Aldarme/PROJECT_CHAMP/Gantt/calendrier_Previsionnel_portrait.pdf

Projet_CHAMP | 1 juil. 2018
Laboratoire de Physique nucléaire et des Hautes Energies | http://

Chef de projet
Dates du projet | 5 févr. 2018 - 14 juil. 2018
Avancée | 0%
Tâches | 39
Ressources | 0

Nom | Date de début | Date de fin
Arrivé & prise de contact | 05/02/2018 | 09/02/2018
Prise en main du projet | 12/02/2018 | 16/02/2018
Découverte & apprentissage du VHDL | 19/02/2018 | 20/02/2018
mise en pratique VHDL | 22/02/2018 | 28/02/2018
Prototype maquette piano à une touche | 01/03/2018 | 18/05/2018
Module accéléromètre | 01/03/2018 | 23/03/2018
étude comparative I2C vs SPI | 01/03/2018 | 02/03/2018
étude des registres de contrôle à paramétrer | 05/03/2018 | 06/03/2018
Hack du controle SPI accéléromètre | 07/03/2018 | 09/03/2018
Dev. code VHDL communication accéléromètre | 12/03/2018 | 23/03/2018
Module FIltre | 26/03/2018 | 20/04/2018
Acquisition des données | 26/03/2018 | 27/03/2018
caractérisation des données et interprétation | 28/03/2018 | 30/03/2018
Asservissement numérique | 03/04/2018 | 20/04/2018
expérence en labo pour production des données | 03/04/2018 | 06/04/2018
étude de graph-établir fonction de transfère | 09/04/2018 | 13/04/2018
calcule de la fonction de transfère | 16/04/2018 | 18/04/2018
intégration fonction transfère au module vhdl | 19/04/2018 | 20/04/2018
Module DAC | 23/04/2018 | 18/05/2018
reception des données | 23/04/2018 | 24/04/2018
transmision sous module SPI | 25/04/2018 | 26/04/2018
Adaptation module spi existant | 27/04/2018 | 02/05/2018
configuration des registre de contrôle du DAC | 03/05/2018 | 04/05/2018
mesure physique en sortie de DAC et débugage | 07/05/2018 | 18/05/2018
Conception carte électronique | 23/05/2018 | 21/06/2018
formation au plassement routage sous KICAD | 23/05/2018 | 24/05/2018
PCB miniaturisation accéléromètre | 25/05/2018 | 01/06/2018
PCB amplificateur de signaux | 04/06/2018 | 08/06/2018
PCB mezzanine - carte à connecteurs | 11/06/2018 | 15/06/2018
formation production & assemblage des cartes | 18/06/2018 | 21/06/2018
mesure et caractérisation de la chaine de contrôle | 22/06/2018 | 06/07/2018
caractérisation de l'accélération fournie par l'accélérpmètre | 22/06/2018 | 25/06/2018
expérimentation des diffénrents mode de contrôle fournie par le contrôleur moteur | 26/06/2018 | 28/06/2018
conception d'une maquette pour caractériser le contrôle "TORQUE" du contôleur | 29/06/2018 | 04/07/2018
exploitation des données | 05/07/2018 | 06/07/2018
prototype maquette piano à 12 touches | 09/07/2018 | 13/07/2018
déploiement de generate pour dupliquer les module accéléromètre et filtre | 09/07/2018 | 10/07/2018
adaptation du vhdl pour intégration module DAC à la réception des modules dupliqués | 11/07/2018 | 12/07/2018
Projet_CHAMP | 1 juil. 2018
Tâches | 2

Nom | Date de début | Date de fin
test | 13/07/2018 | 13/07/2018

## Tâches

## Diagramme de Gantt

Nom | Date de... | Date de fin
Arrivé & prise de contact | 05/02/2... 09/02/2018
Prise en main du projet | 12/02/2... 16/02/2018

Découverte & apprentissage ...19/02/2... 20/02/2018

mise en pratique VHDL | 22/02/2... 28/02/2018

Prototype maquette piano à ... 01/03/2... 18/05/2018

Module accéléromètre | 01/03/2... 23/03/2018

étude comparative I2... 01/03/2... 02/03/2018

étude des registres de...05/03/2... 06/03/2018

Hack du controle SPI ... 07/03/2... 09/03/2018

Dev. code VHDL com... 12/03/2... 23/03/2018

Module FIltre | 26/03/2... 20/04/2018

Acquisition des données26/03/2... 27/03/2018

caractérisation des do... 28/03/2... 30/03/2018

Asservissement numé... 03/04/2... 20/04/2018

expérence en labo ...03/04/2... 06/04/2018

étude de graph-ét... 09/04/2... 13/04/2018

calcule de la foncti... 16/04/2... 18/04/2018

intégration fonctio... 19/04/2... 20/04/2018

Module DAC | 23/04/2... 18/05/2018

reception des données 23/04/2... 24/04/2018

transmision sous mod... 25/04/2... 26/04/2018

Adaptation module sp... 27/04/2... 02/05/2018

configuration des regi... 03/05/2... 04/05/2018

mesure physique en s... 07/05/2... 18/05/2018

Conception carte électronique 23/05/2... 21/06/2018

formation au plassement ...23/05/2... 24/05/2018

PCB miniaturisation accél... 25/05/2... 01/06/2018

PCB amplificateur de sign...04/06/2... 08/06/2018

PCB mezzanine - carte à ... 11/06/2... 15/06/2018

formation production & a... 18/06/2... 21/06/2018

mesure et caractérisation de... 22/06/2... 06/07/2018

caractérisation de l'accél... 22/06/2... 25/06/2018

expérimentation des diffé...26/06/2... 28/06/2018

conception d'une maque... 29/06/2... 04/07/2018

exploitation des données 05/07/2... 06/07/2018

prototype maquette piano à ... 09/07/2... 13/07/2018

déploiement de generate... 09/07/2... 10/07/2018

adaptation du vhdl pour i... 11/07/2... 12/07/2018

test | 13/07/2... 13/07/2018

2018

Semaine 8 | Semaine 9 | Semaine 10 | Semaine 11 | Semaine 12 | Semaine 13 | Semaine 14 | Semaine 15 | Semaine 16 | Semaine 17 | Semaine 18 | Semaine 19 | Semaine 20 | Semaine 21 | Semaine 22 | Semaine 23 | Semaine 24
18/02/2018 | 25/02/2018 | 04/03/2018 | 11/03/2018 | 18/03/2018 | 25/03/2018 | 01/04/2018 | 08/04/2018 | 15/04/2018 | 22/04/2018 | 29/04/2018 | 06/05/2018 | 13/05/2018 | 20/05/2018 | 27/05/2018 | 03/06/2018 | 10/06/2018

## Diagramme des Ressources

Nom | Rôle par déf...

2018

Semaine 8 | Semaine 9 | Semaine 10 | Semaine 11 | Semaine 12 | Semaine 13 | Semaine 14 | Semaine 15 | Semaine 16 | Semaine 17 | Semaine 18 | Semaine 19 | Semaine 20 | Semaine 21 | Semaine 22 | Semaine 23 | Semaine 24
18/02/2018 | 25/02/2018 | 04/03/2018 | 11/03/2018 | 18/03/2018 | 25/03/2018 | 01/04/2018 | 08/04/2018 | 15/04/2018 | 22/04/2018 | 29/04/2018 | 06/05/2018 | 13/05/2018 | 20/05/2018 | 27/05/2018 | 03/06/2018 | 10/06/2018
