Aldarme/PROJECT_CHAMP/Gantt/calendrier_reel_portrait.pdf

Projet_CHAMP | 1 juil. 2018
Laboratoire de Physique nucléaire et des Hautes Energies | http://

Chef de projet
Dates du projet | 5 févr. 2018 - 14 juil. 2018
Avancée | 0%
Tâches | 44
Ressources | 0

Nom | Date de début | Date de fin
Arrivé & prise de contact | 05/02/2018 | 09/02/2018
Prise en main du projet | 12/02/2018 | 16/02/2018
Découverte & apprentissage du VHDL | 19/02/2018 | 20/02/2018
mise en pratique VHDL | 22/02/2018 | 28/02/2018
Prototype maquette piano à une touche | 01/03/2018 | 10/07/2018
Module accéléromètre | 01/03/2018 | 23/03/2018
étude comparative I2C vs SPI | 01/03/2018 | 02/03/2018
étude des registres de contrôle à paramétrer | 05/03/2018 | 06/03/2018
Hack du controle SPI accéléromètre | 07/03/2018 | 09/03/2018
Dev. code VHDL communication accéléromètre | 12/03/2018 | 23/03/2018
Module FIltre | 26/03/2018 | 20/04/2018
Acquisition des données | 26/03/2018 | 27/03/2018
caractérisation des données et interprétation | 28/03/2018 | 30/03/2018
Asservissement numérique | 03/04/2018 | 20/04/2018
expérence en labo pour production des données | 03/04/2018 | 06/04/2018
étude de graph-établir fonction de transfère | 09/04/2018 | 13/04/2018
calcule de la fonction de transfère | 16/04/2018 | 18/04/2018
intégration fonction transfère au module vhdl | 19/04/2018 | 20/04/2018
Module DAC | 23/04/2018 | 18/05/2018
reception des données | 23/04/2018 | 24/04/2018
transmision sous module SPI | 25/04/2018 | 26/04/2018
Adaptation module spi existant | 27/04/2018 | 02/05/2018
configuration des registre de contrôle du DAC | 03/05/2018 | 04/05/2018
mesure physique en sortie de DAC | 07/05/2018 | 18/05/2018
debuggage chaine de meusure | 18/05/2018 | 10/07/2018
caractérisatoin problèmes de métastabilité | 22/05/2018 | 24/05/2018
intégration de librairie Altera | 25/05/2018 | 28/05/2018
mise à jours des modules défectueux | 18/05/2018 | 29/05/2018
test de contrôle & validation | 29/05/2018 | 10/07/2018
formation au plassement routage sous KICAD | 23/05/2018 | 21/06/2018
formation au plassement routage sous KICAD | 23/05/2018 | 24/05/2018
PCB miniaturisation accéléromètre | 25/05/2018 | 01/06/2018
PCB amplificateur de signaux | 04/06/2018 | 08/06/2018
PCB mezzanine - carte à connecteurs | 11/06/2018 | 15/06/2018
formation production & assemblage des cartes | 18/06/2018 | 21/06/2018
prototype maquette piano à 12 touches | 09/07/2018 | 13/07/2018
déploiement de generate pour dupliquer les module accéléromètre et filtre | 09/07/2018 | 10/07/2018
adaptation du vhdl pour intégration module DAC à la réception des modules dupliqués | 11/07/2018 | 12/07/2018
test | 13/07/2018 | 13/07/2018
Projet_CHAMP | 1 juil. 2018
Tâches | 2

Nom | Date de début | Date de fin
mesure et caractérisation de la chaine de contrôle | 22/06/2018 | 06/07/2018
caractérisation de l'accélération fournie par l'accélérpmètre | 22/06/2018 | 25/06/2018
expérimentation des diffénrents mode de contrôle fournie par le contrôleur moteur | 26/06/2018 | 28/06/2018
conception d'une maquette pour caractériser le contrôle "TORQUE" du contôleur | 29/06/2018 | 04/07/2018
exploitation des données | 05/07/2018 | 06/07/2018
Tâches | 3

## Diagramme de Gantt

4

Nom | Date d... | Date de fin
Arrivé & prise de contact | 05/02/... 09/02/2018
Prise en main du projet | 12/02/... 16/02/2018

Découverte & apprentissag... 19/02/... 20/02/2018

mise en pratique VHDL | 22/02/... 28/02/2018

Prototype maquette piano ... 01/03/... 10/07/2018

Module accéléromètre 01/03/... 23/03/2018

étude comparative I... 01/03/... 02/03/2018

étude des registres ... 05/03/... 06/03/2018

Hack du controle SPI... 07/03/... 09/03/2018

Dev. code VHDL co... 12/03/... 23/03/2018

Module FIltre | 26/03/... 20/04/2018

Acquisition des donn... 26/03/... 27/03/2018

caractérisation des d...28/03/... 30/03/2018

Asservissement num...03/04/... 20/04/2018

expérence en lab... 03/04/... 06/04/2018

étude de graph-é... 09/04/... 13/04/2018

calcule de la fonc...16/04/... 18/04/2018

intégration foncti... 19/04/... 20/04/2018

Module DAC | 23/04/... 18/05/2018

reception des données23/04/... 24/04/2018

transmision sous mo... 25/04/... 26/04/2018

Adaptation module s... 27/04/... 02/05/2018

configuration des re... 03/05/... 04/05/2018

mesure physique en... 07/05/... 18/05/2018

debuggage chaine de ... 18/05/... 10/07/2018

caractérisatoin probl... 22/05/... 24/05/2018

intégration de librairi...25/05/... 28/05/2018

mise à jours des mo... 18/05/... 29/05/2018

test de contrôle & va...29/05/... 10/07/2018

formation au plassement ro...23/05/... 21/06/2018

formation au plassemen...23/05/... 24/05/2018

PCB miniaturisation acc... 25/05/... 01/06/2018

PCB amplificateur de sig...04/06/... 08/06/2018

PCB mezzanine - carte à...11/06/... 15/06/2018

formation production & ... 18/06/... 21/06/2018

prototype maquette piano ... 09/07/... 13/07/2018

déploiement de generat... 09/07/... 10/07/2018

adaptation du vhdl pou... 11/07/... 12/07/2018

test | 13/07/... 13/07/2018

mesure et caractérisation d...22/06/... 06/07/2018

caractérisation de l'accé...22/06/... 25/06/2018

expérimentation des dif... 26/06/... 28/06/2018

conception d'une maqu... 29/06/... 04/07/2018

exploitation des données 05/07/... 06/07/2018

janvier 2018 | février 2018 | mars 2018
29 | 30 | 31

1

2

5

6

7

8

9 | 12 | 13 | 14 | 15 | 16 | 19 | 20 | 21 | 22 | 23 | 26 | 27 | 28

1

2

5

6

7

8

9 | 12 | 13 | 14 | 15 | 16 | 19 | 20 | 21 | 22 | 23 | 26 | 27 | 28 | 29

Arrivé & prise de contact

## Diagramme des Ressources

5

Nom | Rôle par déf...
janvier 2018 | février 2018 | mars 2018
29 | 30 | 31

1

2

5

6

7

8

9 | 12 | 13 | 14 | 15 | 16 | 19 | 20 | 21 | 22 | 23 | 26 | 27 | 28

1

2

5

6

7

8

9 | 12 | 13 | 14 | 15 | 16 | 19 | 20 | 21 | 22 | 23 | 26 | 27 | 28 | 29
