Aldarme/PROJECT_CHAMP/PCB/KIONIX-KX224/Liste_composants_KX224.pdf

Nom de la carte | Eval_board KX224
Expérience | CHAMP
Date | 12/11/2018
Version | 2
Auteur | Pierre ROMET
Type | Référence | Quantitée | Description
Accéléromètre | Kx1 | 1 | KX224
Connecteur | J1 | 1 | Pitch 2,54
Condensateur | C1 | 1 | CMS_0805 100nF
| C2 | 1 | CMS_0603 100nF
Total: | 4
