Aldarme/PROJECT_CHAMP/PCB/ST-AIS3624/liste_composants_AIS3624.pdf

Nom de la carte | Eval_board AIS36924DQ
Expérience | CHAMP
Date | 12/11/2018
Version | 2
Auteur | Pierre ROMET
Type | Référence | Quantitée | Description
Accéléromètre | ACC1 | 1 | ADXL355
Connecteur | J1 | 1 | Pitch 2,54
Jumper | JP2 | 1 | CMS_0805
Condensateur | C1 | 1 | CMS_0603 100nF
| C2 | 1 | CMS_0603 10uF
Total: | 5
