Aldarme/PROJECT_CHAMP/ST50_Docs/Presentation/Soutenance_P18_INFO_ST50_ROMETPierre.odp

## ST50 : Stage longue durée - Cycle ingénieur

Contrôle haptique et asservissement de la mécanique des pianos à queue de concert.

Professeur suiveur : GECHTER Franck

Tuteur de stage : LEBBOLO Hervé

Elève : ROMET Pierre - Département Informatique

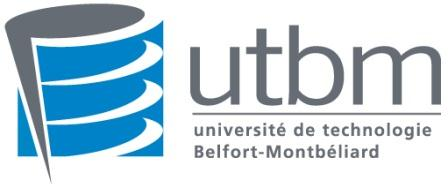
[picture p63: figure]

## Sommaire

- Présentation du laboratoire
- Mon projet : « Contrôle haptique et asservissement de la mécanique des pianos à queue de concert »
- Retour sur le stage

## Présentation du laboratoire

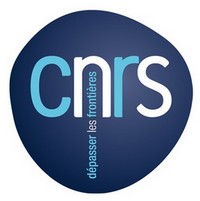
[picture p64: figure]

## Présentation du laboratoire

- Masses et intéractions Fondamentales
  ATLAS - CALICE
- Asymétrie matière/antimatière
  LHCB - T2K
- Rayonnement cosmique et matière noire
  DAMIC - HESS
- Cosmologie et énergie noire
  LSST - SSIP

## Le projet « CHAMP »

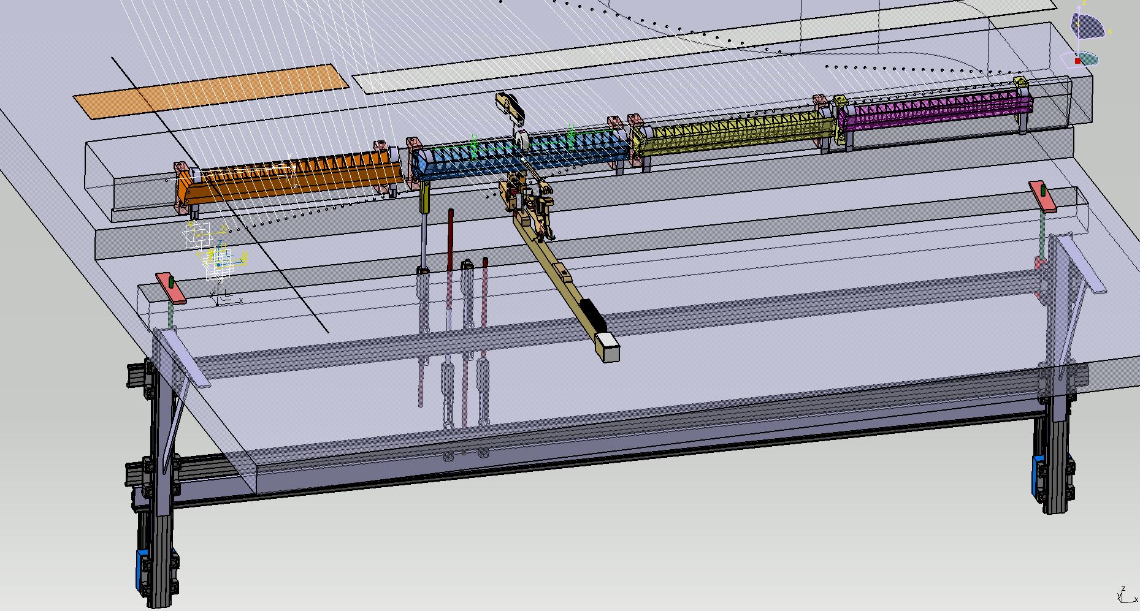
[picture p65: figure]
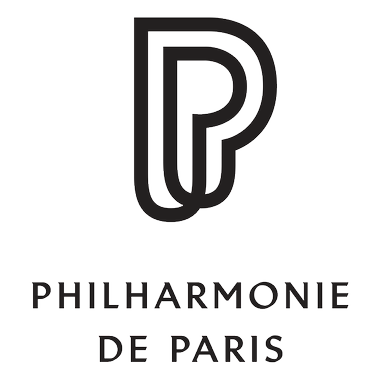
[picture p66: figure]

## Le projet « CHAMP » - Introduction

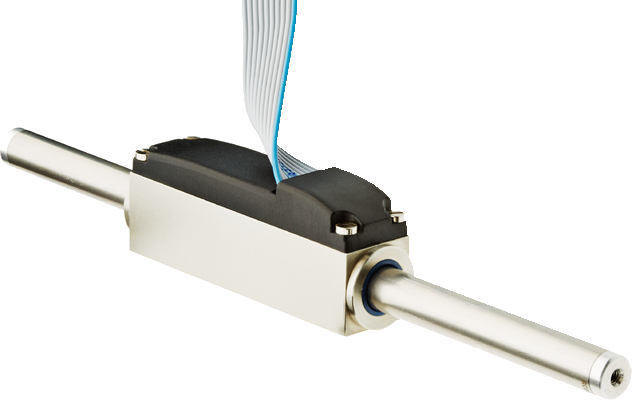
[picture p67: figure]
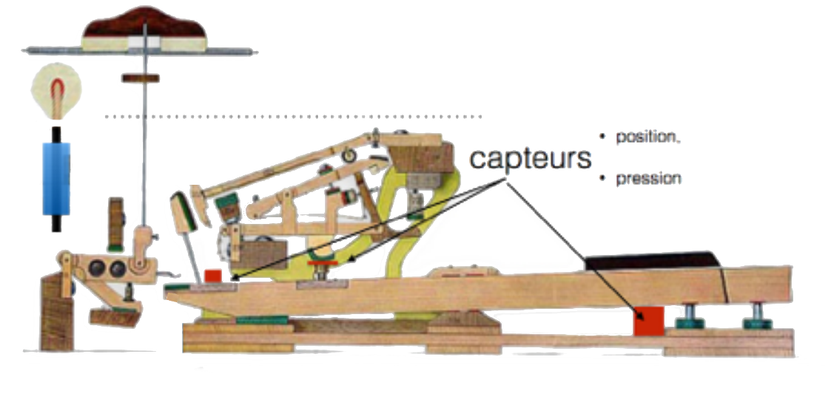
[picture p68: figure]
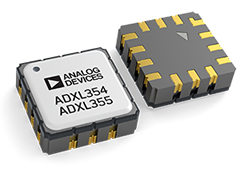
[picture p69: figure]

## Le projet « CHAMP » - Introduction

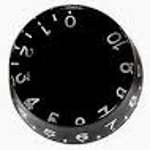
[picture p70: figure]

Accélération

Marteau retenu

→ Corde étouffée

Accélération

Marteau libre

→ Corde libre

Accélération

Marteau freiné

→ Corde libre

Harmoniques variables

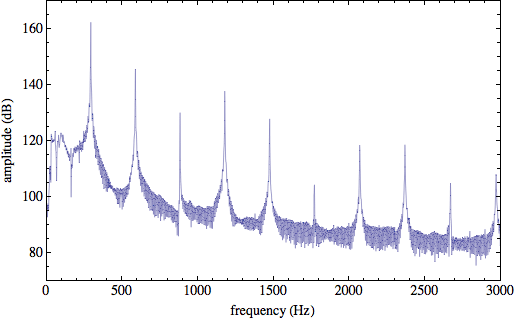
[picture p71: figure]

Harmonique constante

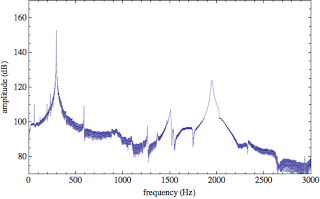
[picture p72: figure]

## Le projet « CHAMP » - Introduction

Asservissement

&

caractérisation


Chaîne de contrôle


## Le projet « CHAMP » - Introduction

Asservissement

&

caractérisation

Chaîne de contrôle

## Le projet « CHAMP » - Asservissement


## Le projet « CHAMP » - Asservissement


## Le projet « CHAMP » - Asservissement


## Le projet « CHAMP » - Asservissement


## Conclusion

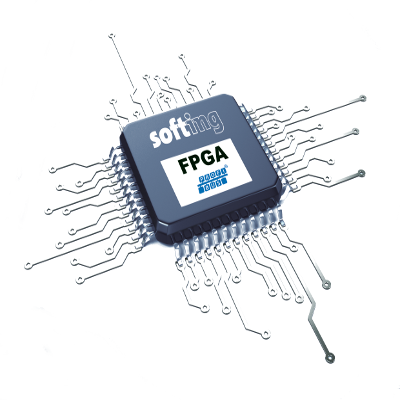
[picture p73: figure]
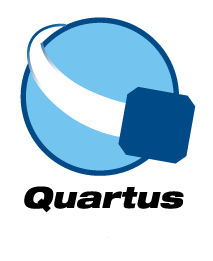
[picture p74: figure]
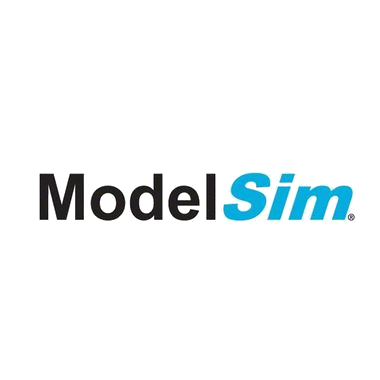
[picture p75: figure]

VHDL


## Merci de votre attention

ST50 : Stage longue durée - Cycle ingénieur

Contrôle haptique et asservissement de la mécanique des pianos à queue de concert.

Professeur suiveur : GECHTER Franck

Tuteur de stage : LEBBOLO Hervé

Elève : ROMET Pierre - Département Informatique
