Aldarme/PROJECT_CHAMP/ST50_Docs/Presentation/TX52_ROMETPierre.odp

## TX52 : Projet de recherche

Développement d’un banc de test intelligent connecté

Professeur encadrant : Franck GECHTER

Elève : Pierre ROMET

Département Informatique


## Sommaire

- Descriptif & Existant
- Partie Hardware
- Partie Software
- Conclusion

## Descriptif Du Projet

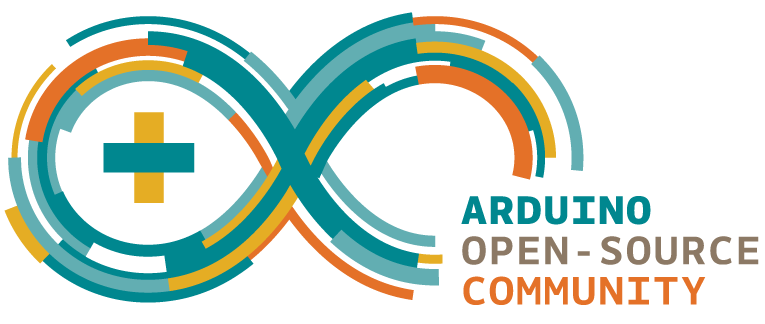
[picture p76: figure]
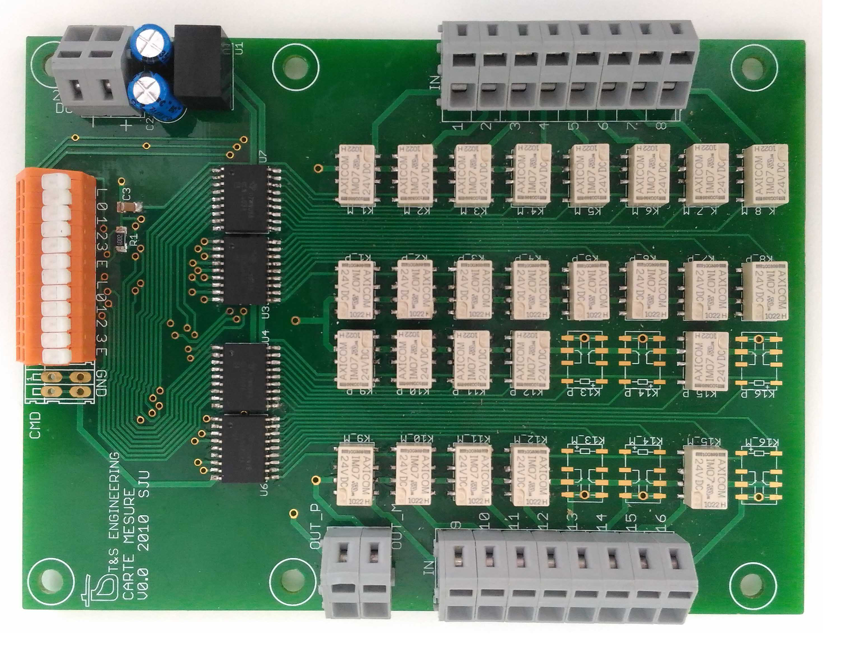
[picture p77: figure]
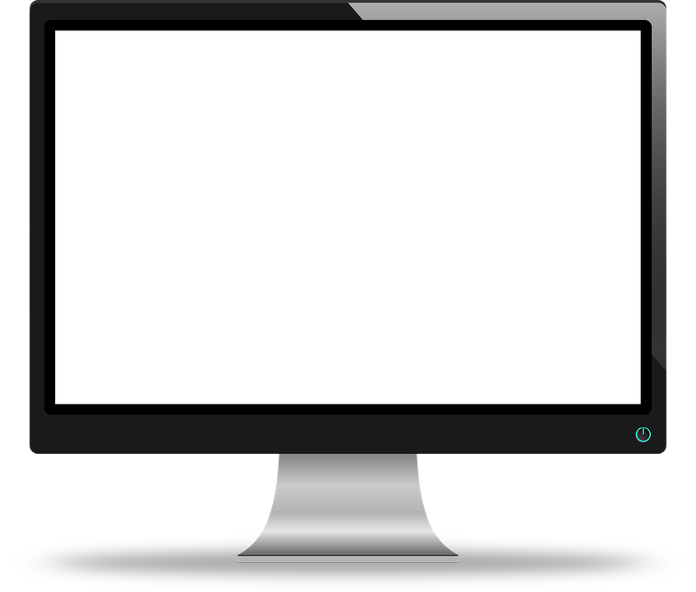
[picture p78: figure]
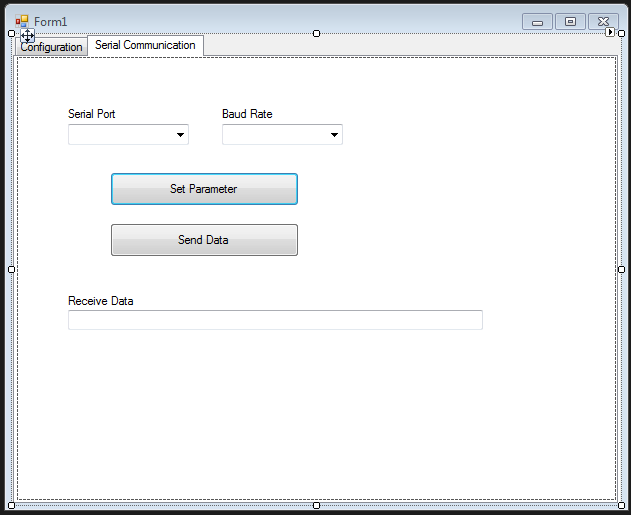
[picture p79: figure]

  Banc de test

Liaison

Série

## Existant

Ernie Ball / Music man – GAME CHANGER

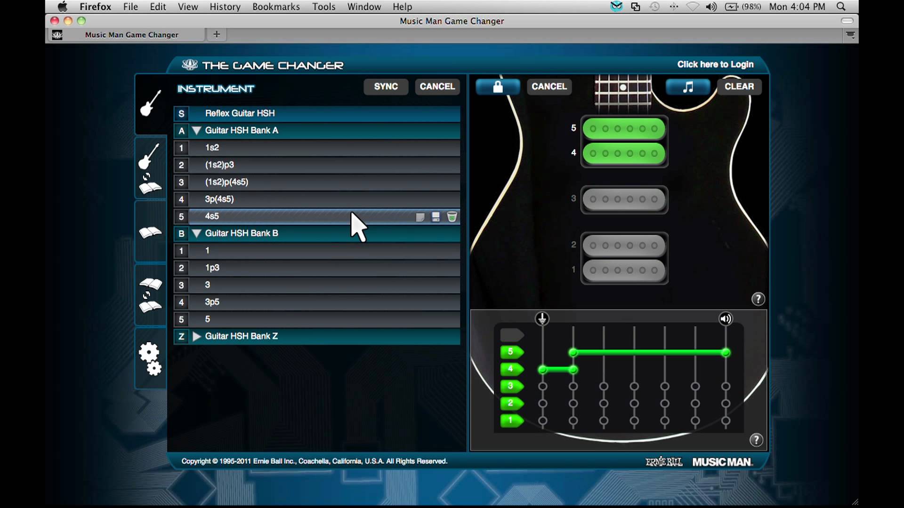
[picture p80: figure]

## Partie Hardware

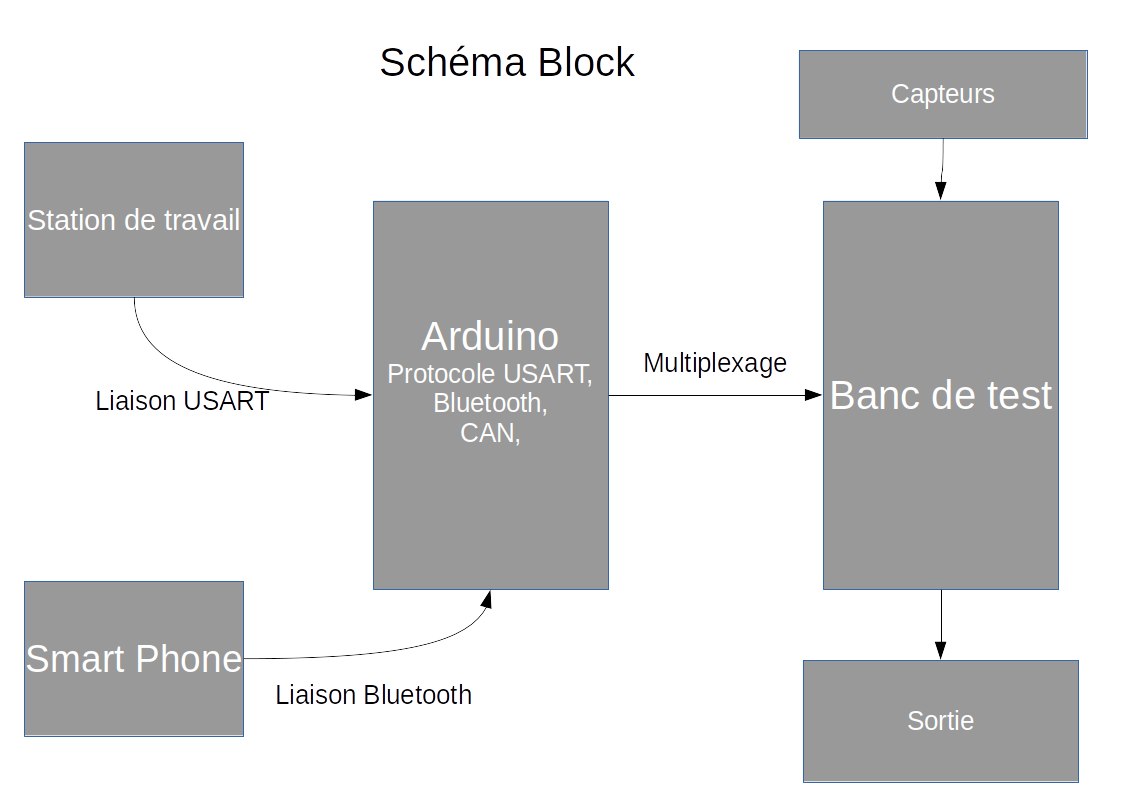
[picture p81: figure]

## Partie Hardware

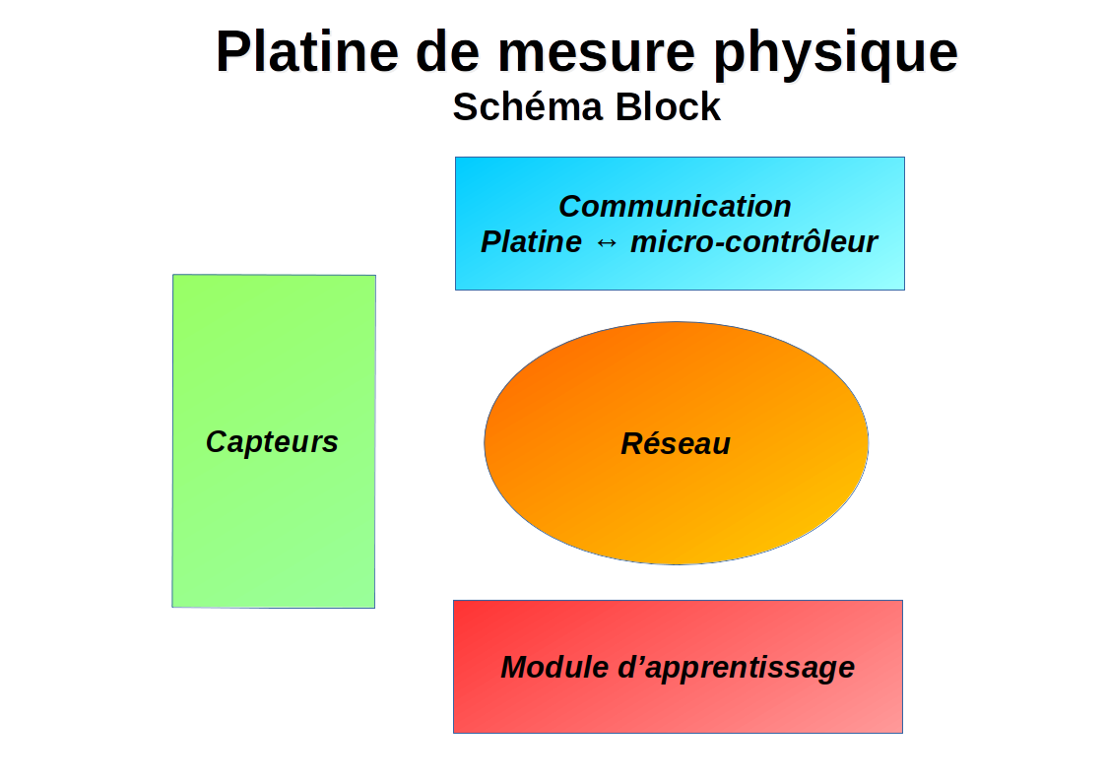
[picture p82: figure]

## Partie Hardware

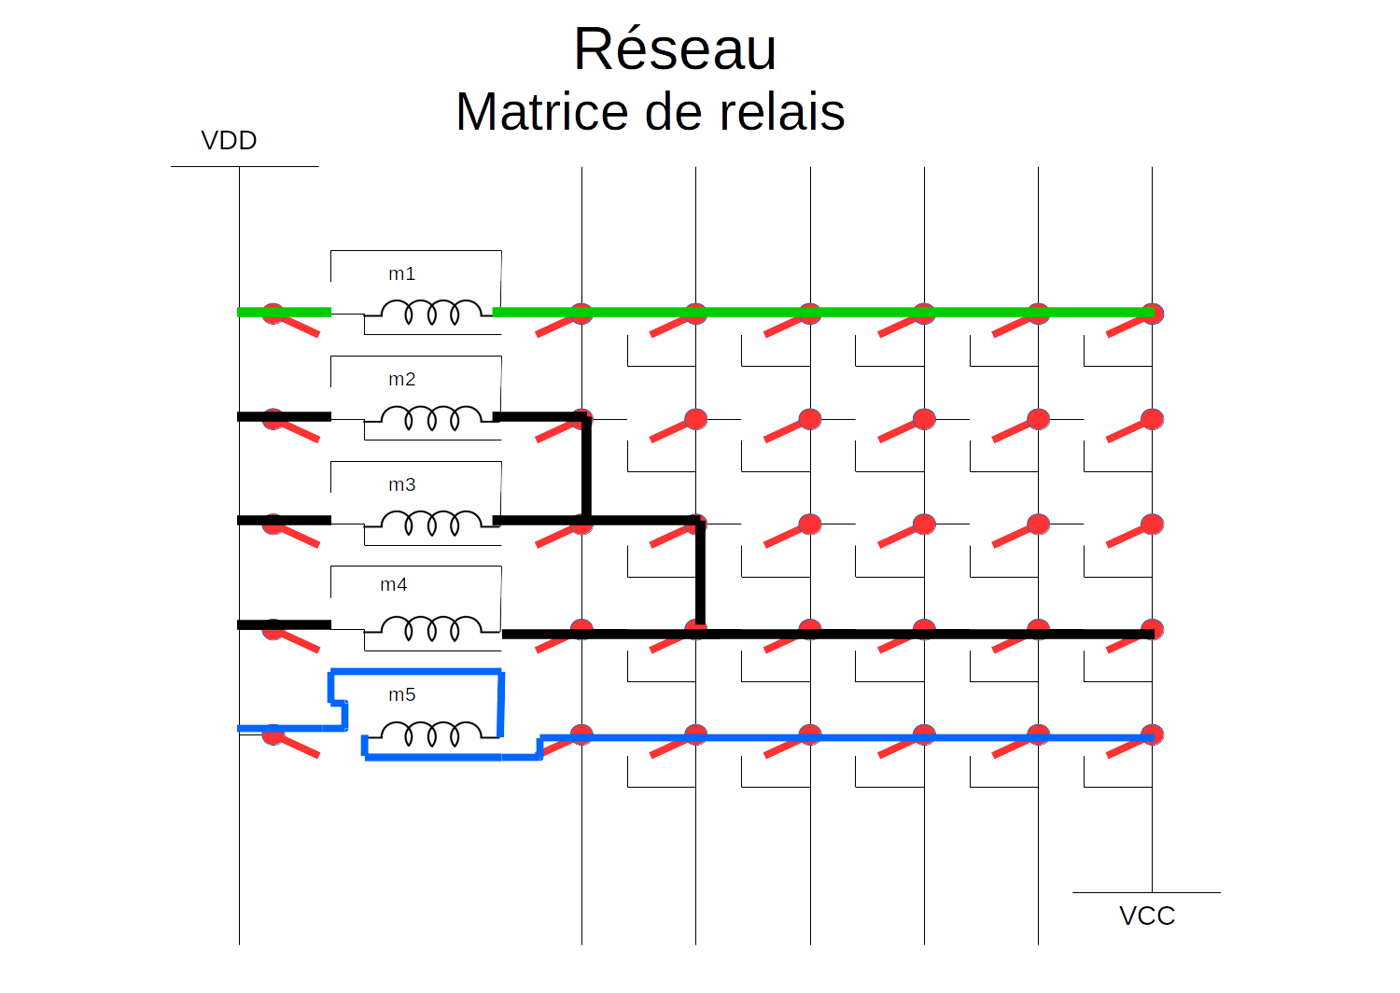
[picture p83: figure]

Multiplexeur

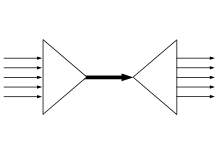
[picture p84: figure]

## Partie Hardware

Multiplexeur

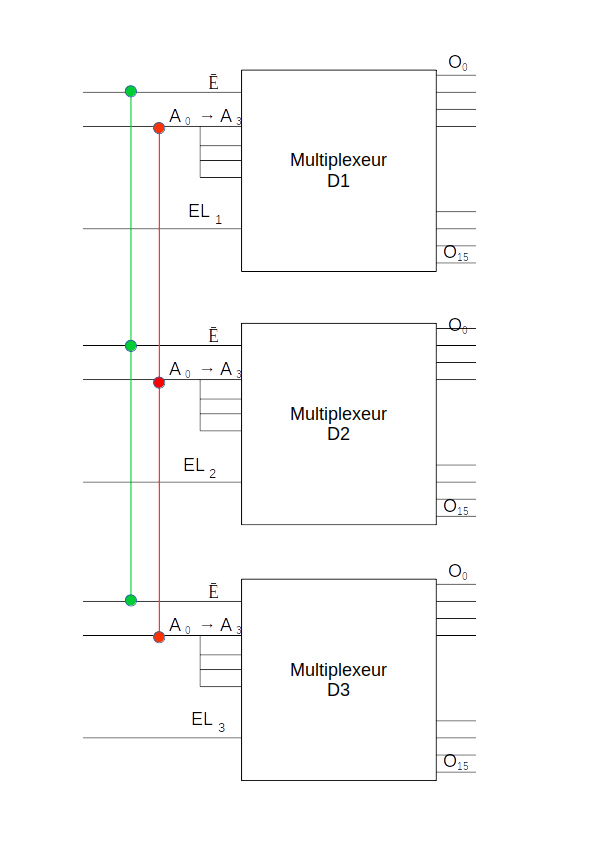
[picture p85: figure]
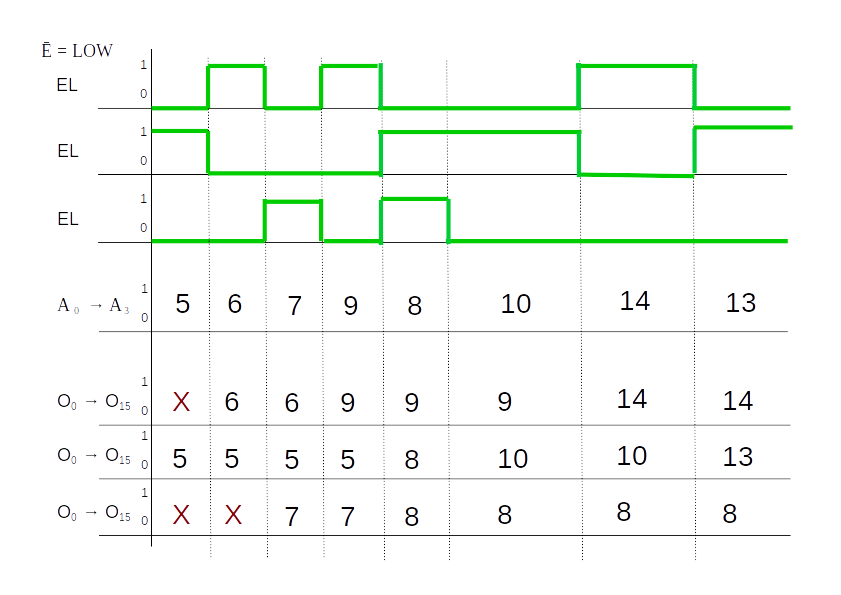
[picture p86: figure]

## Partie Hardware

Mode d’apprentissage

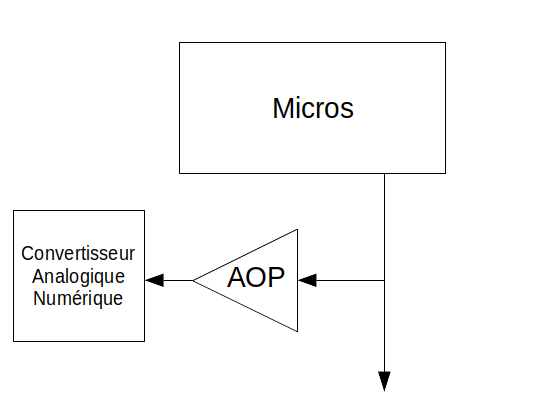
[picture p87: figure]
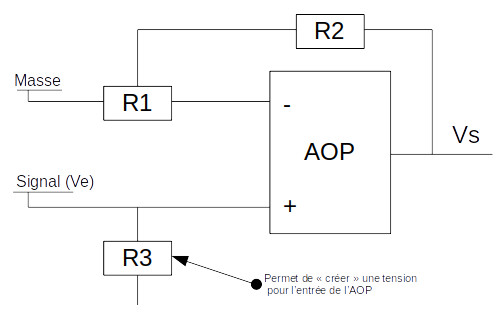
[picture p88: figure]
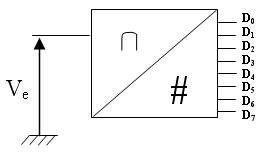
[picture p89: figure]

## Partie Hardware

Mode d’apprentissage

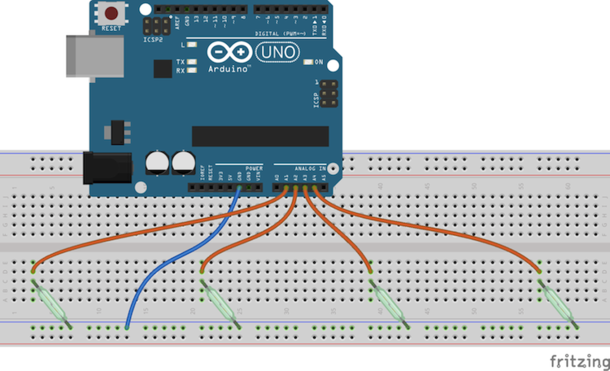
[picture p90: figure]
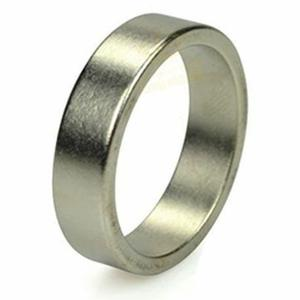
[picture p91: figure]

## Partie Software

## Partie Software

  Communication Série - ComUart

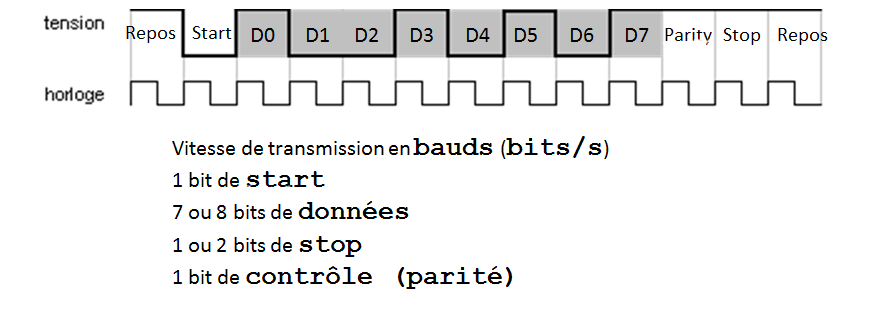
[picture p92: figure]

## Partie Software

Interface C# - Configuration & Réglage

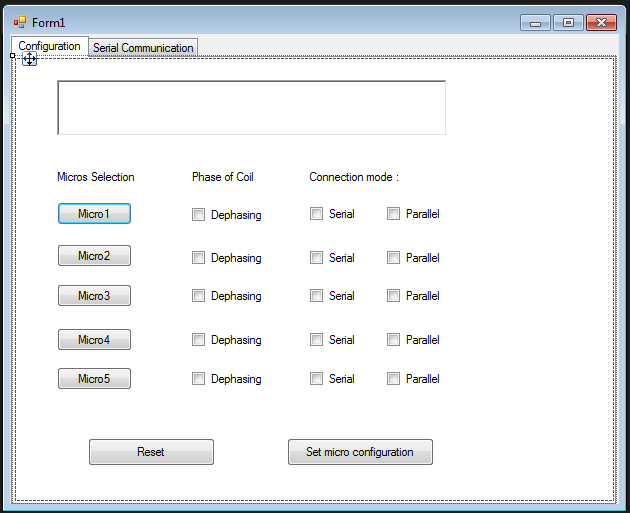
[picture p93: figure]

## Partie Software

Interface C# - Configuration & Réglage

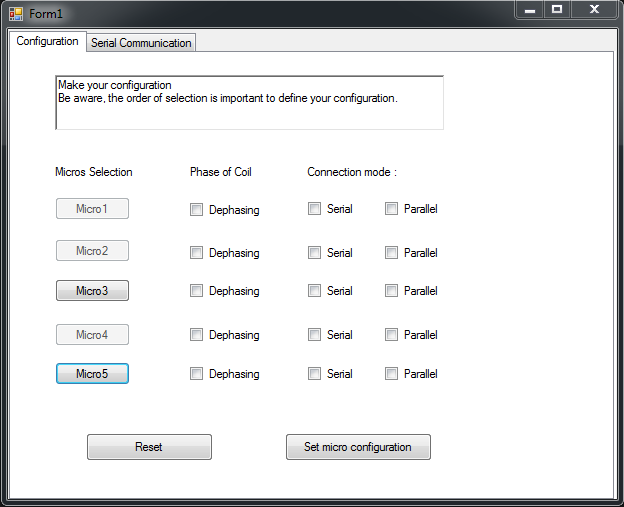
[picture p94: figure]

## Partie Software

Interface C# - Configuration & Réglage

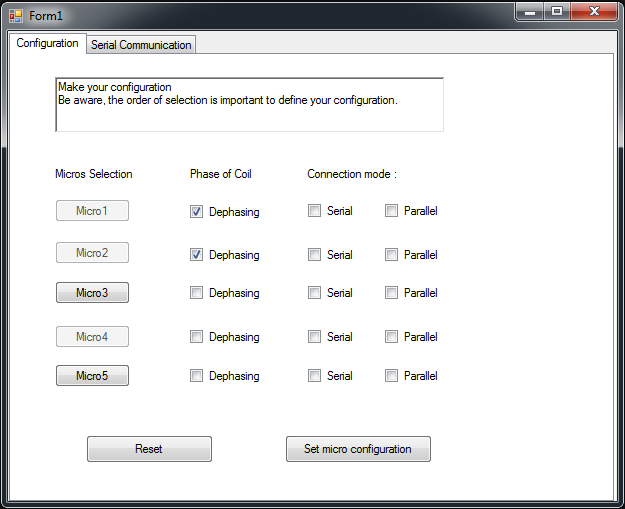
[picture p95: figure]

## Partie Software

Interface C# - Configuration & Réglage

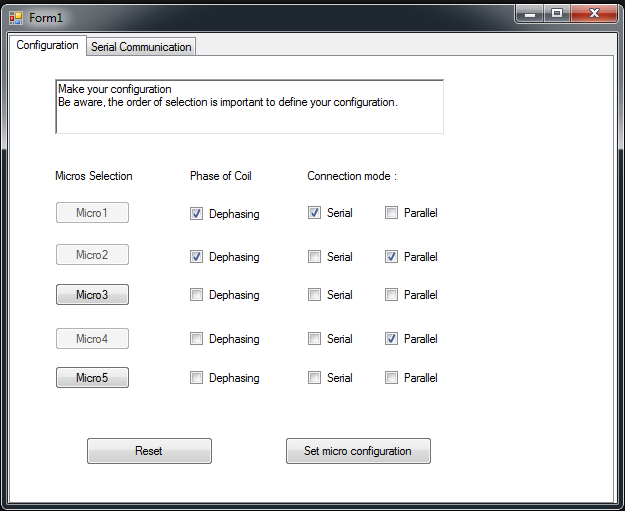
[picture p96: figure]

## Partie Software

Interface C# - Liaison Série

## Conclusion

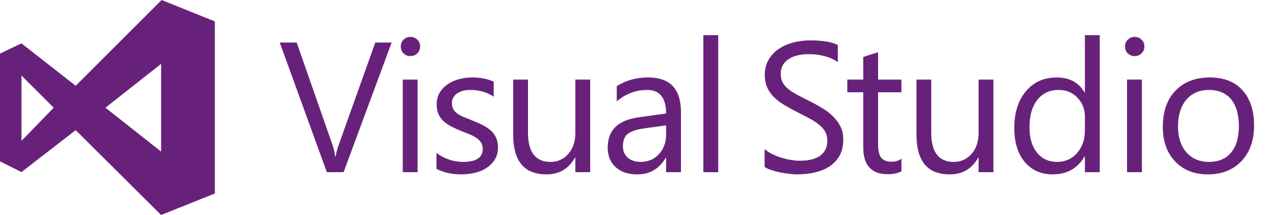
[picture p97: figure]
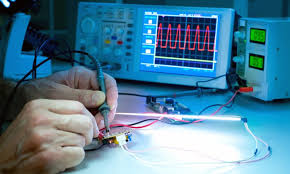
[picture p98: figure]
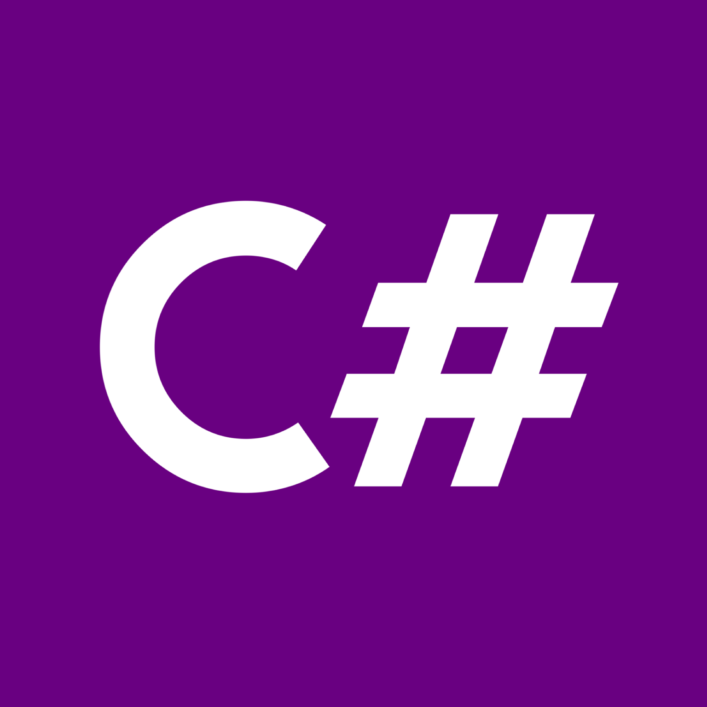
[picture p99: figure]

## Merci de votre attention

TX52 : Projet de Recherche

Développement d’un banc de test intelligent connecté

Professeur encadrant : Franck GECHTER

Elève : Pierre ROMET

Département Informatique
