Aldarme/PROJECT_CHAMP/ST50_Docs/rapport/calendrier_Previsionnel_defB.pdf

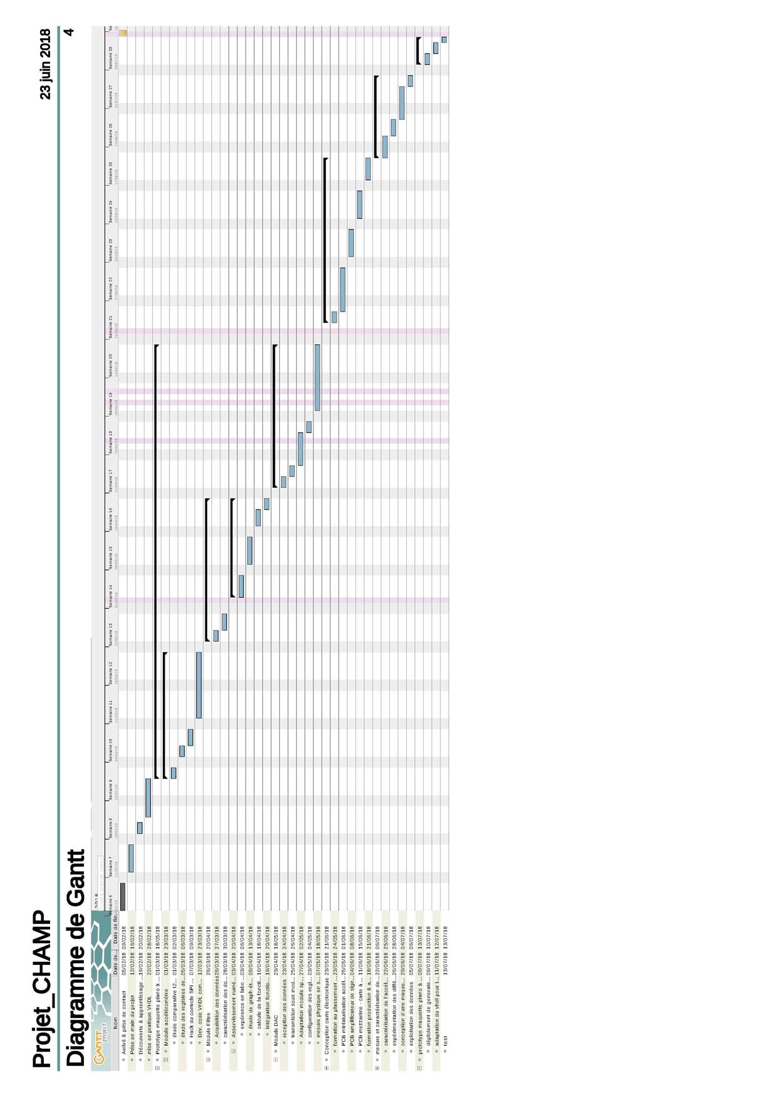
[picture p128: page 1]
