Aldarme/PROJECT_CHAMP/ST50_Docs/rapport/calendrier_reel_defB.pdf

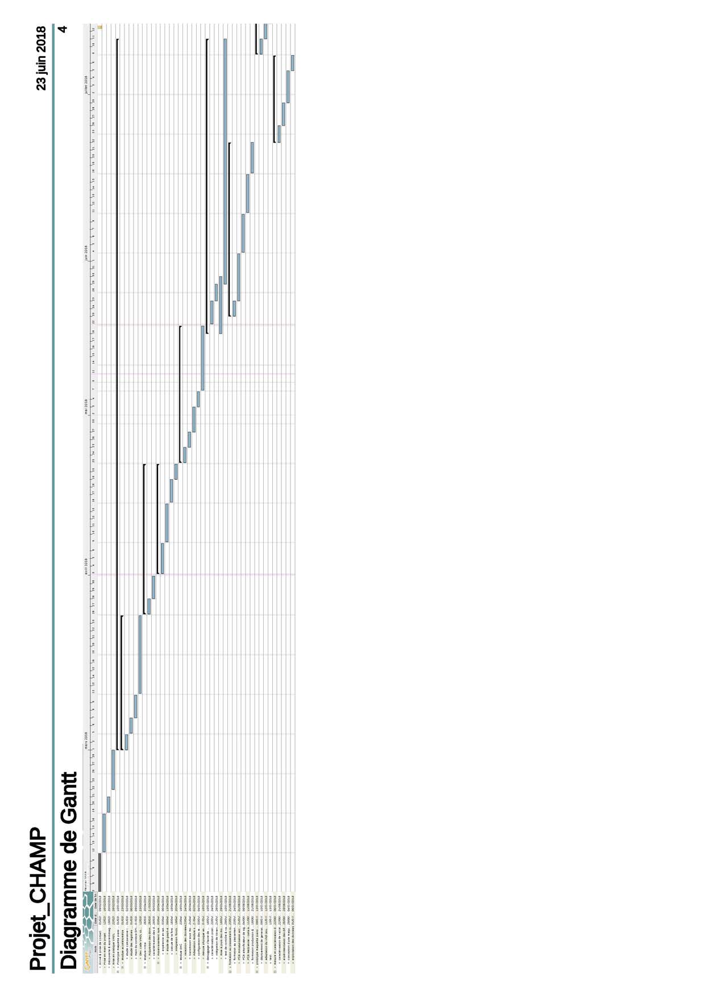
[picture p129: page 1]
