Aldarme/PROJECT_CHAMP/ST50_Docs/rapport/M_FICHE_LIAISON_MEZZA.pdf

INFORMATIONS GÉNÉRALES
Pierre ROMET | Nom de la carte : | Mezzanine_monoAcc | Version KICAD | 4.0.7
Date : | 24/05/18 | FICHE DE LIAISON SCHEMA-PCB
Quantité ? | 1 | Expérience : | CHAMP | Délais en jours : | jours | Placeur routeur : | Pierre ROMET

Concepteur :

Répertoire de la carte :
Le schéma a t il été packagé ? | Oui | ☒ | Non | ☐
Quel est le rôle de la carte? | Carte de connexion au FPGA pour accéléromètres et DAC
Un placement routage doit il être récupéré ? | Oui | ☐ | Non | ☒ | Précision :
DIMENSIONS
Quelles sont les dimensions de la carte ? | Standard : | ☒ | Précision (VME, PXI) :
Imposées : | ☐ | Précision (en mm) :
Libres : | Oui | ☐ | Non | ☐

Précision :

Y a t il une épaisseur maximum ? | Oui | ☐ | Non | ☒
| | ☒ | Non | ☐ | Précision :

MÉCANIQUE
Y a t il des trous de fixations ? | Oui | ☒ | Non | ☐
Y a t il une face avant ? | Oui | ☐ | Non | ☒ | Précision :
Y a t il des connecteurs de liaisons ? | Oui
Si oui, avez vous un plan coté ? | Oui | ☐ | Non | ☒ | Dimensions
☐ | 10 | ☐

EMPILEMENT
Quelles sont les différentes alimentations?
Combien y a t il de couche ? | 2
☐ | 14 | ☐ | + de 14
☒ | 4 | ☐ | 6 | ☐ | 8
| | | | ☐
Fabrication de la carte en interne ? | Oui | ☒ | Non | ☐

12

Définition de l'empilement ? | TOP | IN1 | IN2
IN3 | IN4 | IN5 | IN6

BOTTOM

IN7 | IN8 | IN9

☒

IN10
IN11 | IN12
| | ☐ | Non | ☒ | Sur quelles couches ?

TECHNOLOGIE
Utilisation de la technologie Pad on Hole ou Via in Pad | Oui | ☐ | Non
Y a t il des impédances contrôlées entre des plans ? | Oui | ☐ | Non | ☒ | Entre quelles couches?
Y a t il des impédance contrôlées sur un plan ? | Oui

Si oui quels sont les signaux concernés ?
Avez vous calculé la taille du fil ? | Oui | ☐ | Non | ☒ | Quelle taille en mm ?
Quel est l'épaisseur du diélectrique ? | Quelle est la valeur du diélectrique ?
SIGNAUX SENSIBLES
Y a t il des paires différentielles ? | Oui | ☐ | Non | ☒
Si oui quels sont leurs noms ?
Y a t il une ou des couches dédiées? | Oui | ☐ | Non | ☒ | Lesquelles ?
| | | | | Lesquelles ?
Y a t il des bus ? | Oui | ☒ | Non | ☐ | Lesquels ?
| | ☒ | Non | ☐ | Lesquels ? | SPI
Y a t il une ou des couches dédiées? | Oui | ☐ | Non | ☒
| | | | | | SPI
Y a t il une ou des couches dédiées? | Oui | ☐ | Non | ☒ | Lesquelles ?
Y a t il d'autres signaux sensibles ? | Oui

COMPOSANTS SENSIBLES
Y a t il des composants sensibles ? | Oui | ☒ | Non | ☐ | Lesquels ? | ADXL355
Y a t il des composants avec Pad Thermique ? | Oui | ☐ | Non | ☒ | Lesquels ?
Y a t il des BGAs ? | Oui | ☐ | Non | ☒ | Lesquels ?
| Oui | ☐ | Non | ☒ | Lesquels ?
| | | CÂBLAGE
Câblage de la carte en interne ? | Oui | ☒ | Non | ☐ | Par quelle société ?

Y a t il des nouveaux composants?

DEVIS
Wurth Elektronik | Oui | ☐ | Non | ☒ | CIRE SPCI | Oui | ☐ | Non | ☒ | CSI | Oui | ☐ | Non | ☒
CIRLY | Oui | ☐ | Non | ☒ | TECH-CI | Oui | ☐ | Non | ☒ | Cirex | Oui | ☐ | Non | ☒
PCB Electronic | Oui | ☐ | Non | ☒ | CIBEL | Oui
| | | | | | Oui | ☐
| | | | | | | ☐ | Non | ☒ | CIBEL
INTERNE | Oui | ☒ | Non | ☐ | Non | ☐ | 24/05/18
| | | | | | | | | | | Oui | ☐ | Non | ☒
