Aldarme/PROJECT_CHAMP/ST50_Docs/rapport/PLAN_PERCAGE_MEZZA.pdf

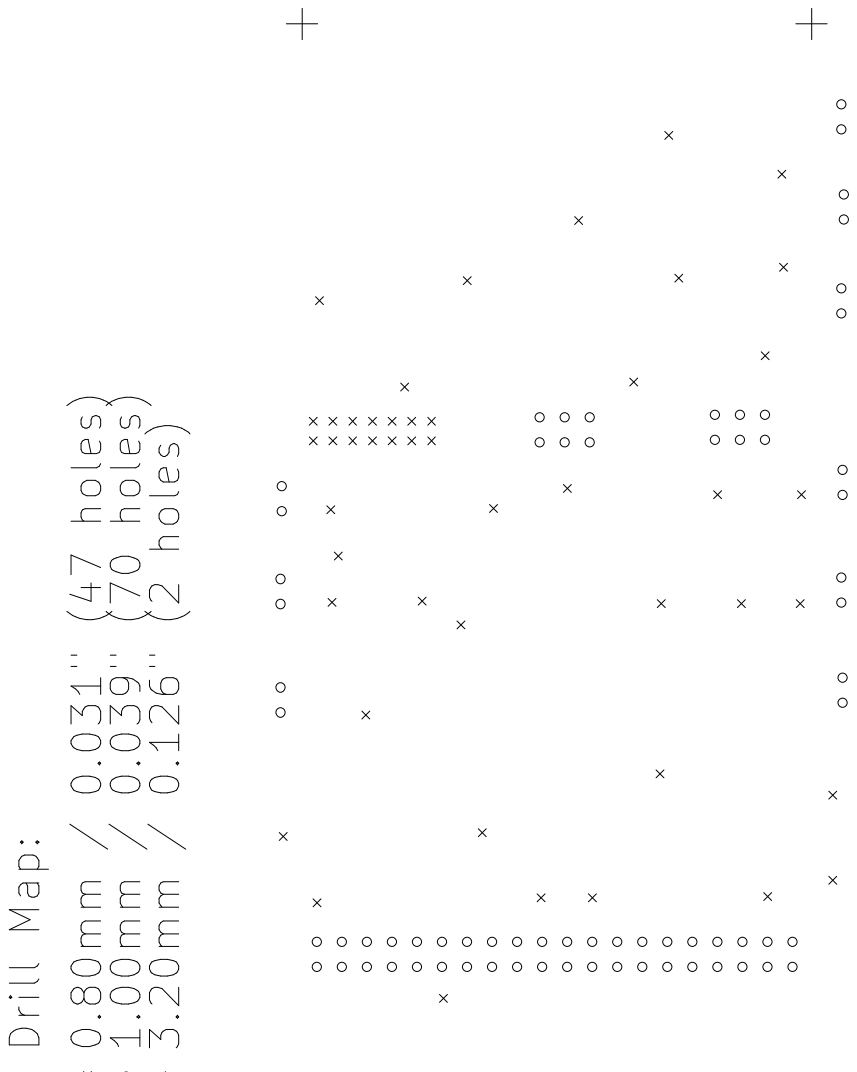
[picture p130: page 1]
