Aldarme/PROJECT_CHAMP/ST50_Docs/rapport/AOP_PLAN_PERCAGE_OPBANDAOP.pdf

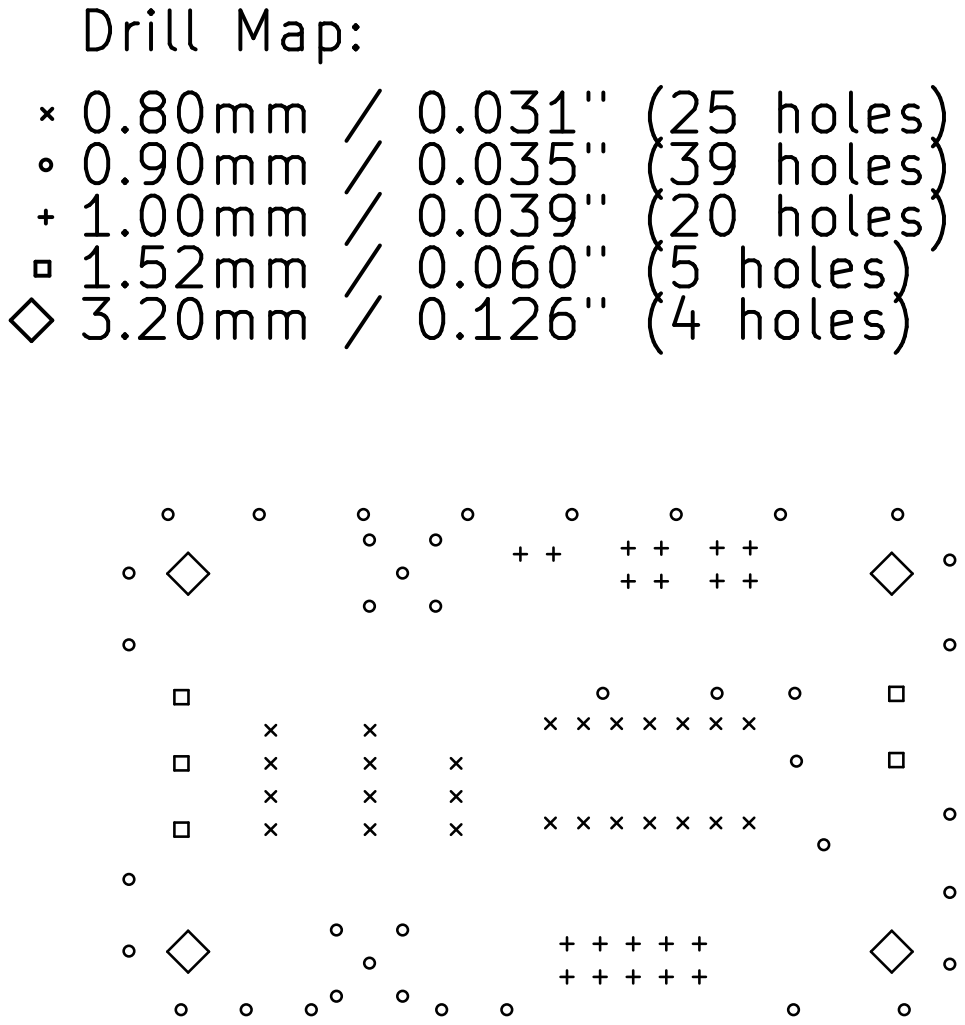
[picture p141: page 1]
