Aldarme/PROJECT_CHAMP/ST50_Docs/rapport/FICHIER_DIMENSION_EVALBOARD.pdf

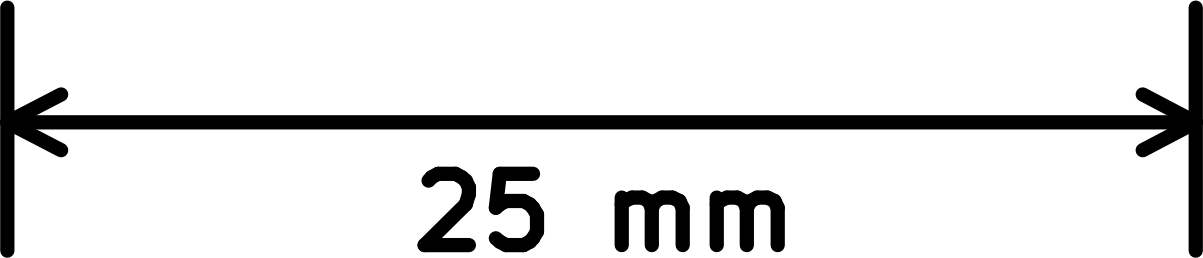
[picture p142: figure]
