Aldarme/PROJECT_CHAMP/ST50_Docs/rapport/AOP_FICHE_LIAISON_OPBANDAOP.pdf

29/03/18 | FICHE DE LIAISON SCHEMA-PCB
| INFORMATIONS GÉNÉRALES
Concepteur : | H.Lebbolo | Nom de la carte : | OPBANDAOP | Version Kicad | 4,1
| 1 | | CHAMP | | jours

Répertoire de la carte :

Le schéma a t il été packagé ? | Oui | x | Non | ☐
Quel est le rôle de la carte? | Permettre la connexion de plusieurs capteurs optiques et d'un contacteur mécanique.
Oui | ☐ | Non | x
DIMENSIONS
Quelles sont les dimensions de la carte ? | Standard : | x | Précision (VME, PXI) :
| Imposées : | ☐ | Précision (en mm) :
Libres : | Oui | ☐ | Non | ☐
Y a t il une épaisseur maximum ? | Oui | ☐ | Non | x
MÉCANIQUE
Y a t il des trous de fixations ? | Oui | x | Non | ☐ | Précision :
Y a t il des connecteurs de liaisons ? | Oui | x | Non | ☐ | Précision :
Y a t il une face avant ? | Oui | ☐ | Non | x | Précision :
Si oui, avez vous un plan coté ? | Oui | ☐ | Non | x | Dimensions
EMPILEMENT
Quelles sont les différentes alimentations?
Combien y a t il de couche ? | 2 | x | 4 | ☐ | 6 | ☐ | 8 | ☐ | 10 | ☐
| 12 | ☐ | 14 | ☐ | + de 14 | ☐ | Si Possible
Fabrication de la carte en interne ? | Oui | x | Non | ☐
Définition de l'empilement ? | TOP | | | | IN1 | | | | IN2
| IN3 | | IN4 | | IN5 | | IN6
| IN7 | | IN8 | | IN9 | | IN10
IN11 | | IN12 | | BOTTOM
TECHNOLOGIE
Utilisation de la technologie Pad on Hole ou Via in Pad | Oui | ☐ | Non | x
Y a t il des impédance contrôlées sur un plan ? | Oui | ☐ | Non | x | Sur quelles couches ?
Y a t il des impédances contrôlées entre des plans ? | Oui | ☐ | Non | x | Entre quelles couches?

Si oui quels sont les signaux concernés ?
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
