Aldarme/PROJECT_CHAMP/ST50_Docs/BHLS-CNRS-UPMC-LPNHE-IRCAM.pdf

## Paris, janvier 2016

# Projet interdisciplinaire musique/acoustique/physique

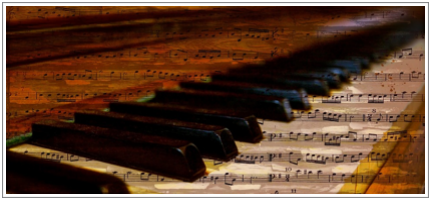
[picture p143: figure]

# Asservissement de la mécanique des pianos de concert

Laurent Bessières , Thomas Hélie , Hervé Lebbolo , Antoine Letessier Selvon ¹ | 2 | 3 | 3
MÉCANIQUE BLS | 1

Technicien piano à la Philharmonie de Paris, Mairie de Paris, Ministère de la culture ¹
2 Institut de Recherche et Coordination Acoustique/Musique IRCAM, CNRS-UPMC
3 Laboratoire du Physique Nucléaire et des Hautes Énergies LPNHE, CNRS-IN2P3, UPMC
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
