Aldarme/PROJECT_CHAMP/Asservissement/courbe/largeurImp&AnIn/image_graph/AnIn-Torque_1v.png

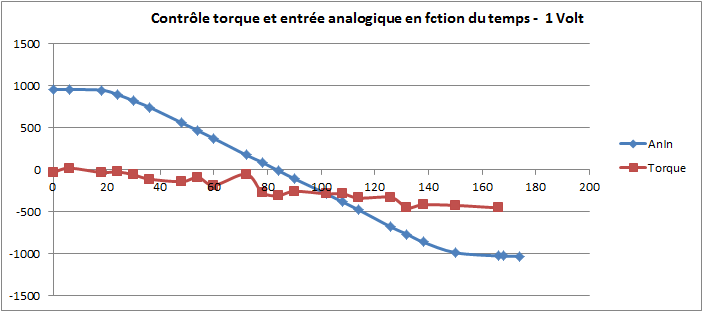
Asservissement/courbe/largeurImp&AnIn/image_graph/AnIn-Torque_1v.png
