Aldarme/PROJECT_CHAMP/PCB/accel_evalBoard/Docs/1.0/accel_evalBoard1_3D.png

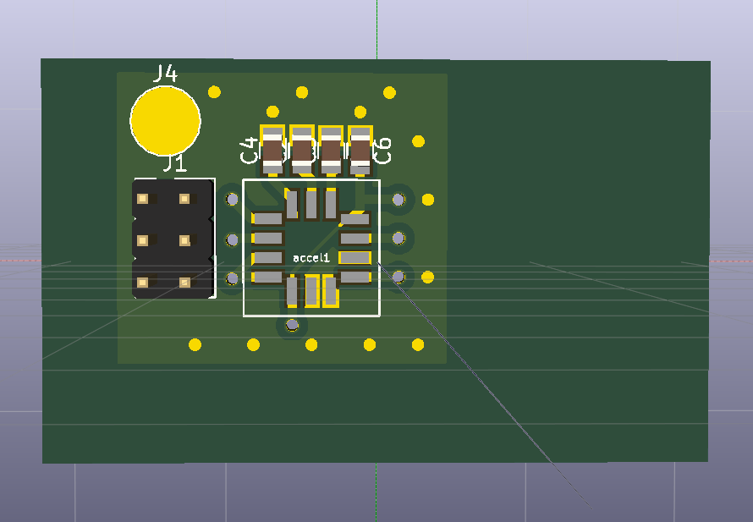
PCB/accel_evalBoard/Docs/1.0/accel_evalBoard1_3D.png
