Aldarme/PROJECT_CHAMP/PCB/accel_evalBoard/Docs/1.0/ADXL355_footprint.PNG

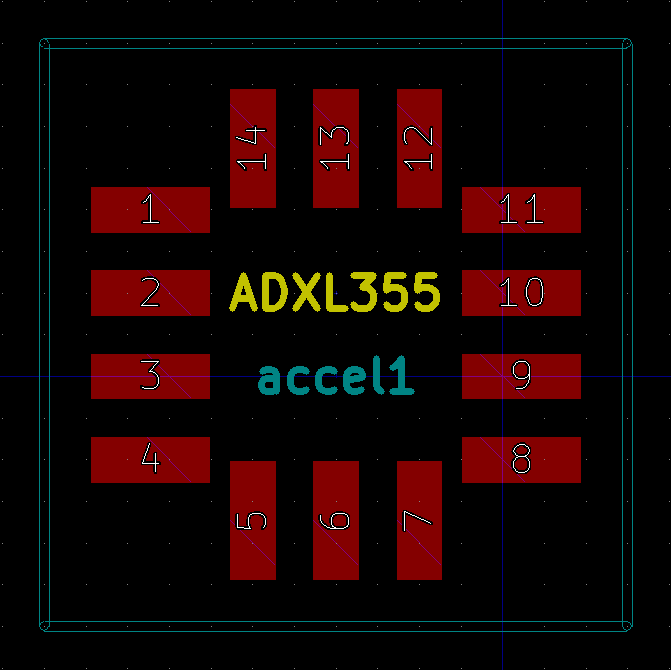
PCB/accel_evalBoard/Docs/1.0/ADXL355_footprint.PNG
