Aldarme/PROJECT_CHAMP/PCB/accel_evalBoard/Docs/1.0/PCB.PNG

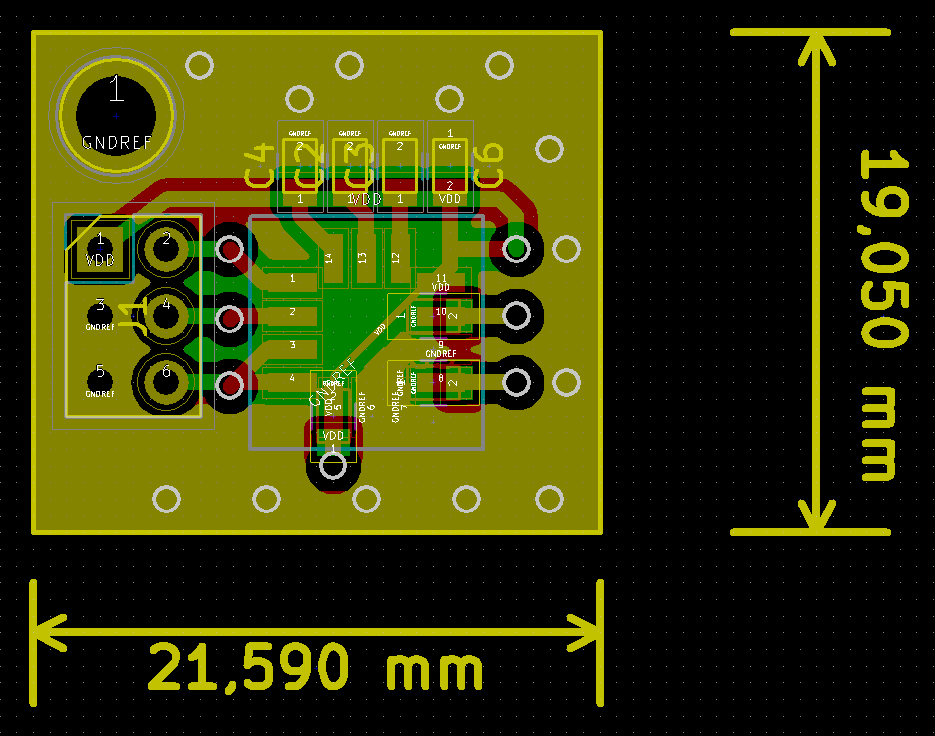
PCB/accel_evalBoard/Docs/1.0/PCB.PNG
