Aldarme/PROJECT_CHAMP/PCB/accel_evalBoard/Docs/1.0/PCB_BUTTOM.PNG

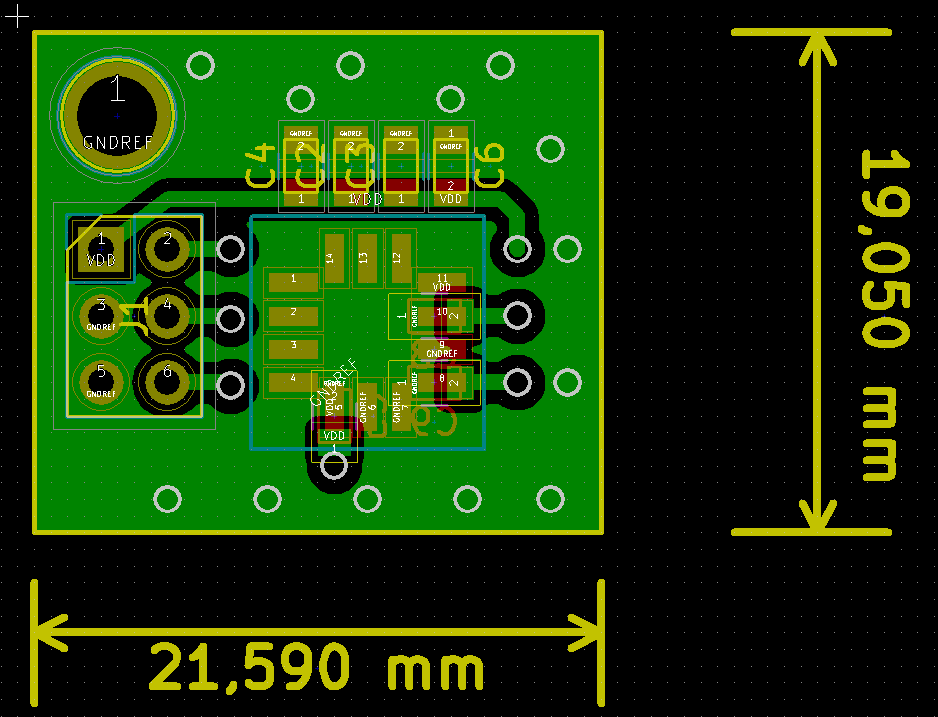
PCB/accel_evalBoard/Docs/1.0/PCB_BUTTOM.PNG
