Aldarme/PROJECT_CHAMP/PCB/accel_evalBoard/Docs/2.3/PCB_TOP.PNG

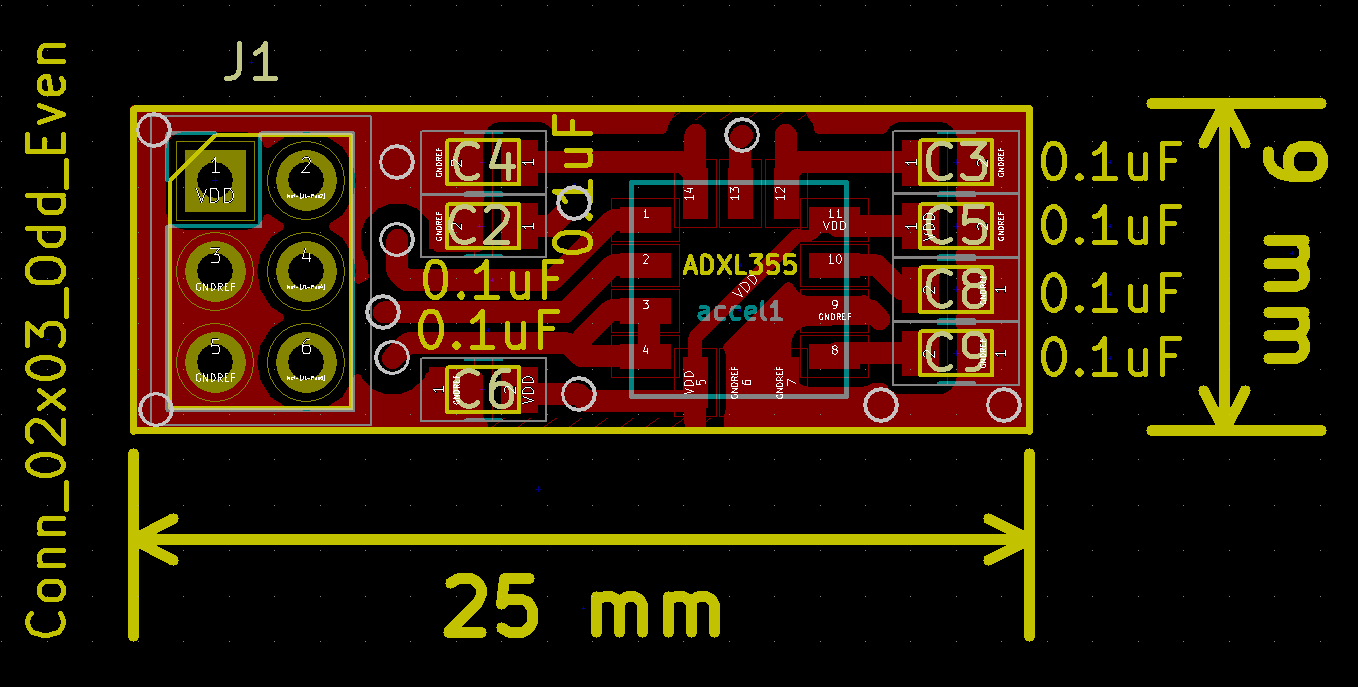
PCB/accel_evalBoard/Docs/2.3/PCB_TOP.PNG
