Aldarme/PROJECT_CHAMP/PCB/OPB821S/Docs/OPB&AOP_2.PNG

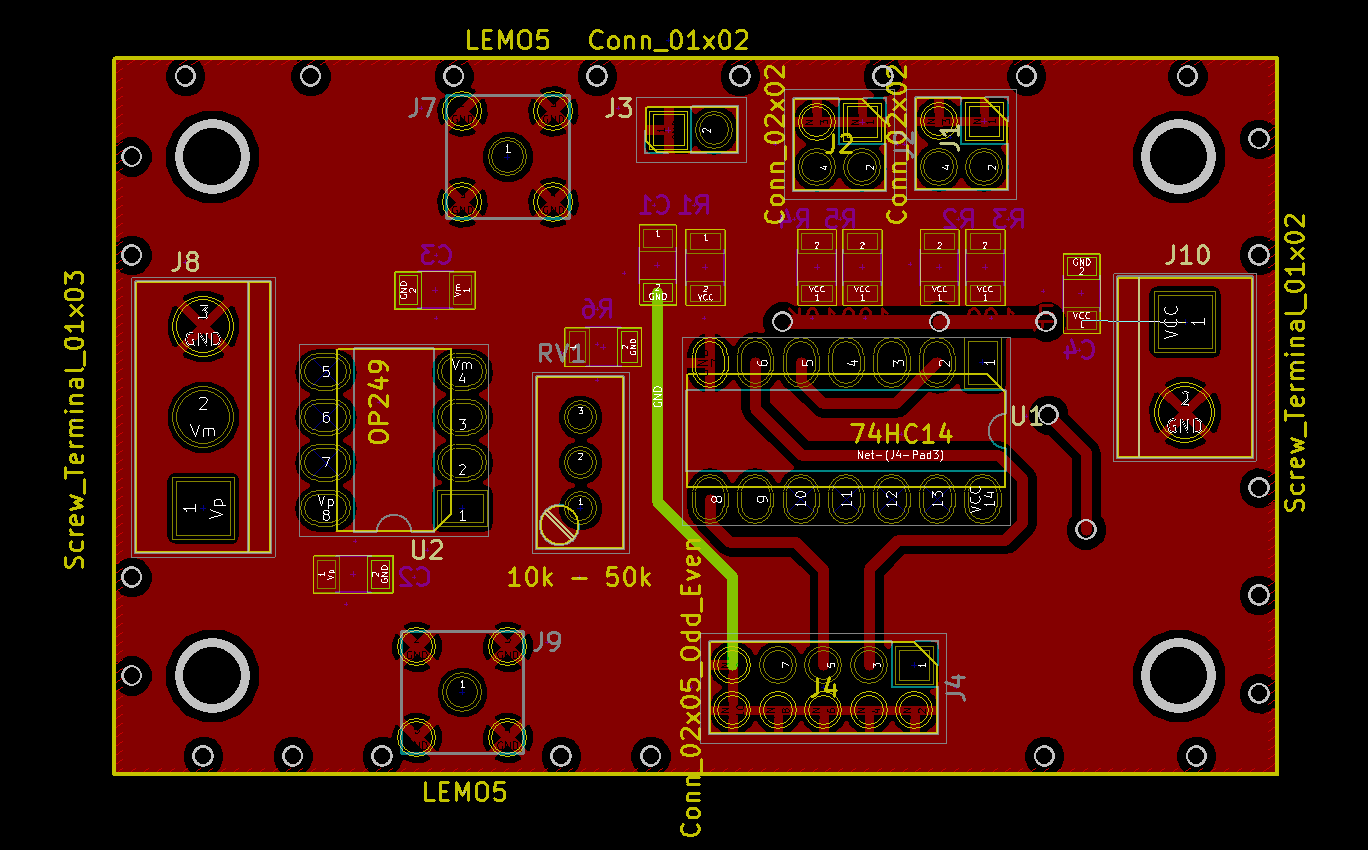
PCB/OPB821S/Docs/OPB&AOP_2.PNG
