Aldarme/PROJECT_CHAMP/PCB/OPB821S/Docs/OPB&AOP_3.PNG

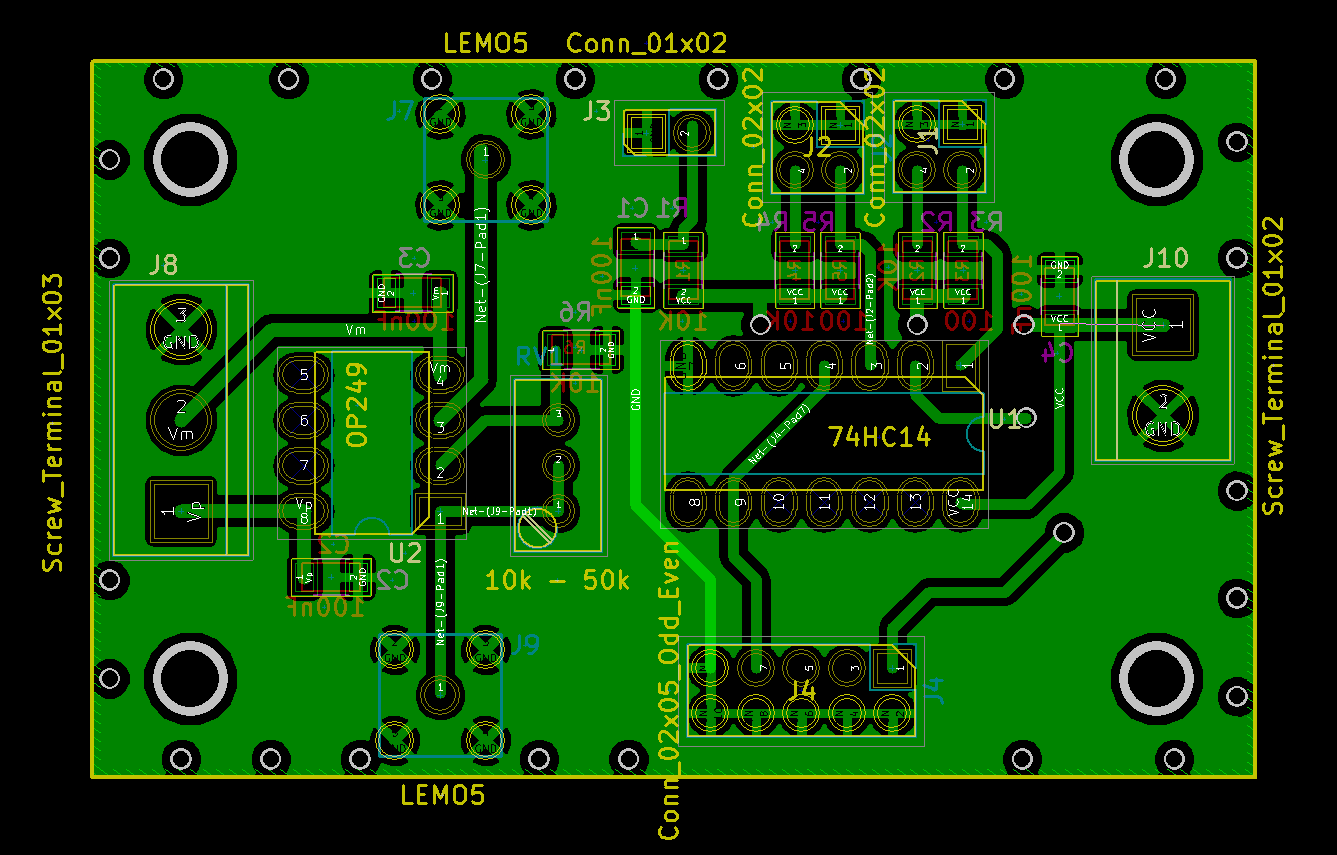
PCB/OPB821S/Docs/OPB&AOP_3.PNG
