Aldarme/PROJECT_CHAMP/PCB/OPB821S/Docs/OPB&AOP_5.PNG

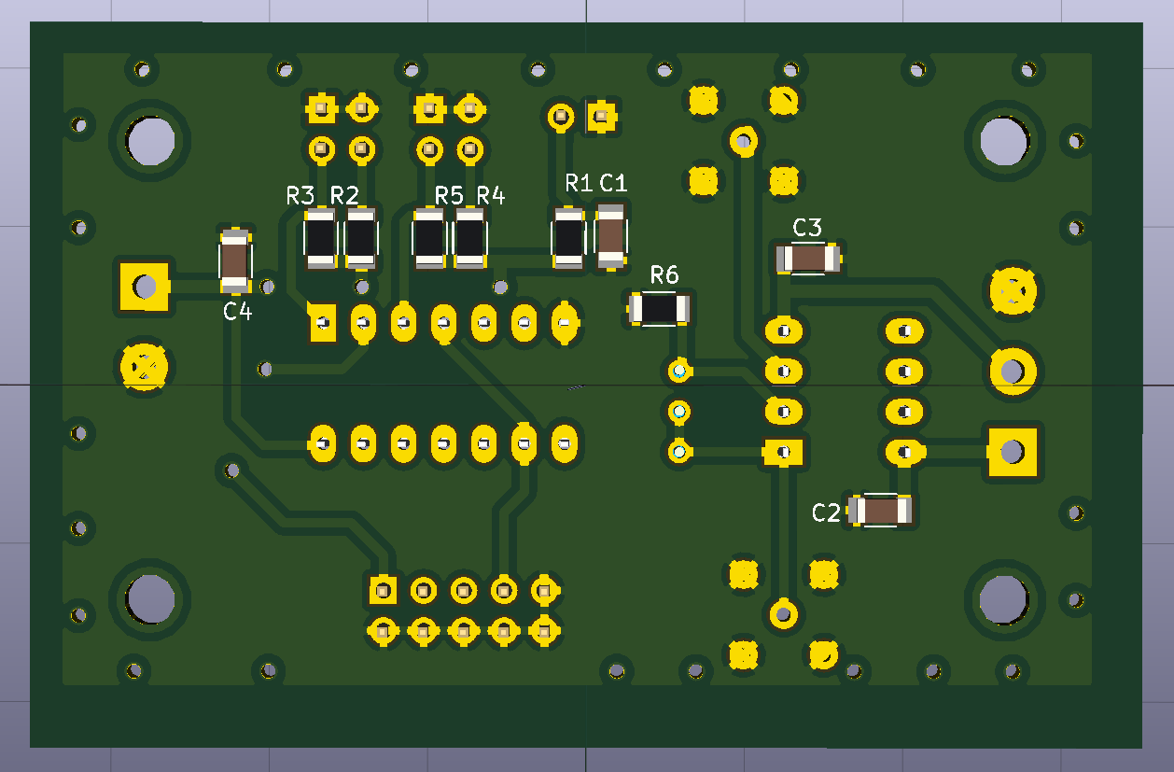
PCB/OPB821S/Docs/OPB&AOP_5.PNG
