Aldarme/PROJECT_CHAMP/ST50_Docs/Doc_Faulhaber/Motion de FAULHABER_1.jpg

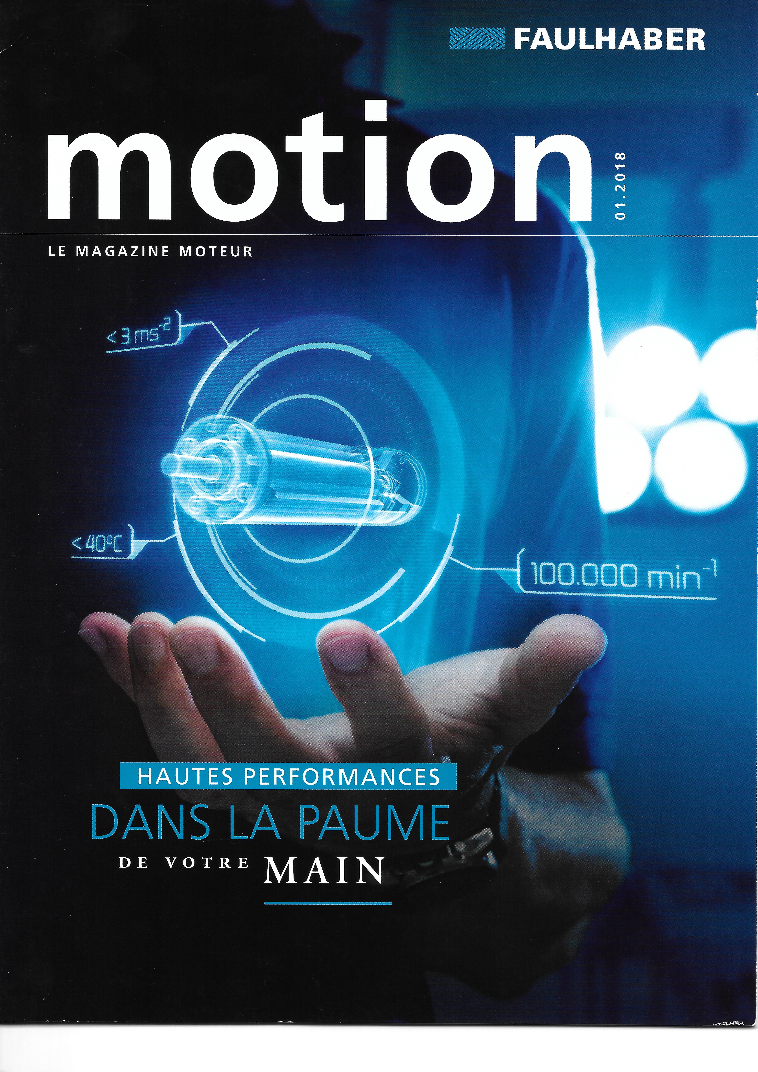
ST50_Docs/Doc_Faulhaber/Motion de FAULHABER_1.jpg
