Aldarme/PROJECT_CHAMP/ST50_Docs/Doc_Faulhaber/Motion de FAULHABER_6.jpg

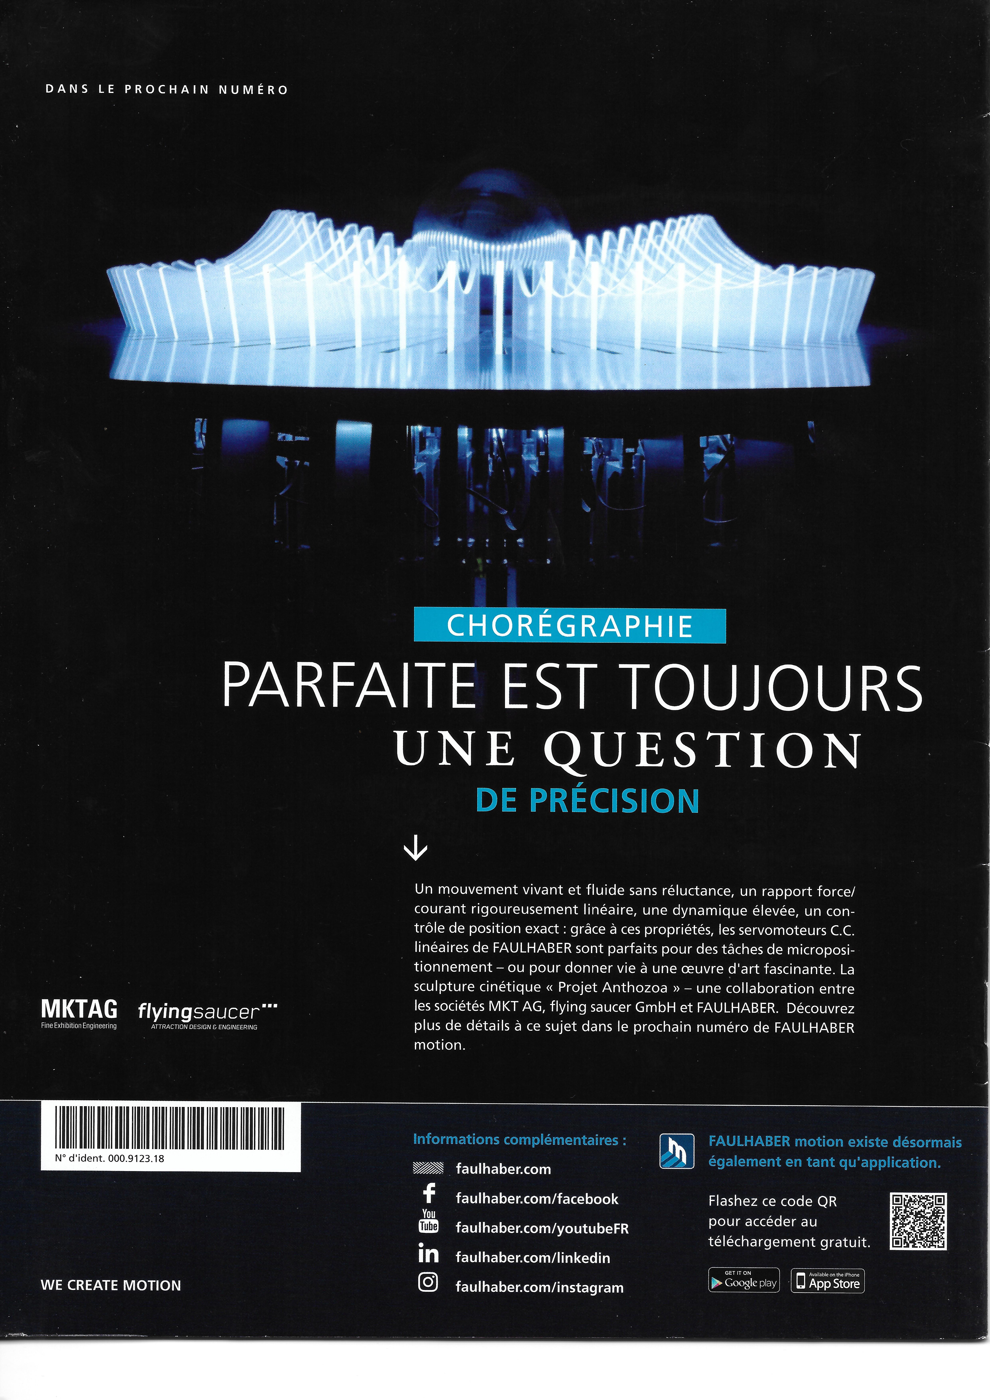
ST50_Docs/Doc_Faulhaber/Motion de FAULHABER_6.jpg
