Aldarme/PROJECT_CHAMP/ST50_Docs/Gimp_Pict/acc.png

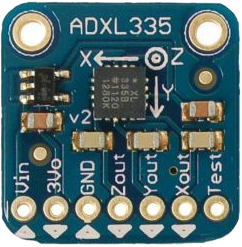
ST50_Docs/Gimp_Pict/acc.png
