Aldarme/PROJECT_CHAMP/ST50_Docs/Gimp_Pict/ecranPc.png

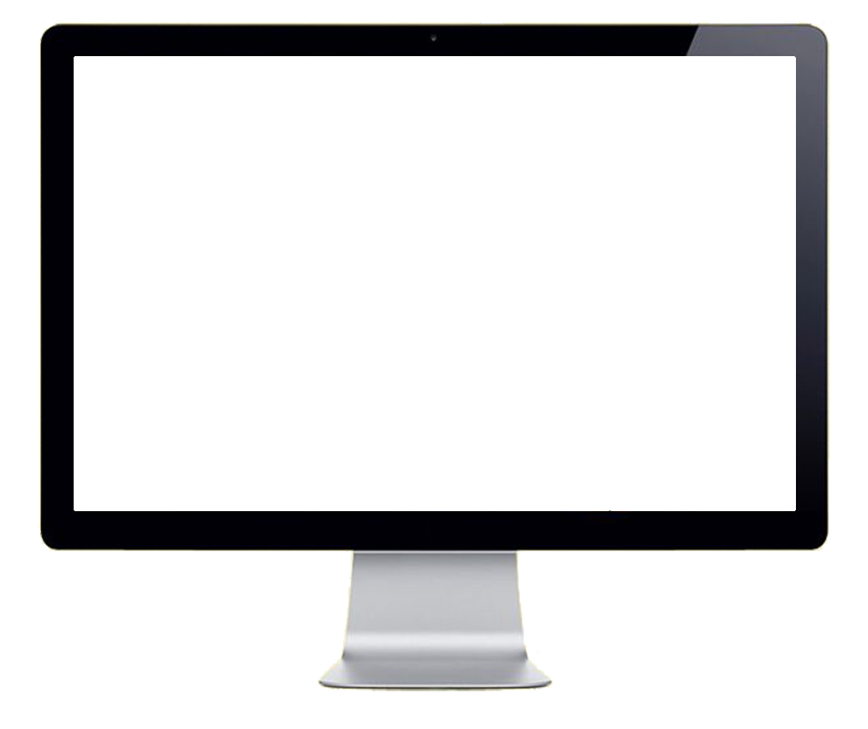
ST50_Docs/Gimp_Pict/ecranPc.png
