Aldarme/PROJECT_CHAMP/ST50_Docs/Gimp_Pict/FPGA.png

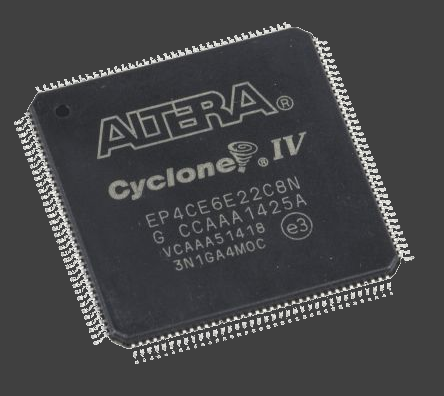
ST50_Docs/Gimp_Pict/FPGA.png
