Aldarme/PROJECT_CHAMP/ST50_Docs/Gimp_Pict/graph1.png

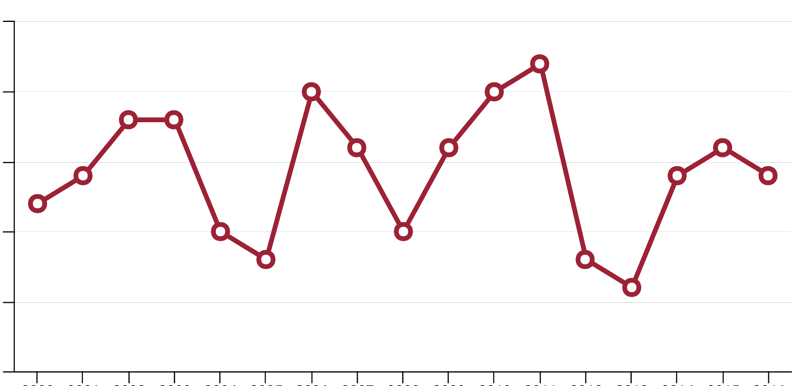
ST50_Docs/Gimp_Pict/graph1.png
