Aldarme/PROJECT_CHAMP/ST50_Docs/Gimp_Pict/graph2.png

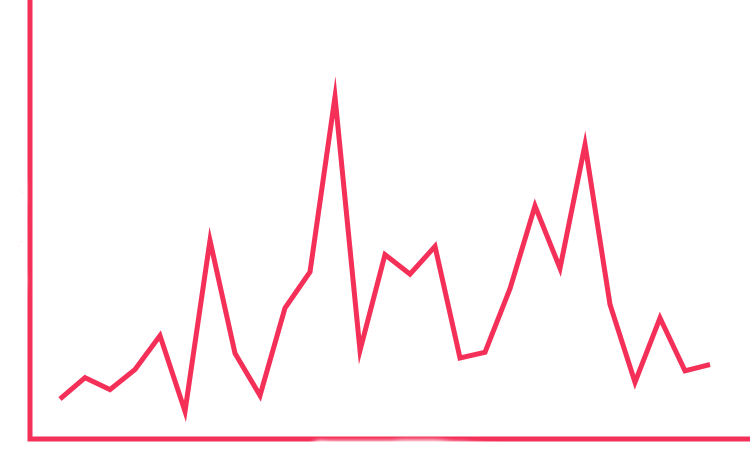
ST50_Docs/Gimp_Pict/graph2.png
