Aldarme/PROJECT_CHAMP/ST50_Docs/Gimp_Pict/MoteurControl.png

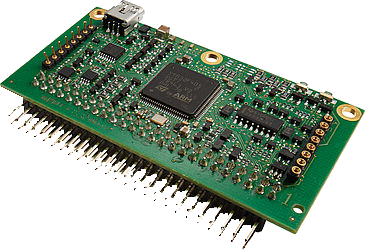
ST50_Docs/Gimp_Pict/MoteurControl.png
