Aldarme/PROJECT_CHAMP/ST50_Docs/Presentation/img/bp2.png

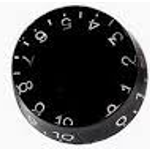
ST50_Docs/Presentation/img/bp2.png
