Aldarme/PROJECT_CHAMP/ST50_Docs/Presentation/img/bp3.png

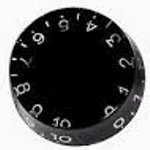
ST50_Docs/Presentation/img/bp3.png
