Aldarme/PROJECT_CHAMP/ST50_Docs/Presentation/img/bpNum.jpeg

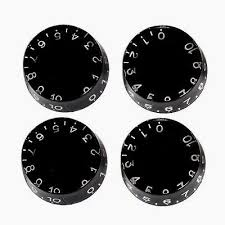
ST50_Docs/Presentation/img/bpNum.jpeg
