Aldarme/PROJECT_CHAMP/ST50_Docs/Presentation/img/CALICE-ILD.png

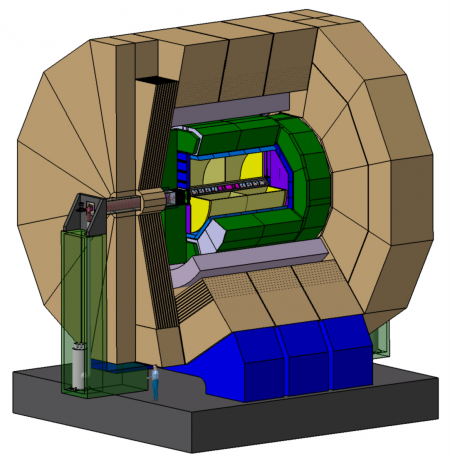
ST50_Docs/Presentation/img/CALICE-ILD.png
