Aldarme/PROJECT_CHAMP/ST50_Docs/Presentation/img/damic.png

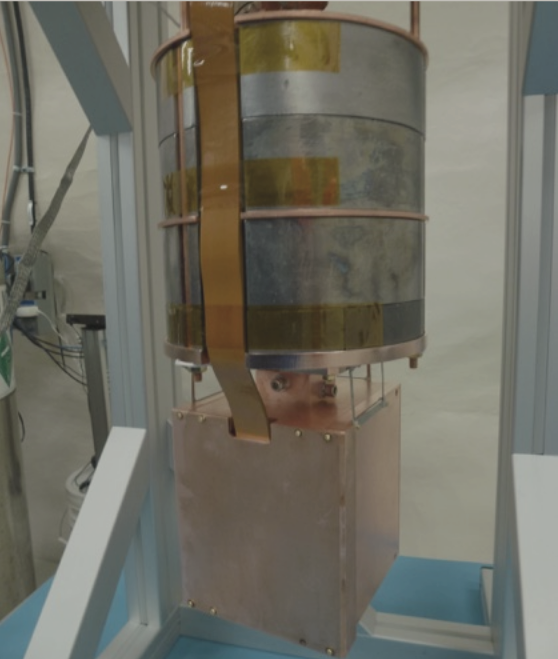
ST50_Docs/Presentation/img/damic.png
