Aldarme/PROJECT_CHAMP/ST50_Docs/Presentation/img/hammer2.png

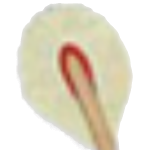
ST50_Docs/Presentation/img/hammer2.png
