Aldarme/PROJECT_CHAMP/ST50_Docs/Presentation/img/hammer.png

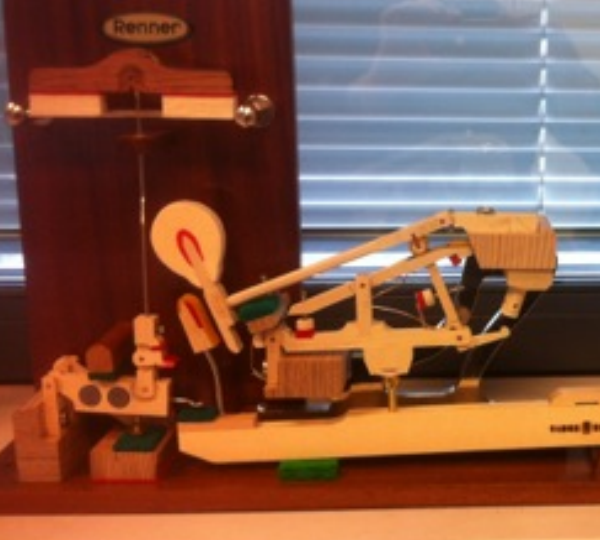
ST50_Docs/Presentation/img/hammer.png
