Aldarme/PROJECT_CHAMP/ST50_Docs/Presentation/img/vhdl.jpg

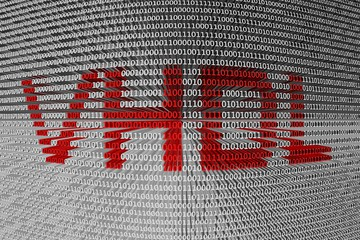
ST50_Docs/Presentation/img/vhdl.jpg
