Aldarme/PROJECT_CHAMP/ST50_Docs/rapport/adxl355_sch.png

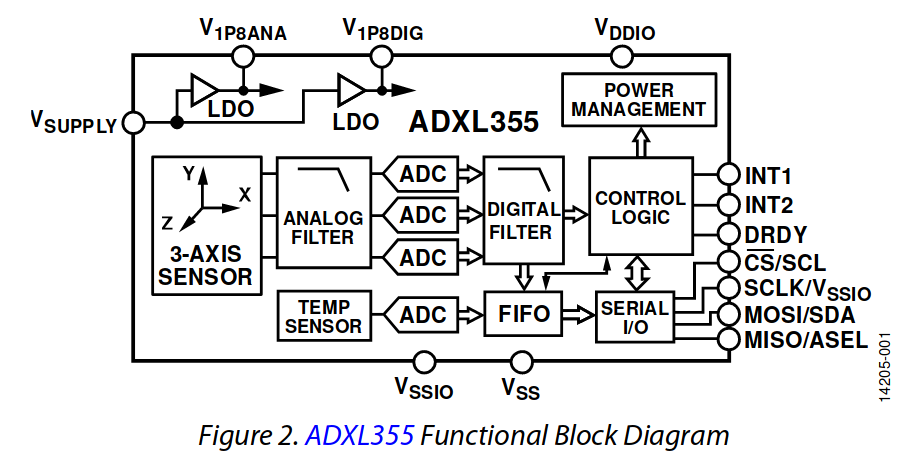
ST50_Docs/rapport/adxl355_sch.png
