Aldarme/PROJECT_CHAMP/ST50_Docs/rapport/Assert_1.png

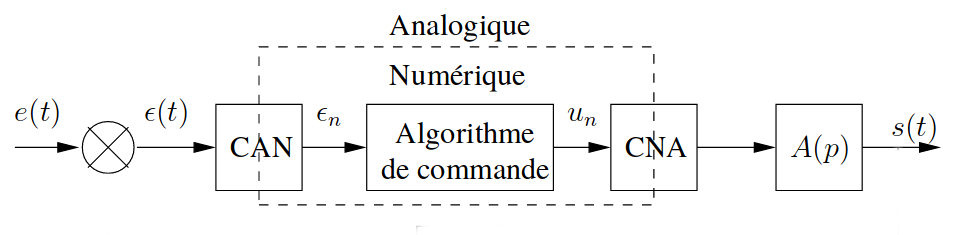
ST50_Docs/rapport/Assert_1.png
