Aldarme/PROJECT_CHAMP/ST50_Docs/rapport/auger.jpg

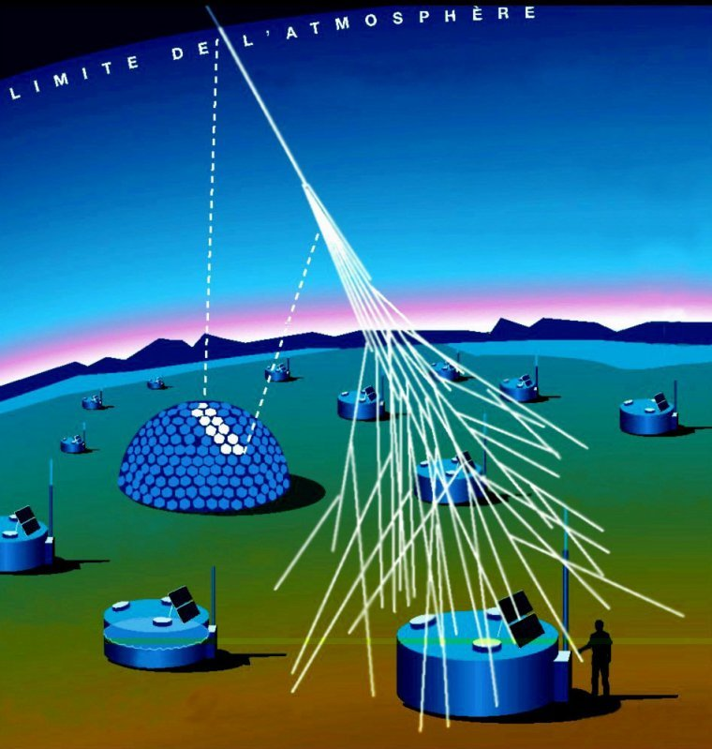
ST50_Docs/rapport/auger.jpg
