Aldarme/PROJECT_CHAMP/ST50_Docs/rapport/DAC.png

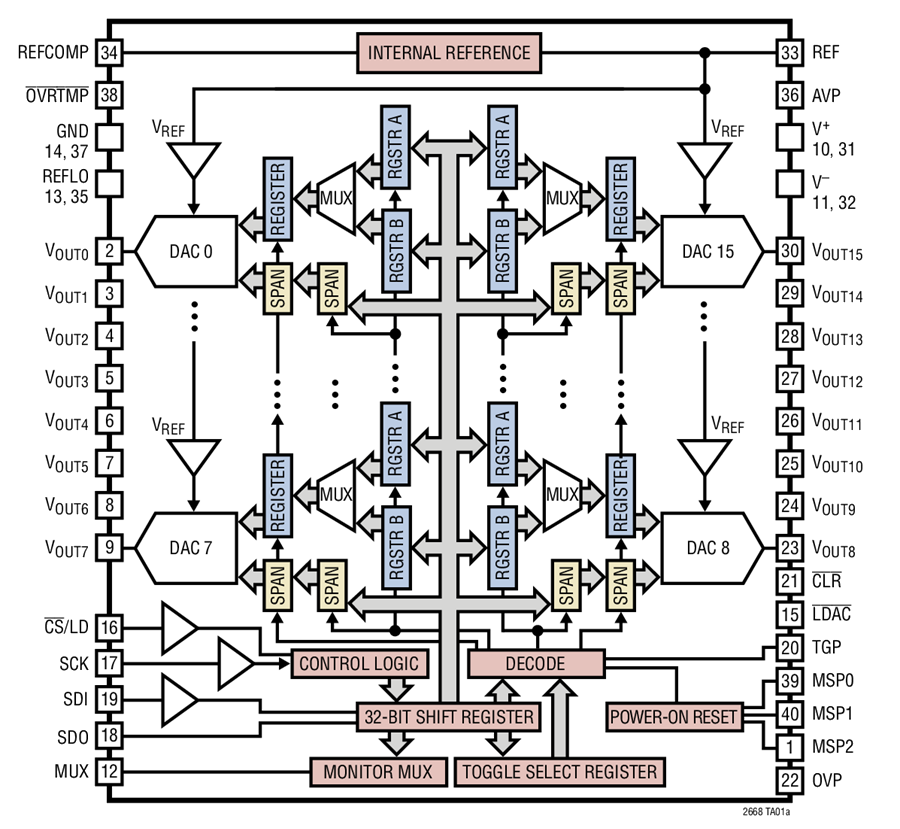
ST50_Docs/rapport/DAC.png
