Aldarme/PROJECT_CHAMP/ST50_Docs/rapport/DE2115.png

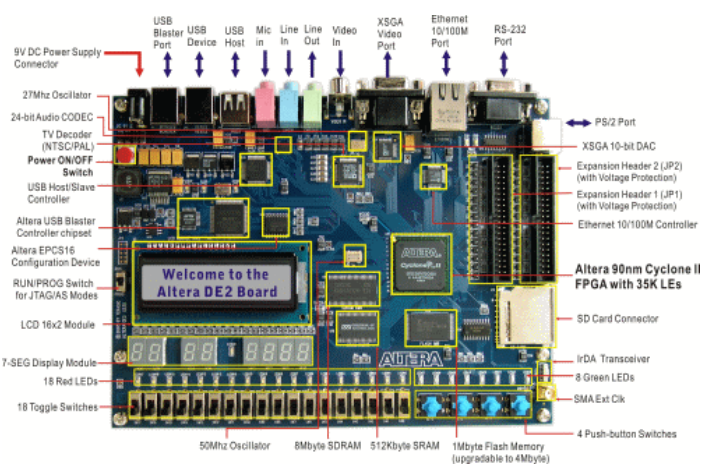
ST50_Docs/rapport/DE2115.png
