Aldarme/PROJECT_CHAMP/ST50_Docs/rapport/hesscta.jpg

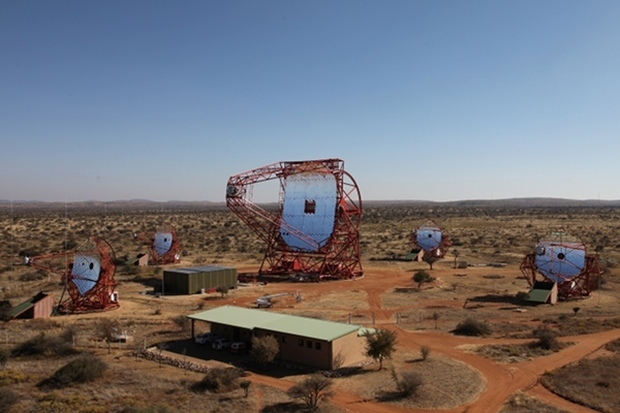
ST50_Docs/rapport/hesscta.jpg
