Aldarme/PROJECT_CHAMP/ST50_Docs/rapport/Motion_FAULHABER_3.jpg

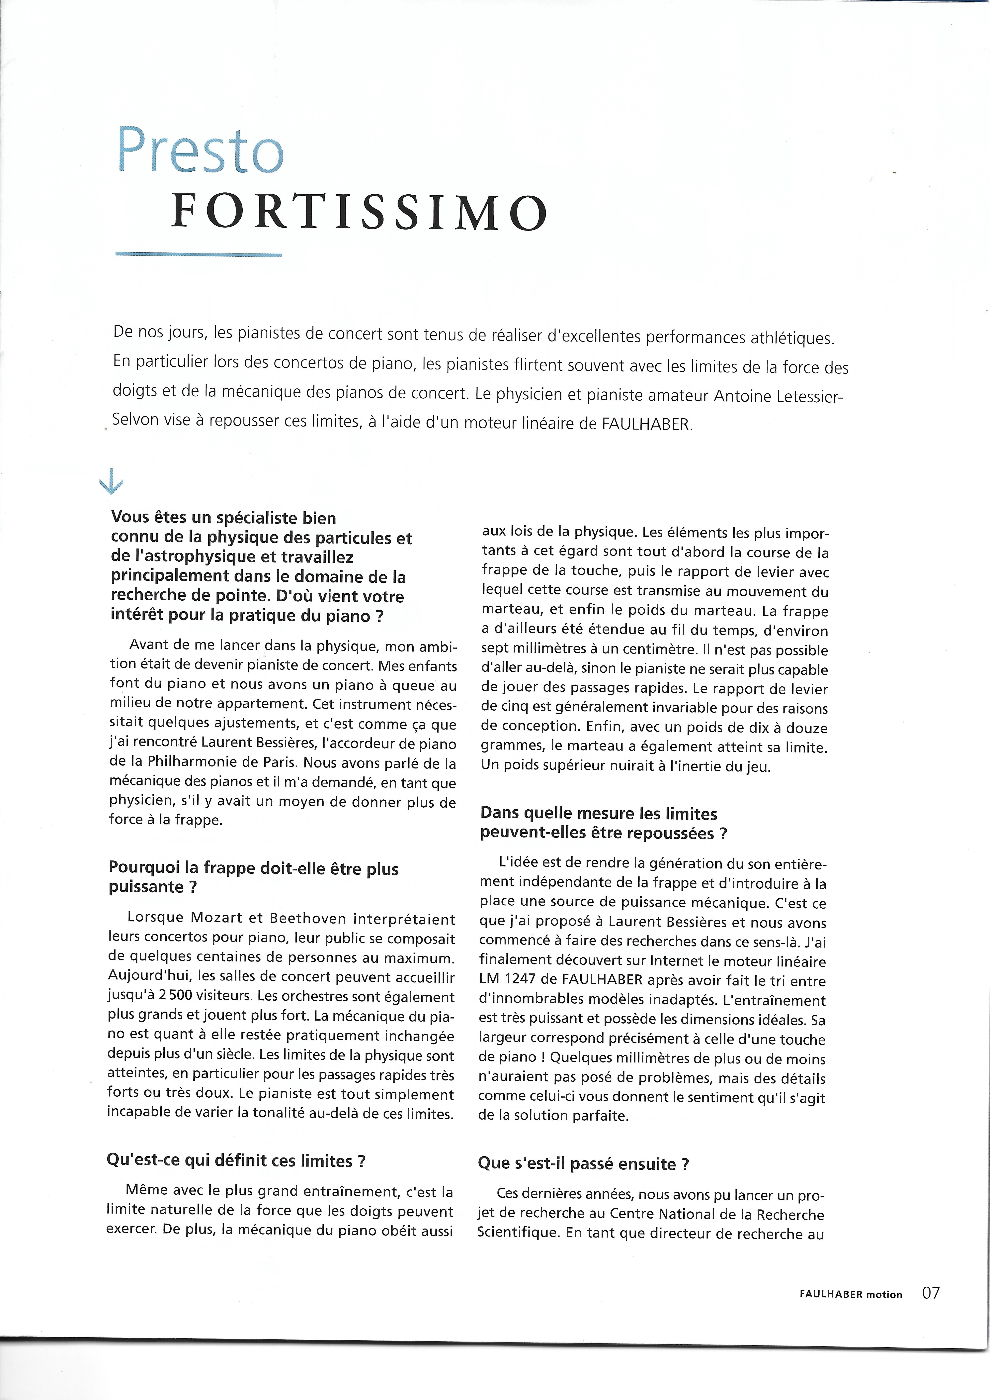
ST50_Docs/rapport/Motion_FAULHABER_3.jpg
