Aldarme/PROJECT_CHAMP/ST50_Docs/rapport/Motion_FAULHABER_4.jpg

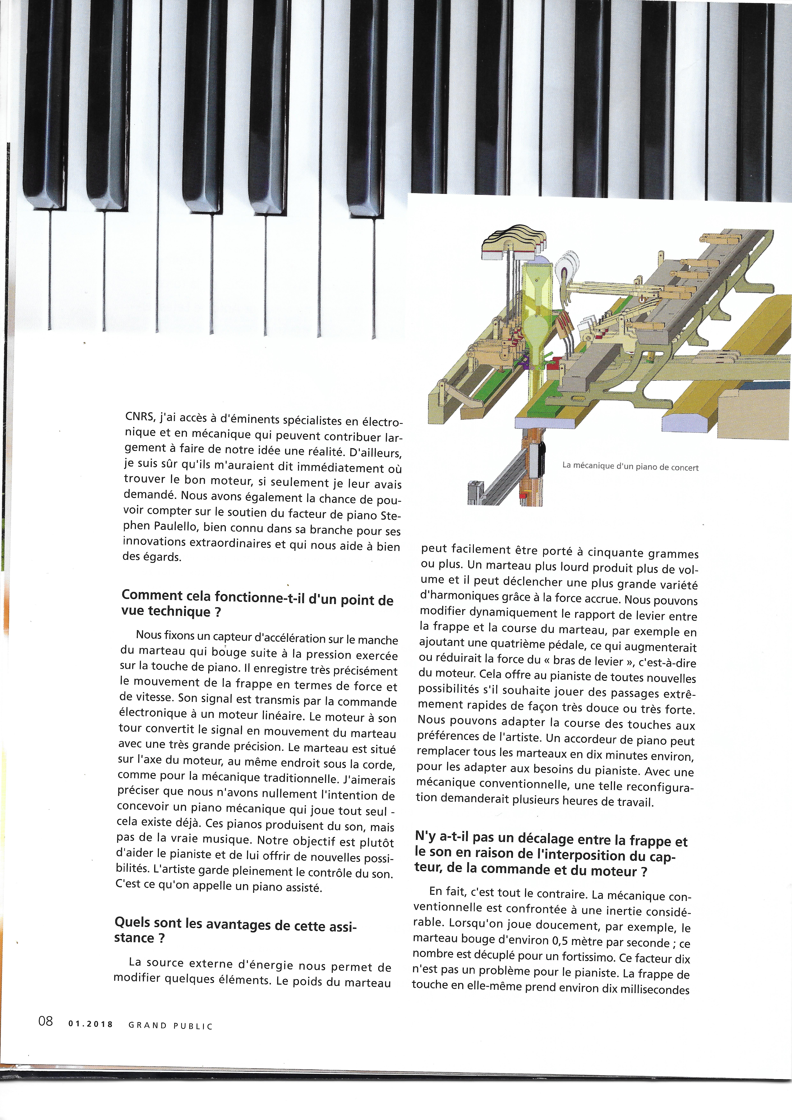
ST50_Docs/rapport/Motion_FAULHABER_4.jpg
