Aldarme/PROJECT_CHAMP/ST50_Docs/rapport/Motion_FAULHABER_5.jpg

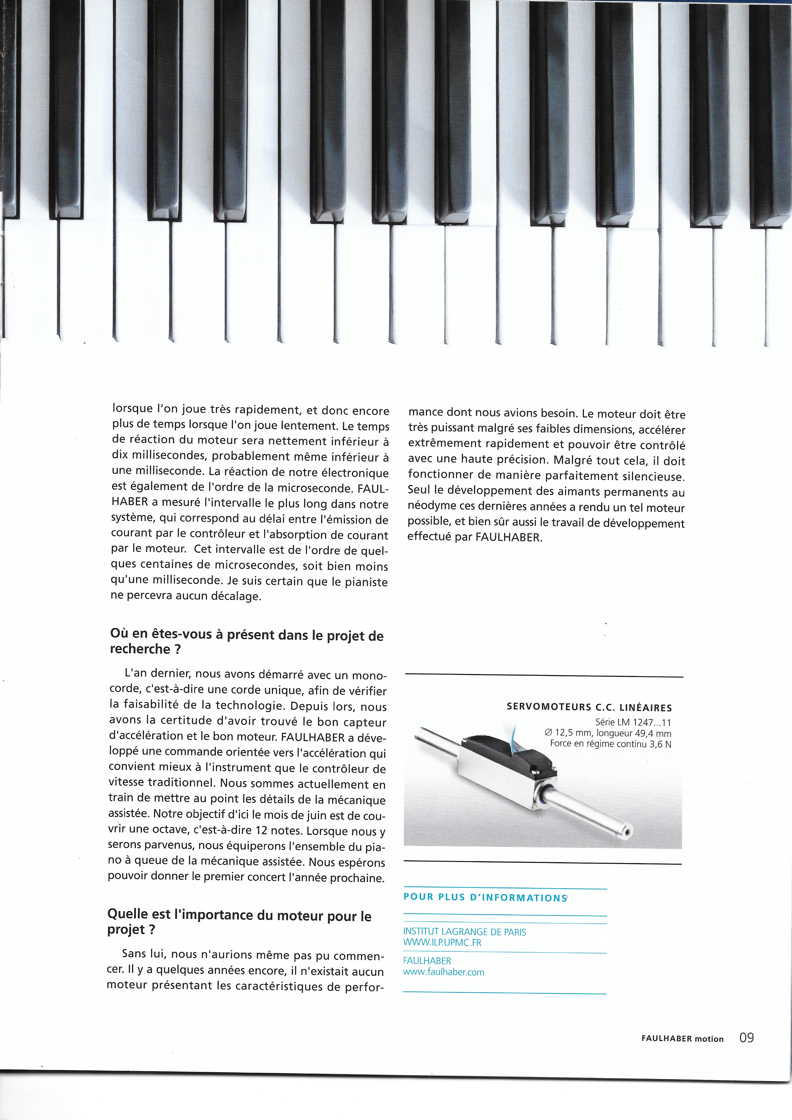
ST50_Docs/rapport/Motion_FAULHABER_5.jpg
