Aldarme/PROJECT_CHAMP/ST50_Docs/rapport/SLACBABAR.png

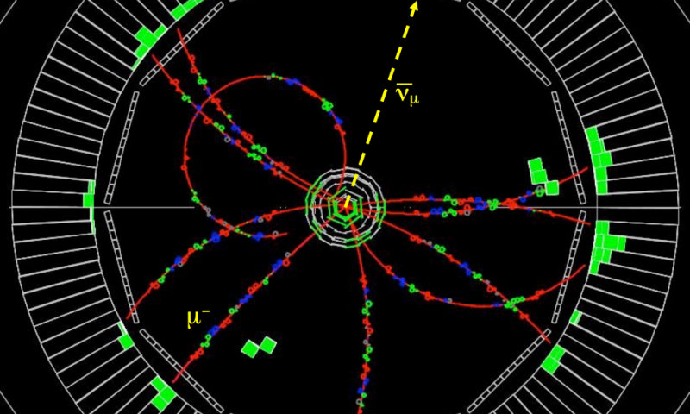
ST50_Docs/rapport/SLACBABAR.png
