Aldarme/PROJECT_CHAMP/ST50_Docs/rapport/SLHC.jpg

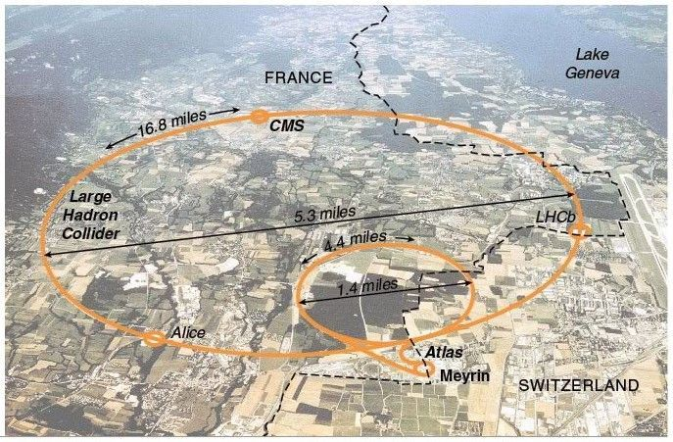
ST50_Docs/rapport/SLHC.jpg
