Aldarme/PROJECT_CHAMP/ST50_Docs/rapport/trplein.png

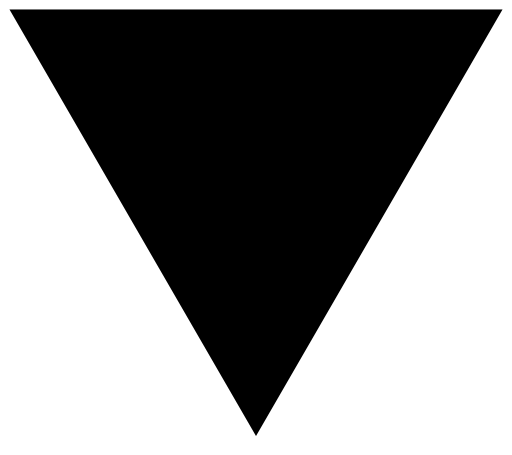
ST50_Docs/rapport/trplein.png
