Aldarme/PROJECT_CHAMP/ST50_Docs/Rapport_Img/355_SPI_CONF_WOUTSTUB.PNG

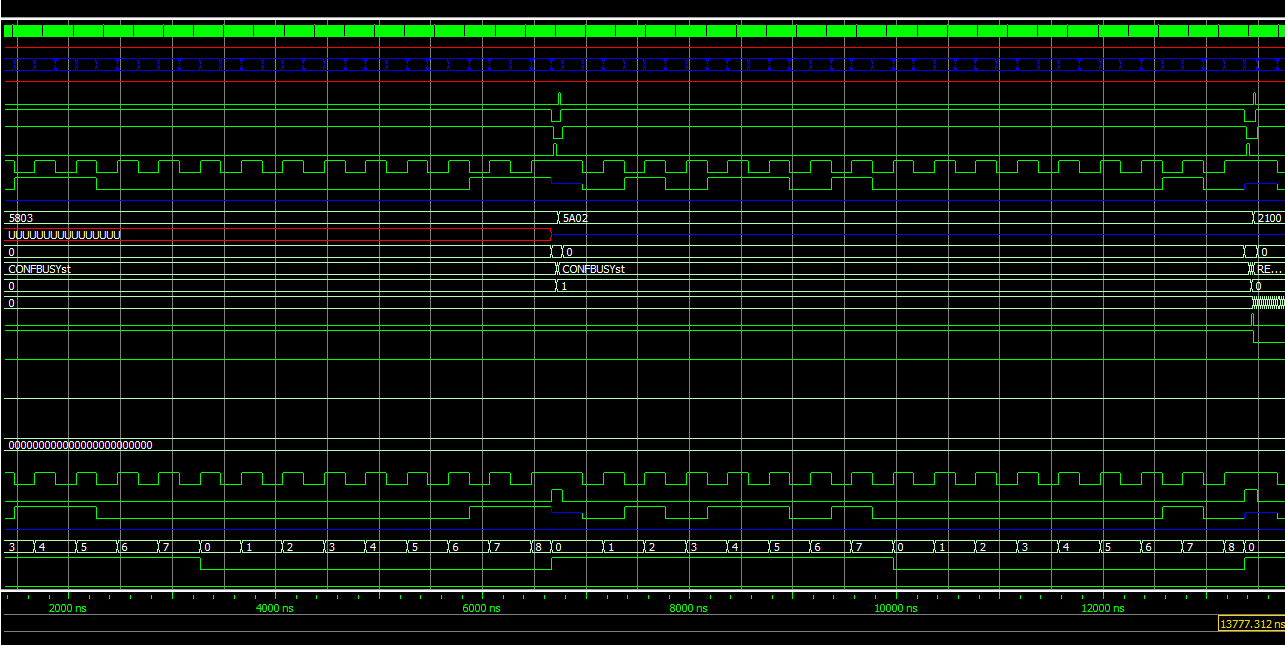
ST50_Docs/Rapport_Img/355_SPI_CONF_WOUTSTUB.PNG
