Aldarme/PROJECT_CHAMP/ST50_Docs/Rapport_Img/355_SPI_DATA_WSTUB.PNG

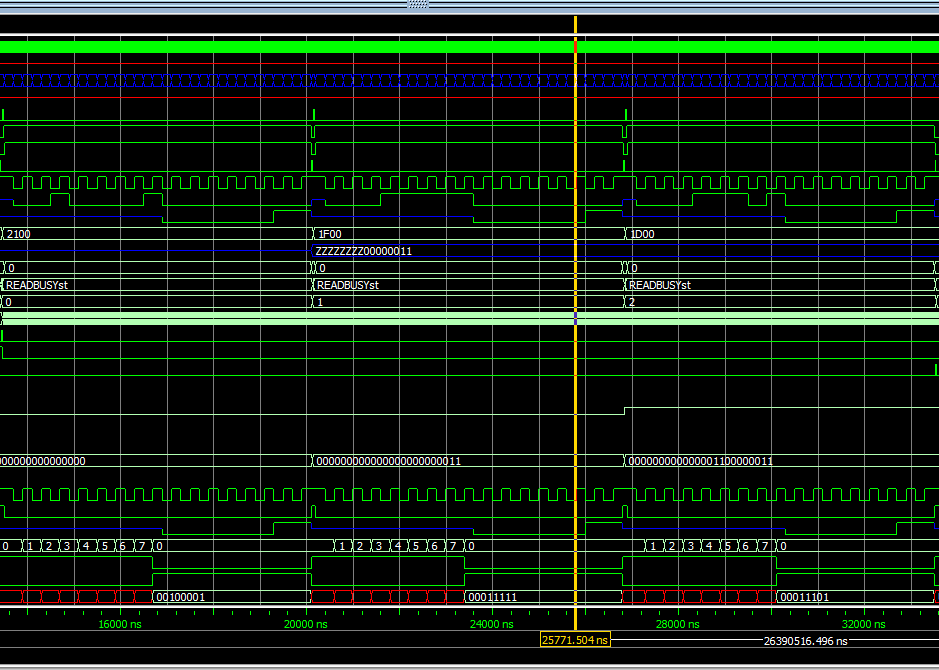
ST50_Docs/Rapport_Img/355_SPI_DATA_WSTUB.PNG
