Aldarme/PROJECT_CHAMP/ST50_Docs/Rapport_Img/Chrono_oscillo/SPI_ACCEL_CONF.bmp

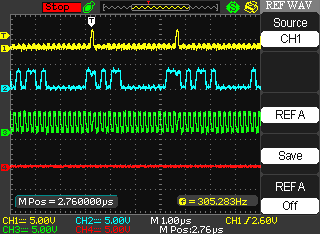
ST50_Docs/Rapport_Img/Chrono_oscillo/SPI_ACCEL_CONF.bmp
