Aldarme/PROJECT_CHAMP/ST50_Docs/Rapport_Img/Chrono_oscillo/SPI_ACCEL_DATA.BMP

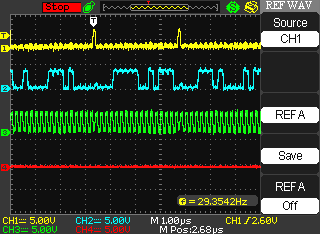
ST50_Docs/Rapport_Img/Chrono_oscillo/SPI_ACCEL_DATA.BMP
