Aldarme/PROJECT_CHAMP/ST50_Docs/Rapport_Img/FPGAtoDac&DAC/DS0001.PNG

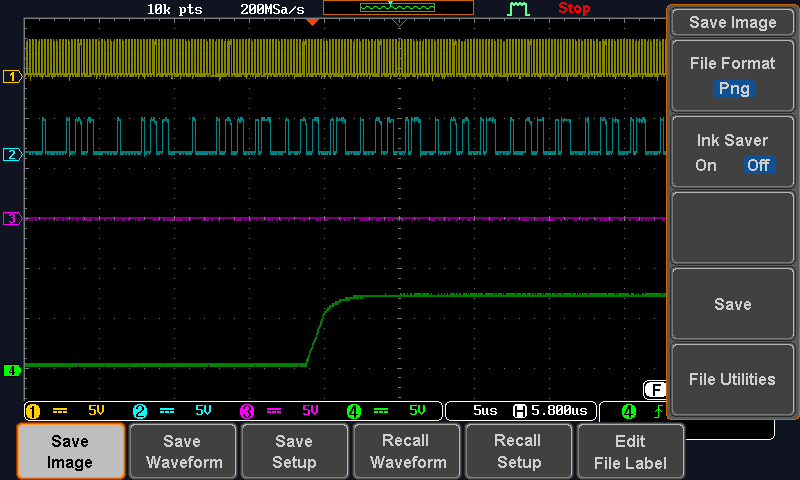
ST50_Docs/Rapport_Img/FPGAtoDac&DAC/DS0001.PNG
