Aldarme/PROJECT_CHAMP/ST50_Docs/Rapport_Img/FPGAtoDac&DAC/DS0003.PNG

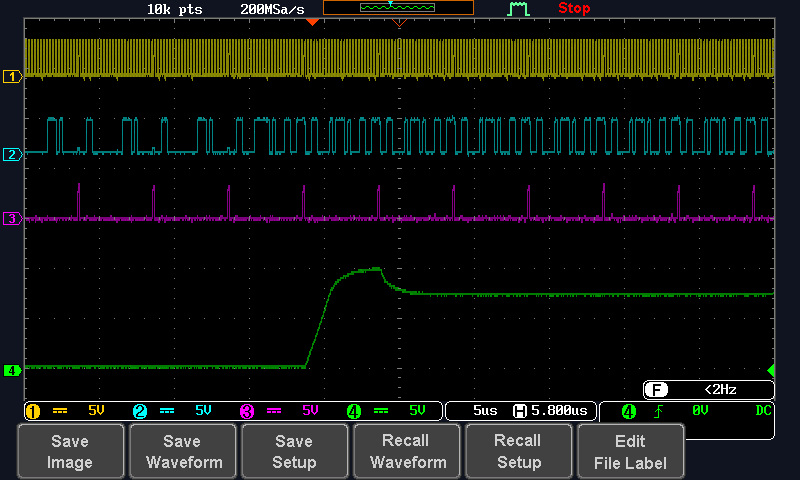
ST50_Docs/Rapport_Img/FPGAtoDac&DAC/DS0003.PNG
