Aldarme/PROJECT_CHAMP/ST50_Docs/Rapport_Img/FPGAtoDac&DAC/DS0004.PNG

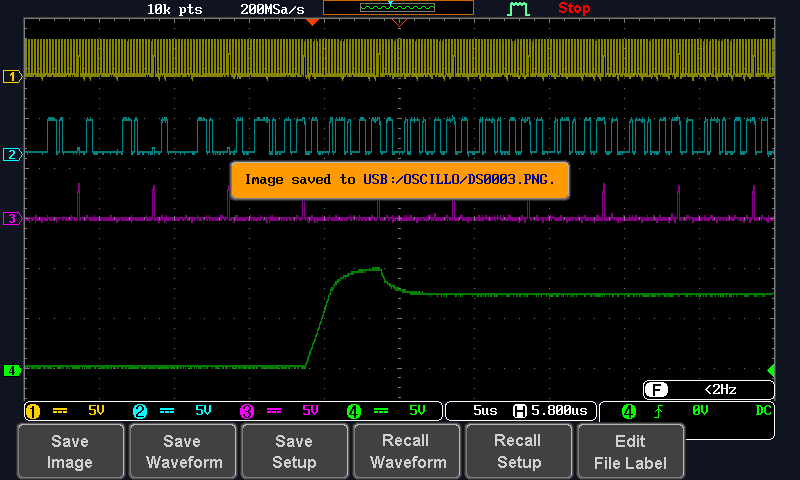
ST50_Docs/Rapport_Img/FPGAtoDac&DAC/DS0004.PNG
