Aldarme/PROJECT_CHAMP/ST50_Docs/Rapport_Img/MODULE_SPI_ACCEL_DATA.PNG

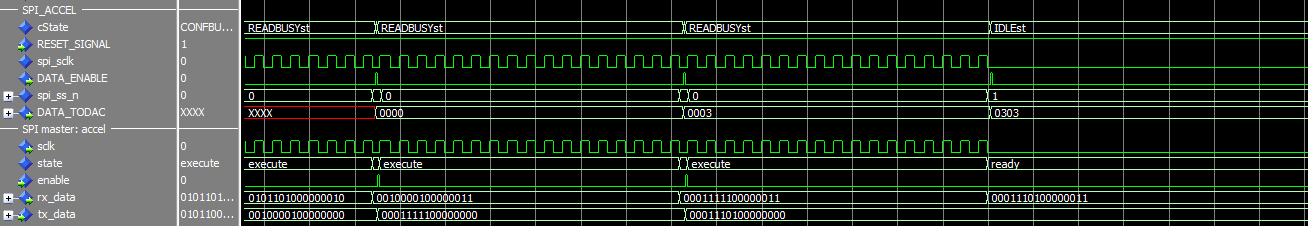
ST50_Docs/Rapport_Img/MODULE_SPI_ACCEL_DATA.PNG
