Aldarme/PROJECT_CHAMP/ST50_Docs/Rapport_Img/MODULE_SPI_DAC_CONFIG.PNG

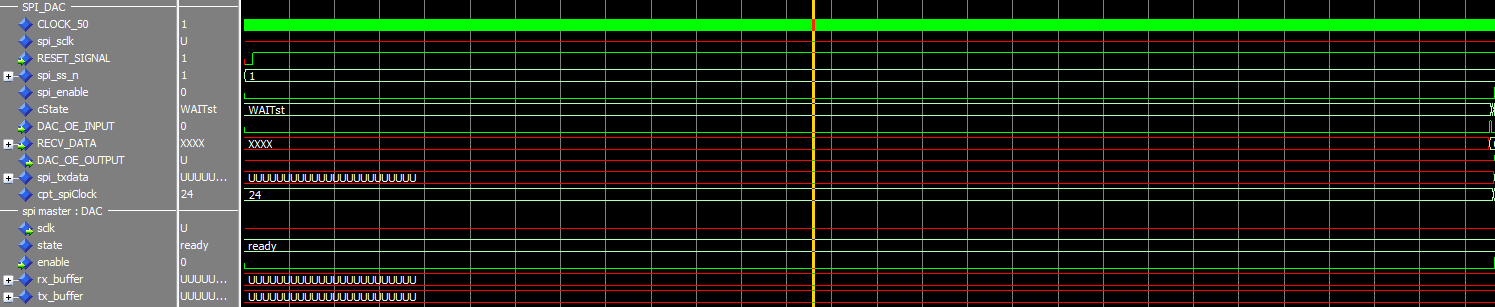
ST50_Docs/Rapport_Img/MODULE_SPI_DAC_CONFIG.PNG
