Aldarme/PROJECT_CHAMP/ST50_Docs/Rapport_Img/singal_Bruité/DS0002.PNG

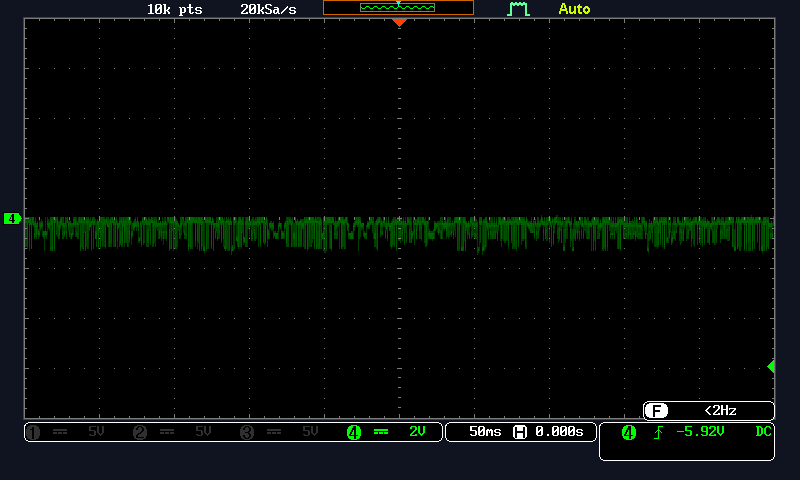
ST50_Docs/Rapport_Img/singal_Bruité/DS0002.PNG
