Aldarme/PROJECT_CHAMP/ST50_Docs/Rapport_Img/singal_Bruité/DS0003.PNG

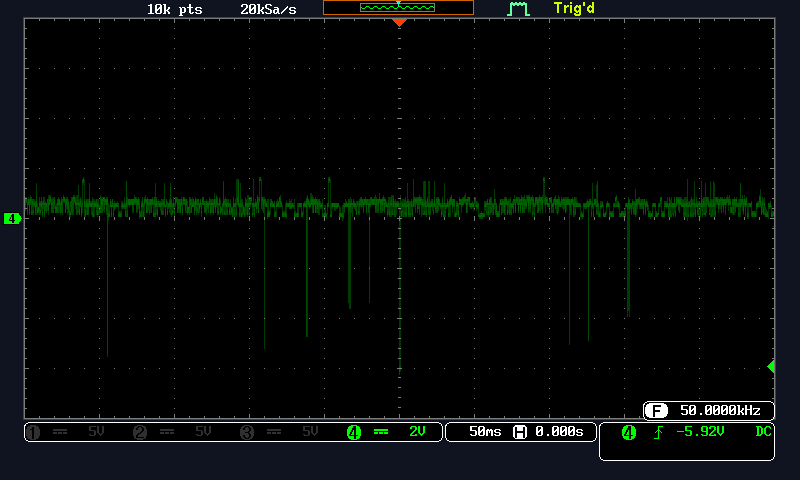
ST50_Docs/Rapport_Img/singal_Bruité/DS0003.PNG
