Aldarme/PROJECT_CHAMP/ST50_Docs/Rapport_Img/SPI_SIM_GLOB.png

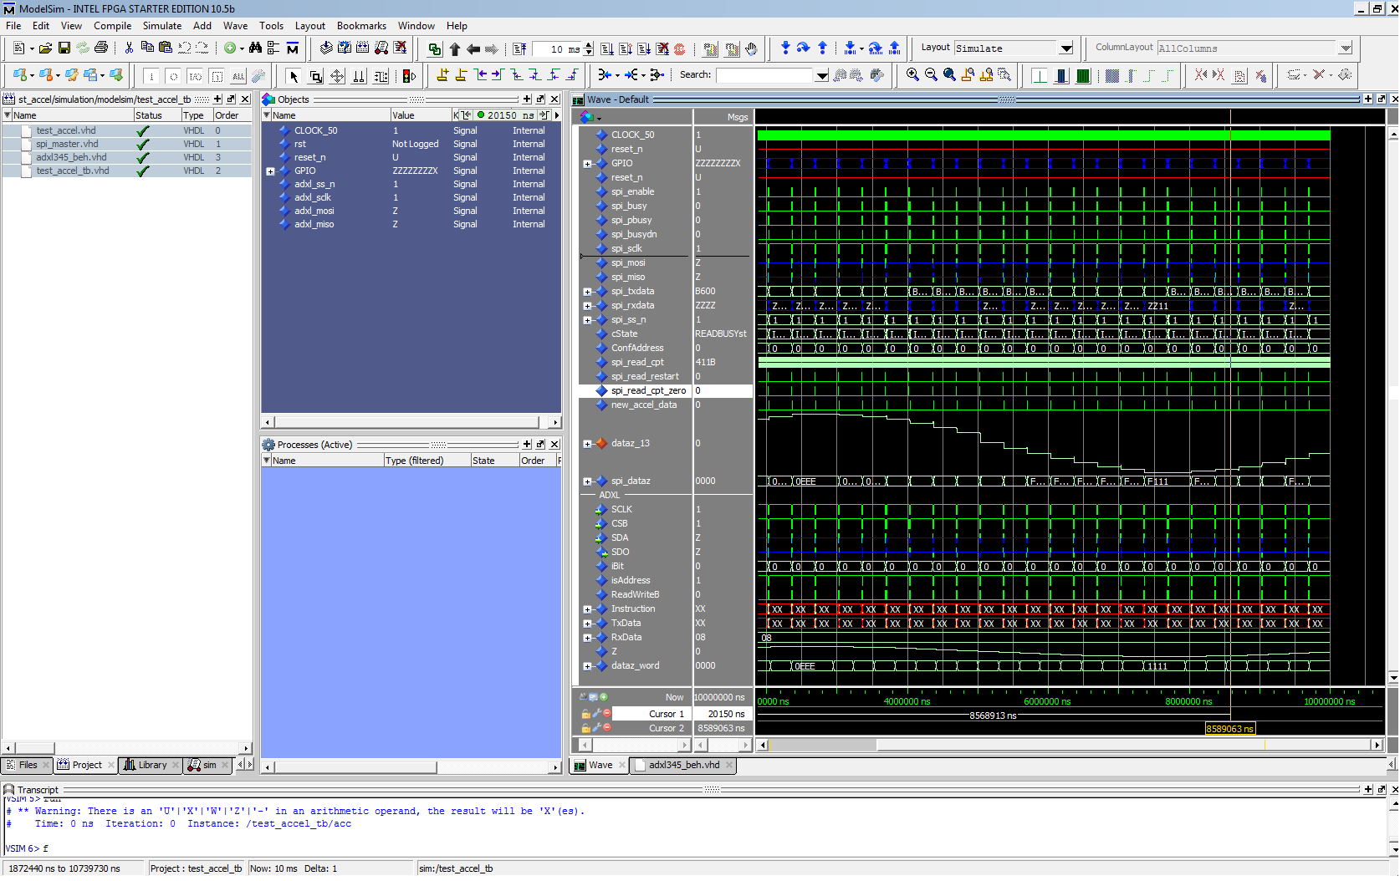
ST50_Docs/Rapport_Img/SPI_SIM_GLOB.png
