Aldarme/PROJECT_CHAMP/ST50_Docs/Rapport_Img/SPI_SIM_READ_SLAVE.PNG

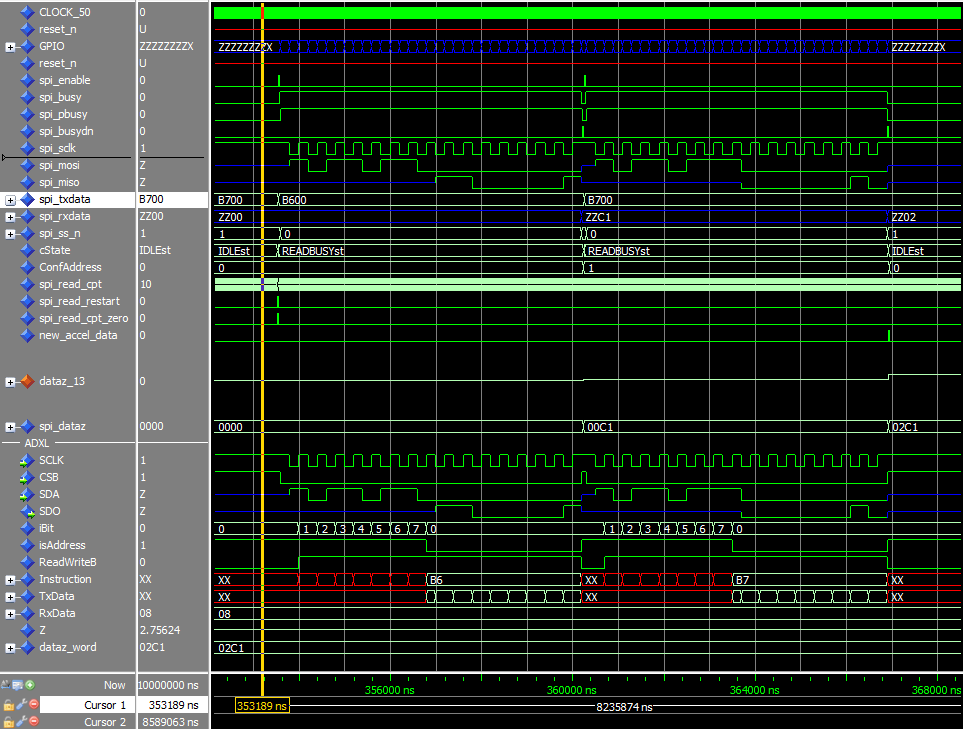
ST50_Docs/Rapport_Img/SPI_SIM_READ_SLAVE.PNG
