Aldarme/PROJECT_CHAMP/ST50_Docs/Rapport_Img/SPI_SIM_TRAME_GLOB.PNG

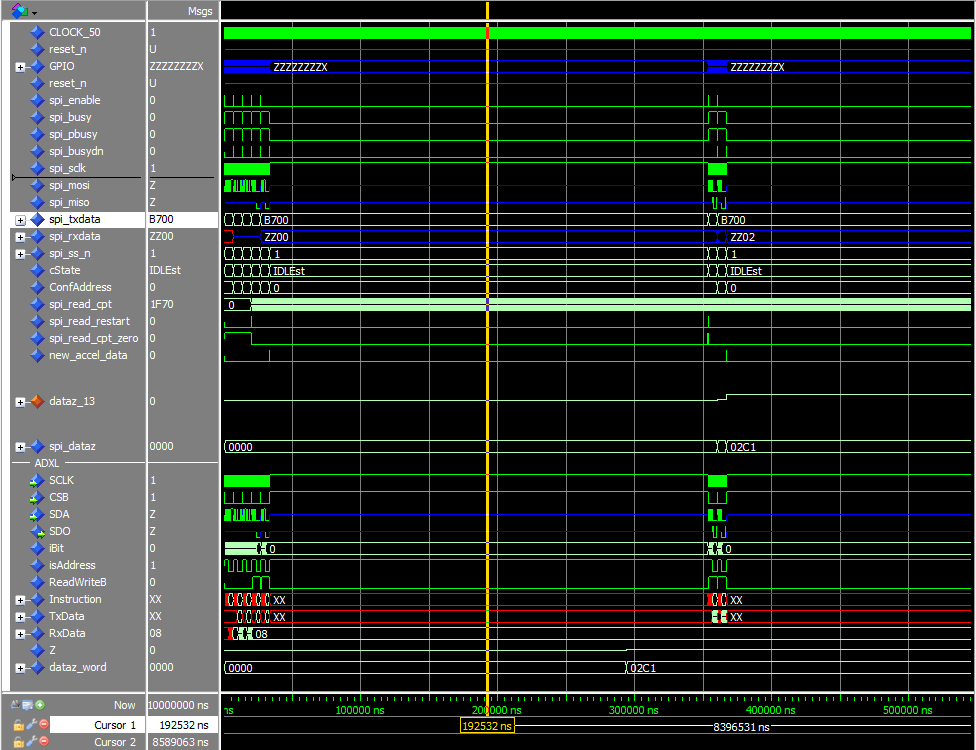
ST50_Docs/Rapport_Img/SPI_SIM_TRAME_GLOB.PNG
