Aldarme/PROJECT_CHAMP/ST50_Docs/Rapport_Img/Support_accelerometre/Accelerometre_v1.JPG

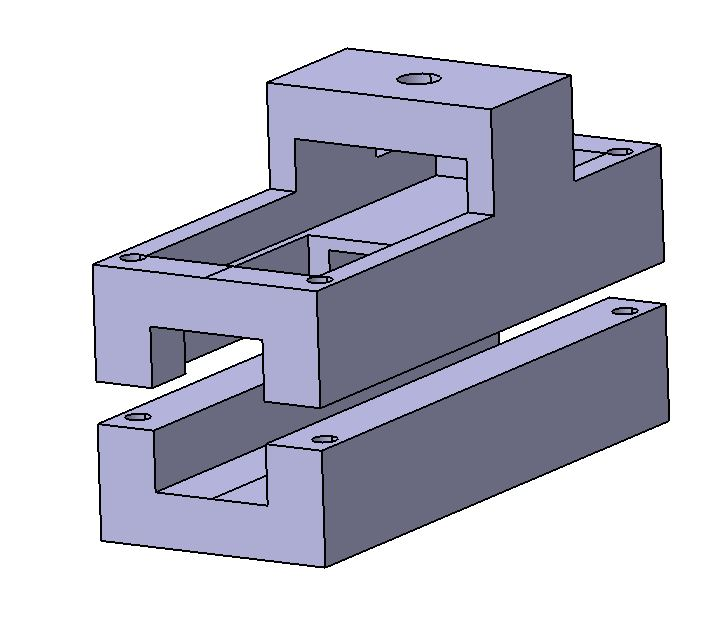
ST50_Docs/Rapport_Img/Support_accelerometre/Accelerometre_v1.JPG
