Aldarme/PROJECT_CHAMP/ST50_Docs/Rapport_Img/Support_accelerometre/Accelerometre_v2_champFrein.JPG

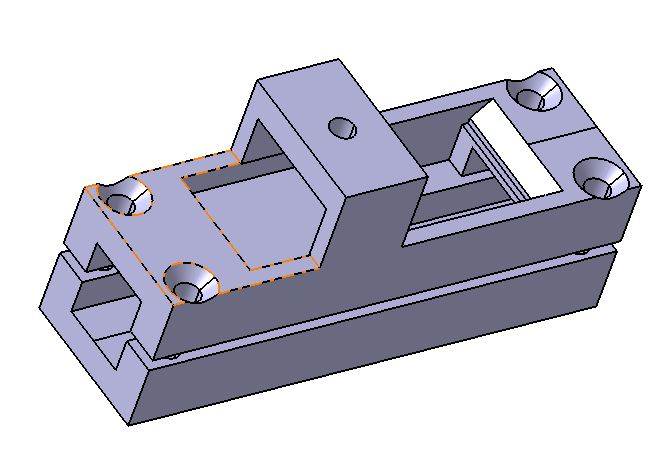
ST50_Docs/Rapport_Img/Support_accelerometre/Accelerometre_v2_champFrein.JPG
