Aldarme/PROJECT_CHAMP/PCB/DOC_LABO/COMMANDE__EVALBOARD&POCHOIR_ACC_KX224.xlsx

L.P.N.H.E. |  | Laboratoire de Physique Nucléaire et de Hautes Énergies
 |  | I.N2 P3 - CNRS UNIVERSITÉS PARIS VI ET VII
partie réservée à l’administration
Commande n° |  |  | Crédit |  |  |  |  |  | Observation
 | Date : |  | Entité dépensière |  |  |  |  |  |  |  |  | Matiere | Old Matiere
 | 2018-10-29 |  | (cocher la case concernée) |  |  |  |  |  |  |  |  | E6.12 | 5501 | Composants Electroniques
 | CHAMP |  | Code matière | o |  |  |  |  |  |  |  | A0.01 | 3301 | Materiel electrique, resistances, piles, accumulateurs, ...
 |  |  |  | o |  |  |  |  |  |  |  | E6.31 | 9206 | Fabrication Cartes, cablage, assemblage et test, ...
 |  |  |  | o |  |  |  |  |  |  |  | E6.02 | 5708 | Cartes acquisition specifiques, chassis specifiques
 | Nom du demandeur |  |  | o |  |  |  |  |  |  |  | E6.01 | 5622 | Generateurs, oscilloscopes, analyseurs, cartes VME, VXI,..., chassis, ...
 | ROMET PIERRE |  |  |  |  |  |  |  |  |  |  | E6.21 | 8125 | Maintenance des equipements de laboratoires
 |  |  |  |  |  |  |  |  |  |  |  | F0.07 | 95xx | Maintenance informatique
 |  |  |  |  |  |  |  |  |  |  |  | E6.11 |  | Materiel pour fab CI, fabrication CI multicouches, fer a souder, machines percage
Nom du fournisseur |  | PCB POOL |  |  |  |  |  |  |  |  |  | F0.01 |  | Composants, peripheriques et accessoires pour ordinateurs
Adresse |  | Beta LAYOUT GmbHIm Aartal 14 65326 Aarbergen Deutschland |  |  |  |  |  |  |  |  |  | F0.51 |  | Cartes reseaux, HUB, cordons, autres equipements reseau
 |  |  |  |  |  |  |  |  |  |  |  | E7.01 |  | Materiaux pour la recherche, epoxy, PTFE, ...
 |  |  |  |  |  |  |  |  |  |  |  | E5.12 |  | Maintenance, reparation des appareils d'optique
n° siret (obligatoire) |  |  |  |  |  | Tél. 00 353 (0)61 701170 |  |  | Fax 00 353 (0)61 701165 |  |  | F0.57 |  | Maintenance reseaux informatiques
Quantité | Désignation |  |  |  | Référence |  | Prix unitaire H.T. en € | Prix Total H.T. en € |  | Remise (taux ) | NACRES
2 | PCBs en 6 jours ouvrables |  |  |  |  |  | 29.17 € | 58.34 €
1 | Frais de port |  |  |  |  |  | 16.55 € | 16.55 €
TOTAL |  |  |  |  |  |  |  | 74.89 €
 |  |  |  |  |  |  |  |  |  |  |  |  |  | 3740647
 | Selon devis 251018RK04
 |  |  |  |  | Total H.T. |  | #VALUE!
visa Directeur ou Administrateur |  |  |  |  | visa du Responsable
