Aldarme/PROJECT_CHAMP/PCB/DOC_LABO/FICHE_LIAISON_SCHEMA_PCB_NEWS.xls

Date : |  | 2018-05-24 |  | FICHE DE LIAISON SCHEMA-PCB
INFORMATIONS GÉNÉRALES
Concepteur : |  | Pierre ROMET |  | Nom de la carte : |  | Mezzanine_monoAcc |  |  |  | Version KICAD |  |  | 4.0.7
Quantité ? |  | 1 |  | Expérience : |  | CHAMP |  | Délais en jours : |  | jours |  | Placeur routeur : |  | Pierre ROMET
Répertoire de la carte :
Le schéma a t il été packagé ? |  |  |  |  | Oui | x | Non
Quel est le rôle de la carte? |  |  |  |  | Carte de connexion au FPGA pour accéléromètres et DAC
Un placement routage doit il être récupéré ? |  |  |  |  | Oui |  | Non | x | Précision :
DIMENSIONS
Quelles sont les dimensions de la carte ? |  |  |  |  | Standard : |  | x | Précision (VME, PXI) :
 |  |  |  |  | Imposées : |  |  | Précision (en mm) :
 |  |  |  |  | Libres : |  | Oui |  | Non
Y a t il une épaisseur maximum ? |  |  |  |  | Oui |  | Non | x
MÉCANIQUE
Y a t il des trous de fixations ? |  |  |  |  | Oui | x | Non |  | Précision :
Y a t il des connecteurs de liaisons ? |  |  |  |  | Oui | x | Non |  | Précision :
Y a t il une face avant ? |  |  |  |  | Oui |  | Non | x | Précision :
Si oui, avez vous un plan coté ? |  |  |  |  | Oui |  | Non | x | Dimensions
EMPILEMENT
Quelles sont les différentes alimentations?
Combien y a t il de couche ? |  |  |  |  | 2 | x | 4 |  | 6 |  | 8 |  | 10
 |  |  |  |  | 12 |  | 14 |  | + de 14
Fabrication de la carte en interne ? |  |  |  |  | Oui | x | Non
Définition de l'empilement ? |  |  |  |  | TOP |  |  |  | IN1 |  |  |  | IN2
 | IN3 |  |  |  | IN4 |  |  |  | IN5 |  |  |  | IN6
 | IN7 |  |  |  | IN8 |  |  |  | IN9 |  |  |  | IN10
 | IN11 |  |  |  | IN12 |  |  |  | BOTTOM
TECHNOLOGIE
Utilisation de la technologie Pad on Hole ou Via in Pad |  |  |  |  |  | Oui |  | Non | x
Y a t il des impédance contrôlées sur un plan ? |  |  |  |  |  | Oui |  | Non | x | Sur quelles couches ?
Y a t il des impédances contrôlées entre des plans ? |  |  |  |  |  | Oui |  | Non | x | Entre quelles couches?
Si oui quels sont les signaux concernés ?
Avez vous calculé la taille du fil ? |  |  |  |  |  | Oui |  | Non | x | Quelle taille en mm ?
Quel est l'épaisseur du diélectrique ? |  |  |  |  |  |  | Quelle est la valeur du diélectrique ?
SIGNAUX SENSIBLES
Y a t il des paires différentielles ? |  |  |  |  |  | Oui |  | Non | x
Si oui quels sont leurs noms ?
Y a t il une ou des couches dédiées? |  |  |  |  |  | Oui |  | Non | x | Lesquelles ?
Y a t il des bus ? |  |  |  |  |  | Oui | x | Non |  | Lesquels ? |  | SPI
Y a t il une ou des couches dédiées? |  |  |  |  |  | Oui |  | Non | x | Lesquelles ?
Y a t il d'autres signaux sensibles ? |  |  |  |  |  | Oui | x | Non |  | Lesquels ? |  | SPI
Y a t il une ou des couches dédiées? |  |  |  |  |  | Oui |  | Non | x | Lesquelles ?
COMPOSANTS SENSIBLES
Y a t il des composants sensibles ? |  |  |  |  |  | Oui | x | Non |  | Lesquels ? |  | ADXL355
Y a t il des composants avec Pad Thermique ? |  |  |  |  |  | Oui |  | Non | x | Lesquels ?
Y a t il des BGAs ? |  |  |  |  |  | Oui |  | Non | x | Lesquels ?
Y a t il des nouveaux composants? |  |  |  |  |  | Oui |  | Non | x | Lesquels ?
CÂBLAGE
Câblage de la carte en interne ? |  |  |  |  |  | Oui | x | Non |  | Par quelle société ?
DEVIS
Wurth Elektronik |  | Oui |  | Non | x | CIRE SPCI |  | Oui |  | Non | x | CSI | Oui |  | Non | x
CIRLY |  | Oui |  | Non | x | TECH-CI |  | Oui |  | Non | x | Cirex | Oui |  | Non | x
PCB Electronic |  | Oui |  | Non | x | CIBEL |  | Oui |  | Non | x | CIBEL | Oui |  | Non | x
INTERNE |  | Oui | x | Non |  |  |  | Oui |  | Non |  |  |  |  | 2018-05-24
