Aldarme/PROJECT_CHAMP/ST50_Docs/rapport/M_FICHE_FABRICATION_MEZZA.pdf

Feuille1

tel : | Fax :
Email :
L.P.N.H.E | Laboratoire de Physique Nucléaire et de Hautes Energies
I.N.2.P.3 – CNRS – Université Paris VI et VII 4 place Jussieu 75005
Pierre Promet | 01 44 27 72 57 | 01 44 27 46 38
Pôle CAO-Câblage | romet@lpnhe.in2p3.fr
24/05/18 | 24/05/18
Nom de la carte : | Mezzanine_monoAcc
Expérience : | CHAMP
Dimensions : | 70 x 110 mm
Classe : | 4
Nombre de couche : | 2
Pad on Hole ( ou Via in Pad ) : | NON
Trous borgnes : | NON
COUCHE DE ROUTAGE | CI.FAB Fichiers .art | DÉSIGNATION
Couche 1 | TOP | Fils + Plan GND
Couche 2 | BOTTOM | Fils + Plan GND
| DRILL | Plan de Perçage
| DIM | Dimensions
FACE | CABLAGE Fichiers .pdf | DÉSIGNATION
TOP | PLAN_CABLAGE_TOP_EL EMENTS_MEZZA.pdf | Carte équipée avec Repères Topos et Valeurs Coté Éléments
BOTTOM | PLAN_CABLAGE_BOTTO M_ELEMENTS_MEZZA | Carte équipée avec Repères Topos et Valeurs Coté Éléments

LPNPAMELA

Fichiers Complémentaire

LPNHERMES
