Aldarme/PROJECT_CHAMP/ST50_Docs/rapport/AOP_FICHE_FABRICATION_OPBANDAOP.pdf

Feuille1

tel : | Fax :
Email :

LPNPAMELA

Fichiers Complémentaire

LPNHERMES

TOP | PLAN_CABLAGE_TOP_ELE MENTS_OPBANDAOP.pdf | Carte équipée avec Repères Topos et Valeurs Coté Éléments
BOTTOM | PLAN_CABLAGE_BOTTOM _ELEMENTS_OPBANDAOP. pdf | Carte équipée avec Repères Topos et Valeurs Coté Éléments
FACE | CABLAGE Fichiers .pdf | DÉSIGNATION
COUCHE DE ROUTAGE | CI.FAB Fichiers .art | DÉSIGNATION
Couche 1 | TOP | Fils + Plan GND
Couche 2 | BOTTOM | Fils + Plan GND
| DRILL | Plan de Perçage
| DIM | Dimensions
Pôle CAO-Câblage | promet@lpnhe.in2p3.fr
29/03/18 | 01/03/18
Nom de la carte : | OPBANDAOP
Expérience : | CHAMP
Dimensions : | 40 x 60 mm
Classe : | 4
Nombre de couche : | 2
Pad on Hole ( ou Via in Pad ) : | NON
Trous borgnes : | NON
L.P.N.H.E | Laboratoire de Physique Nucléaire et de Hautes Energies
I.N.2.P.3 – CNRS – Université Paris VI et VII 4 place Jussieu 75005
Pierre Promet | nc | nc
