Aldarme/PROJECT_CHAMP/PCB/accel_evalBoard/Docs/2.3/FootPrint.PNG

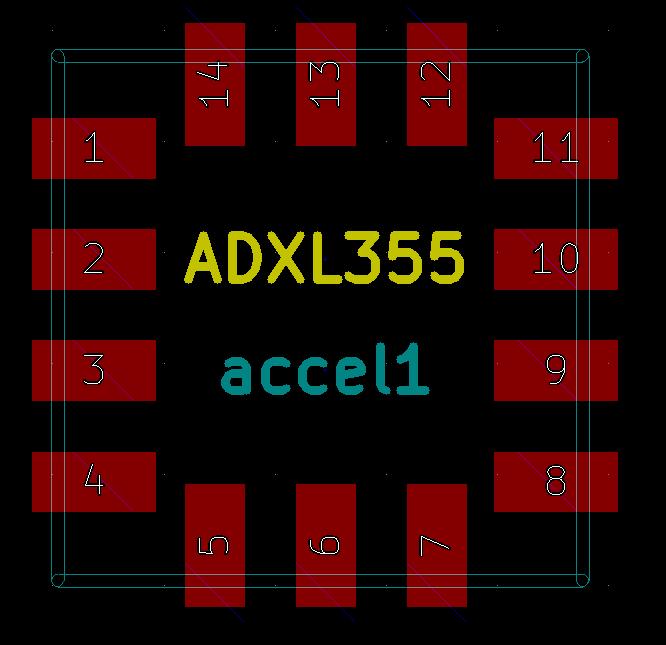
PCB/accel_evalBoard/Docs/2.3/FootPrint.PNG
