Aldarme/PROJECT_CHAMP/ST50_Docs/rapport/EVAL_Printing_Impression_Schématique.png

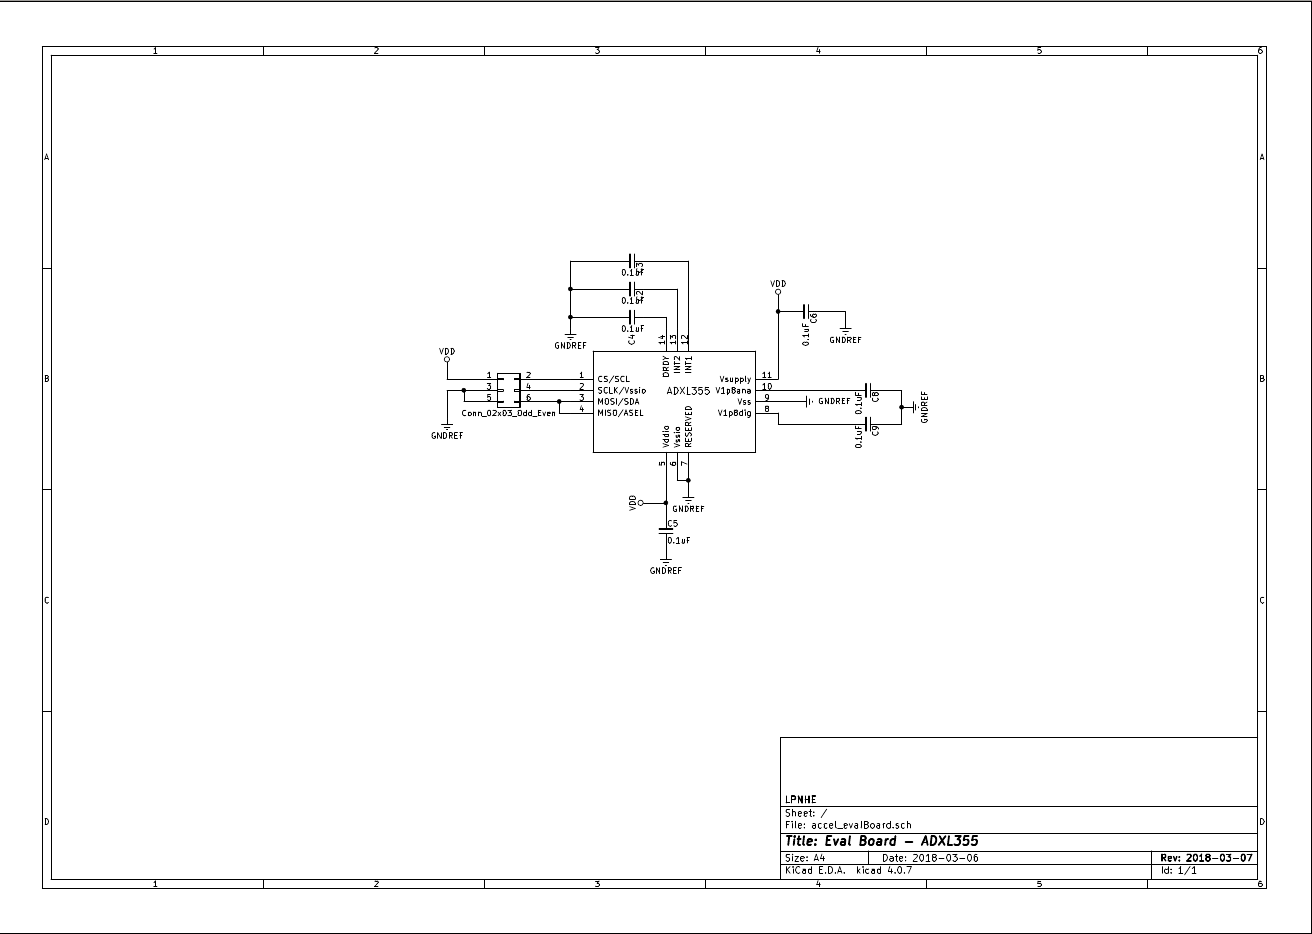
ST50_Docs/rapport/EVAL_Printing_Impression_Schématique.png
