Aldarme/PROJECT_CHAMP/ST50_Docs/Rapport_Img/Support_accelerometre/montage/V2/20180705_141719.jpg

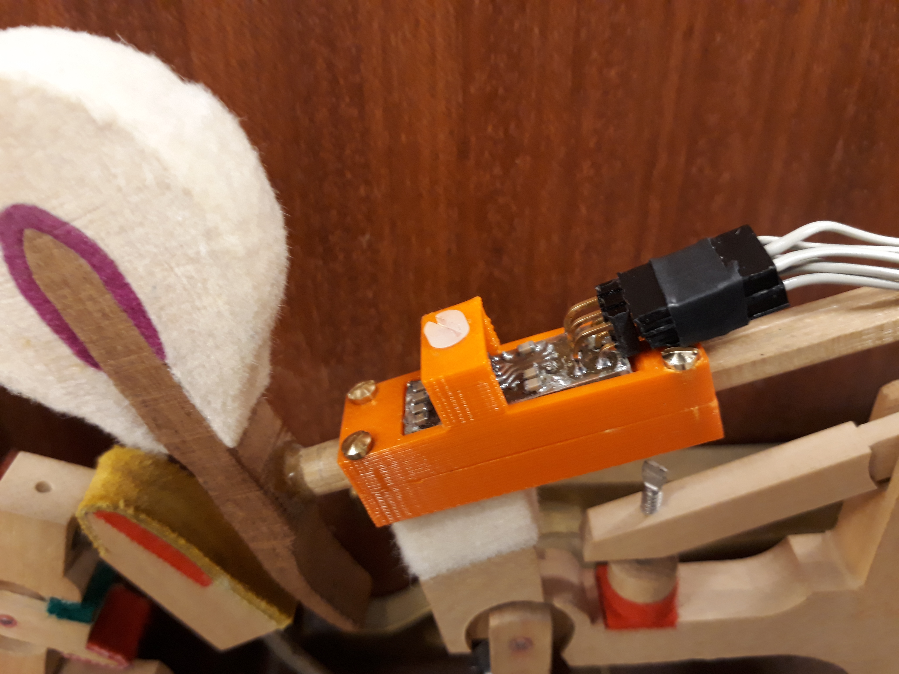
ST50_Docs/Rapport_Img/Support_accelerometre/montage/V2/20180705_141719.jpg
