Aldarme/PROJECT_CHAMP/ST50_Docs/Fiche_suivi/2018 07 P Romet EVALUATION STAGIAIRE - STUDENT ASSESSMENT ver fev 2018.xlsx

APPRECIATION FINALE & CONFIDENTIALITE / FINAL ASSESSMENT SHEET - Printemps/Spring 2018
A compléter par la personne directement responsable du stagiaire et retourner à (selon formation) / To be filled by the student's supervisor and sent back to :
mireille.jacquot@utbm.fr (Informatique / Computer Science) - alison.barbe@utbm.fr (Mécanique & Conception / Mechanical Engin. & Design + Masters Huma) - helene.schmittlein@utbm.fr (Energie / Energy)
helene.schmittlein@utbm.fr (Systèmes Industriels / Industrial Eng) - laurence.derriere@utbm.fr (Ergonomie, Design / Ergomics Industrial Design + Masters Sc.Techn)
le dernier jour du stage / on the last day of the internship
Etudiant + département de formation / Student + DEPT : |  |  | ROMET Pierre GI |  |  |  | Suiveur UTBM/ UTBM Tutor : |  | GECHTER Franck
Nom de l'Entreprise d'accueil + adresse postale (compléter ci-dessous) / Firm + postal address (please complete below)
LPNHE ; Sorbonne Université Campus Pierre-et-Marie-Curie ; Case courrier 200 ; 4 place Jussieu 75005 Paris
Nom du Tuteur entreprise (et service) / Supervisor in the company (and department) :
Lebbolo Hervé service électronique
Le tuteur a t-il changé pendant le semestre ? Did the supervisor change during the internship ? |  |  |  |  |  | non
Sujet traité (titre) / Job Description (title) :
Contrôle Haptique et Asservissement de la Mécanique des Pianos de concert.
Le sujet a-t-il changé pendant le semestre ? Did the job description changed during the internship ? |  |  |  |  |  | non
Si vous ne voulez pas que coordonnées et sujet soient communiqués à nos futurs stagiaires, envoyez un mail à / If you don’t want the above information to be available for next students, send an email to :
 |  |  |  | stages@utbm.fr
Confidentialité du rapport (voir fiche explicative jointe) / Confidential status of report (see enclosed document)
 | X | non confidentiel / Non confidential report |  |  | soutenance publique obligatoire
 |  | confidentiel et repris lors de la soutenance (ou rendu à l'étudiant) / confidential report sent back to the supervisor |  |  | soutenance à huis clos / presentation behind closed doors |  | non / no
 |  |  |  |  |  |  | oui / yes
Avez-vous été en contact avec le suiveur UTBM ?/ Have you been in touch with the UTBM supervisor ?
Oui / Yes | X | Si oui, comment ? / If yes how ? | par telephone / by phone
Non / No |  |  | par courriel / by email
 |  |  | par visite / by meeting |  | X
Complètez l'appréciation détaillée (de 1 -Insuffisant à 6 -Excellent) / File the detailed assessment (from 1 - Fail to 6 - Excellent)
 |  | être capable de : be able to : | 1 INSUFFISANT FAIL | 2 | 3 | 4 | 5 | 6 EXCELLENT | commentaires éventuels - any comments
Acteur / Actor | 1 | Comprendre le problème / Understand the issue
 | 2 | Résoudre le problème / Resolve the issue
 | 3 | Mettre en œuvre les solutions / Implement solutions
 | 4 | Vérifier et corriger / Check and correct
Communication / Communication | 5 | Chercher les informations / Search for information
 | 6 | Hiérarchiser et synthétiser les informations / Prioritize and summarize information
 | 7 | Transmettre les résultats / Transmit the results
 | 8 | Argumenter les choix / Evaluate choices
Gestion des relations sur le terrain / Dealing with shop-floor relations | 9 | Anticiper / Anticipate
 | 10 | Décider / Decide
 | 11 | Organiser / Organize
 | 12 | Contrôler / Check
Gestion des relations vers la hiérarchie / Relations with company management | 13 | Comprendre les directives / Understand instructions
 | 14 | Remonter l'information pertinente / Feed back relevant information
 | 15 | Proposer et faire valider / Propose and validate
 | 16 | Etre responsable & autonome /Demonstrate a responsible and self-sufficient attitude
Savoir Etre / Life Skills | 17 | Afficher une attitude professionnelle / Show a professional attitude
 | 18 | Respecter les temps et les délais / Meet schedules and deadlines
 | 19 | Assurer la qualité des rapports écrits & oraux /Ensure the quality of written & oral reports
 | 20 | Se soucier de la qualité des rapports humains / Demonstrate awareness of the importance of inter-personal relations
Avis d'ensemble sur la mission accomplie / overall assessment on the accomplished mission
Travail sérieux et efficace.
Nom de la personne qui remplit l'évaluation (si différent du tuteur), Fonction / Name of the person who fill this form -if different from tutor, Function
Date / Date |  |  |  |  |  | Réservé à l'UTBM / Reserved for UTBM
 |  | 2018-07-09 |  |  |  | A compléter par l'enseignant suiveur UTBM à l'issue de la soutenance :
 |  |  |  |  |  | nom + signature de la personne qui reprend le rapport confidentiel
CONFIDENTIALITE DU STAGE - FICHE EXPLICATIVE |  |  |  |  |  | CONFIDENTIAL STATUS OF THE INTERNSHIP
La confidentialité sur certains travaux de stages ou de projets peut s'appliquer à différents niveaux : le rapport, la soutenance, le titre du stage |  |  |  |  |  | Some placements are confidential : the confidentiality status of the report, oral presentation and details of the projects can be considered separately.
Le rapport |  |  |  |  |  | The report
L'étudiant(e) en fournit un exemplaire à son suiveur UTBM pour évaluation et au service des stages pour archivage et consultation ultérieure par les autres étudiants ou les enseignants de l'UTBM. |  |  |  |  |  | The student has to give one copy to his UTBM supervisor and to the training department.
Si le rapport est confidentiel, il est fourni à l’enseignant suiveur en un seul exemplaire papier. Il sera lu par le suiveur UTBM, mais les membres de jury de soutenance orale, tenus au secret professionnel, peuvent en avoir connaissance. Le tuteur entreprise, s’il assiste à la présentation orale de l’étudiant, pourra récupérer le rapport à cette occasion (signature d’une décharge). Sinon, l’étudiant le lui retournera à l’issue des jurys. Aucun exemplaire ne sera conservé à l’UTBM. NB - les annexes liées au rapport (incluses ou sous forme d’un fascicule séparé) seront considérées de la même manière que le rapport) |  |  |  |  |  | If the report is confidential, the student shall give his UTBM supervisor one paper copy of the confidential report. Only the UTBM tutor and the members of the oral presentation board can read it. The members of the board are held to comply with the confidential status and may not divulge any information to a third party. If the idustrial supervisor attends the presentation, he may retrieve, upon signature, the report afterward ; if not, the student will send back after the oral presentation. The UTBM will not retain a copy. NB - the report appendices will be considered in the same way (confidential report = confidential appendices).
La soutenance |  |  |  |  |  | Oral presentation
La soutenance orale de l’étudiant est ouverte au public. Uniquement dans le cas d’un rapport confidentiel, elle peut, à titre exceptionnel, se dérouler en l’absence de tout public (huis clos). Cela est à cocher sur la fiche d'évaluation. Seuls les représentants de l’entreprise et les membres du jury pourront y assister. |  |  |  |  |  | Students and industrialists may attend any non-confidential oral presentation. The oral presentations are open to the public. However, if the report is confidential, the industrial supervisor can decide if the oral presentation shall be behind closed doors. In this case, please tick the box on the assessment sheet. Only the industrialists from the company concerned by the internship and the members of the presentation board may attend a confidential presentation.
Diffusion des informations auprès des étudiants |  |  |  |  |  | Communication of information to the students
Les informations données sur la fiche « appréciation finale et confidentialité » (coordonnées de l’entreprise, nom du tuteur, email et sujet) sont affichées lors des soutenances. Elles sont également intégrées à une base de données à usage exclusif des étudiants de l’UTBM facilitant leurs recherches futures de stages ou d'emplois. Si vous ne souhaitez pas que ces informations (entreprise, adresse, tuteur, mail et sujet traité) apparaissent, merci d'envoyer un mail en ce sens à stage@utbm.fr |  |  |  |  |  | Every semester, the UTBM updates a list of the internships subjects for our students. The information mentioned upon the enclosed document (and industrial supervisor email) are added to a data bank that every student can consult when looking for an internship. If you do not want this information (company, address, tutor, mail and subject) to be published in the data bank, please inform UTBM placement department (stages@utbm.fr)
