Aldarme/PROJECT_CHAMP/Asservissement/courbe/testOscillo2/Analyse.xlsx

Sheet: 3v
x-axis | 1 | 2 | 20hz | x-axis |  |  | 30hz | x-axis | 1 | 2 | 40hz | x-axis | 1 | 2 | 50hz | x-axis | 1 | 2 | 70hz | x-axis | 1 | 2 | 100hz
second | Volt | Volt |  | second | Volt | Volt |  | second | Volt | Volt |  | second | Volt | Volt |  | second | Volt | Volt |  | second | Volt | Volt
-0.0488 | 0.055469 | 0.965625 |  | -0.0238 | 0.91093749 | 0.72148436 |  | -0.0238 | 0.26054686 | 1.01249999 |  | -0.0238 | -1.70625001 | 0.95195311 |  | -0.0238 | 0.66484374 | 0.85820311 |  | -0.0238 | -1.67304689 | 0.82109374
-0.0487 | 0.075 | 0.959766 |  | -0.02375 | 0.90703124 | 0.72148436 |  | -0.02375 | 0.27812499 | 1.01054686 |  | -0.02375 | -1.69453126 | 0.95390624 |  | -0.02375 | 0.64140624 | 0.85624999 |  | -0.02375 | -1.70039064 | 0.82304686
-0.0486 | 0.092578 | 0.957812 |  | -0.0237 | 0.90117186 | 0.72148436 |  | -0.0237 | 0.29570311 | 1.01054686 |  | -0.0237 | -1.68085939 | 0.95585936 |  | -0.0237 | 0.61992186 | 0.85429686 |  | -0.0237 | -1.72578126 | 0.82304686
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
