Aldarme/PROJECT_CHAMP/Asservissement/courbe/testOscillo2/3v100hz.xlsx

x-axis | 1 | 2
second | Volt | Volt
-0.0238 | -1.67304689 | 0.82109374
-0.02375 | -1.70039064 | 0.82304686
-0.0237 | -1.72578126 | 0.82304686
-0.02365 | -1.74921876 | 0.82499999
-0.0236 | -1.77070314 | 0.82695311
-0.02355 | -1.79609376 | 0.82695311
-0.0235 | -1.81562501 | 0.82890624
-0.02345 | -1.83320314 | 0.82890624
-0.0234 | -1.85078126 | 0.83085936
-0.02335 | -1.86640626 | 0.83085936
-0.0233 | -1.87812501 | 0.83085936
-0.02325 | -1.89375001 | 0.83281249
-0.0232 | -1.90742189 | 0.83281249
-0.02315 | -1.91718751 | 0.83476561
-0.0231 | -1.92500001 | 0.83476561
-0.02305 | -1.93281251 | 0.83671874
-0.023 | -1.93867189 | 0.83867186
-0.02295 | -1.94257814 | 0.84062499
-0.0229 | -1.94648439 | 0.84257811
-0.02285 | -1.94843751 | 0.84453124
-0.0228 | -1.94843751 | 0.84648436
-0.02275 | -1.94648439 | 0.84843749
-0.0227 | -1.94453126 | 0.85039061
-0.02265 | -1.94062501 | 0.85234374
-0.0226 | -1.93476564 | 0.85429686
-0.02255 | -1.92890626 | 0.85624999
-0.0225 | -1.92109376 | 0.85820311
-0.02245 | -1.91132814 | 0.86015624
-0.0224 | -1.89960939 | 0.86210936
-0.02235 | -1.88398439 | 0.86406249
-0.0223 | -1.87226564 | 0.86601561
-0.02225 | -1.85664064 | 0.86796874
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
