Aldarme/PROJECT_CHAMP/Asservissement/courbe/testOscillo2/3v20hz.xlsx

x-axis | 1 | 2
second | Volt | Volt
-0.0488 | 0.055469 | 0.965625
-0.0487 | 0.075 | 0.959766
-0.0486 | 0.092578 | 0.957812
-0.0485 | 0.110156 | 0.955859
-0.0484 | 0.125781 | 0.953906
-0.0483 | 0.141406 | 0.95
-0.0482 | 0.157031 | 0.946094
-0.0481 | 0.174609 | 0.942187
-0.048 | 0.192187 | 0.940234
-0.0479 | 0.207812 | 0.936328
-0.0478 | 0.225391 | 0.934375
-0.0477 | 0.241016 | 0.930469
-0.0476 | 0.258594 | 0.930469
-0.0475 | 0.274219 | 0.928516
-0.0474 | 0.291797 | 0.924609
-0.0473 | 0.307422 | 0.922656
-0.0472 | 0.325 | 0.920703
-0.0471 | 0.340625 | 0.916797
-0.047 | 0.35625 | 0.914844
-0.0469 | 0.371875 | 0.910937
-0.0468 | 0.3875 | 0.908984
-0.0467 | 0.401172 | 0.907031
-0.0466 | 0.414844 | 0.905078
-0.0465 | 0.432422 | 0.903125
-0.0464 | 0.448047 | 0.901172
-0.0463 | 0.463672 | 0.901172
-0.0462 | 0.479297 | 0.899219
-0.0461 | 0.494922 | 0.897266
-0.046 | 0.510547 | 0.897266
-0.0459 | 0.524219 | 0.895312
-0.0458 | 0.537891 | 0.893359
-0.0457 | 0.553516 | 0.891406
-0.0456 | 0.567187 | 0.889453
-0.0455 | 0.580859 | 0.8875
-0.0454 | 0.592578 | 0.885547
-0.0453 | 0.608203 | 0.885547
-0.0452 | 0.621875 | 0.883594
-0.0451 | 0.635547 | 0.883594
-0.045 | 0.645312 | 0.883594
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
