Aldarme/PROJECT_CHAMP/Asservissement/courbe/testOscillo2/3v30hz4.xlsx

x-axis
second | Volt | Volt
-0.0238 | 0.91093749 | 0.72148436
-0.02375 | 0.90703124 | 0.72148436
-0.0237 | 0.90117186 | 0.72148436
-0.02365 | 0.89335936 | 0.72148436
-0.0236 | 0.88749999 | 0.72148436
-0.02355 | 0.88164061 | 0.72343749
-0.0235 | 0.87382811 | 0.72343749
-0.02345 | 0.86406249 | 0.72539061
-0.0234 | 0.85820311 | 0.72539061
-0.02335 | 0.85234374 | 0.72539061
-0.0233 | 0.84843749 | 0.72539061
-0.02325 | 0.84062499 | 0.72734374
-0.0232 | 0.83476561 | 0.72734374
-0.02315 | 0.82890624 | 0.72734374
-0.0231 | 0.82109374 | 0.72734374
-0.02305 | 0.81328124 | 0.72929686
-0.023 | 0.80546874 | 0.72929686
-0.02295 | 0.79960936 | 0.72929686
-0.0229 | 0.79179686 | 0.72929686
-0.02285 | 0.78398436 | 0.72734374
-0.0228 | 0.77617186 | 0.72734374
-0.02275 | 0.76835936 | 0.72539061
-0.0227 | 0.75664061 | 0.72148436
-0.02265 | 0.74882811 | 0.71953124
-0.0226 | 0.74296874 | 0.71367186
-0.02255 | 0.73515624 | 0.70976561
-0.0225 | 0.72539061 | 0.70585936
-0.02245 | 0.71757811 | 0.69999999
-0.0224 | 0.70781249 | 0.69609374
-0.02235 | 0.69804686 | 0.69414061
-0.0223 | 0.69023436 | 0.69218749
-0.02225 | 0.68046874 | 0.69023436
-0.0222 | 0.67265624 | 0.69023436
-0.02215 | 0.66484374 | 0.69218749
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
