Aldarme/PROJECT_CHAMP/Asservissement/courbe/testOscillo2/3v40hz3.xlsx

x-axis | 1 | 2
second | Volt | Volt
-0.0238 | 0.26054686 | 1.01249999
-0.02375 | 0.27812499 | 1.01054686
-0.0237 | 0.29570311 | 1.01054686
-0.02365 | 0.31132811 | 1.00859374
-0.0236 | 0.32695311 | 1.00664061
-0.02355 | 0.34453124 | 1.00664061
-0.0235 | 0.35820311 | 1.00468749
-0.02345 | 0.37382811 | 1.00078124
-0.0234 | 0.38945311 | 0.99882811
-0.02335 | 0.40507811 | 0.99687499
-0.0233 | 0.41874999 | 0.99296874
-0.02325 | 0.43437499 | 0.99101561
-0.0232 | 0.44999999 | 0.98710936
-0.02315 | 0.46757811 | 0.98515624
-0.0231 | 0.48320311 | 0.98320311
-0.02305 | 0.49882811 | 0.98124999
-0.023 | 0.51445311 | 0.97929686
-0.02295 | 0.52812499 | 0.97929686
-0.0229 | 0.53984374 | 0.97734374
-0.02285 | 0.55546874 | 0.97734374
-0.0228 | 0.56914061 | 0.97734374
-0.02275 | 0.58281249 | 0.97929686
-0.0227 | 0.59648436 | 0.97929686
-0.02265 | 0.61015624 | 0.97929686
-0.0226 | 0.62382811 | 0.97929686
-0.02255 | 0.63749999 | 0.97929686
-0.0225 | 0.64921874 | 0.97929686
-0.02245 | 0.66289061 | 0.97734374
-0.0224 | 0.67460936 | 0.97734374
-0.02235 | 0.68632811 | 0.97539061
-0.0223 | 0.69804686 | 0.97343749
-0.02225 | 0.70976561 | 0.97343749
-0.0222 | 0.72148436 | 0.97148436
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
