Aldarme/PROJECT_CHAMP/Asservissement/courbe/testOscillo2/3v50hz2.xlsx

x-axis | 1 | 2
second | Volt | Volt
-0.0238 | -1.70625001 | 0.95195311
-0.02375 | -1.69453126 | 0.95390624
-0.0237 | -1.68085939 | 0.95585936
-0.02365 | -1.66523439 | 0.95781249
-0.0236 | -1.65351564 | 0.96171874
-0.02355 | -1.63984376 | 0.96367186
-0.0235 | -1.62617189 | 0.96562499
-0.02345 | -1.61054689 | 0.96757811
-0.0234 | -1.59687501 | 0.96953124
-0.02335 | -1.58125001 | 0.97148436
-0.0233 | -1.56367189 | 0.97343749
-0.02325 | -1.54609376 | 0.97343749
-0.0232 | -1.53046876 | 0.97539061
-0.02315 | -1.51484376 | 0.97734374
-0.0231 | -1.49726564 | 0.97734374
-0.02305 | -1.48164064 | 0.97929686
-0.023 | -1.46210939 | 0.97929686
-0.02295 | -1.44257814 | 0.98124999
-0.0229 | -1.42695314 | 0.98124999
-0.02285 | -1.40937501 | 0.98320311
-0.0228 | -1.38984376 | 0.98320311
-0.02275 | -1.37031251 | 0.98515624
-0.0227 | -1.35078126 | 0.98710936
-0.02265 | -1.32929689 | 0.98710936
-0.0226 | -1.30976564 | 0.98906249
-0.02255 | -1.29023439 | 0.99101561
-0.0225 | -1.27070314 | 0.99101561
-0.02245 | -1.25117189 | 0.99296874
-0.0224 | -1.23164064 | 0.99492186
-0.02235 | -1.21210939 | 0.99492186
-0.0223 | -1.19257814 | 0.99687499
-0.02225 | -1.17109376 | 0.99882811
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
