Aldarme/PROJECT_CHAMP/Asservissement/courbe/testOscillo2/3v70hz1.xlsx

x-axis | 1 | 2
second | Volt | Volt
-0.0238 | 0.66484374 | 0.85820311
-0.02375 | 0.64140624 | 0.85624999
-0.0237 | 0.61992186 | 0.85429686
-0.02365 | 0.59648436 | 0.85429686
-0.0236 | 0.57304686 | 0.85234374
-0.02355 | 0.54765624 | 0.85039061
-0.0235 | 0.52226561 | 0.84843749
-0.02345 | 0.49687499 | 0.84648436
-0.0234 | 0.46953124 | 0.84453124
-0.02335 | 0.44218749 | 0.84257811
-0.0233 | 0.41484374 | 0.84062499
-0.02325 | 0.38945311 | 0.83867186
-0.0232 | 0.36210936 | 0.83476561
-0.02315 | 0.33476561 | 0.83281249
-0.0231 | 0.30546874 | 0.83085936
-0.02305 | 0.27812499 | 0.82890624
-0.023 | 0.24687499 | 0.82695311
-0.02295 | 0.21757811 | 0.82304686
-0.0229 | 0.19023436 | 0.82109374
-0.02285 | 0.16093749 | 0.81914061
-0.0228 | 0.13164061 | 0.81718749
-0.02275 | 0.10234374 | 0.81523436
-0.0227 | 0.07109374 | 0.81328124
-0.02265 | 0.03984374 | 0.81132811
-0.0226 | 0.00664061 | 0.81132811
-0.02255 | -0.02656251 | 0.80937499
-0.0225 | -0.05585939 | 0.80742186
-0.02245 | -0.08710939 | 0.80546874
-0.0224 | -0.11835939 | 0.80351561
-0.02235 | -0.15156251 | 0.80156249
-0.0223 | -0.18476564 | 0.79960936
-0.02225 | -0.21796876 | 0.79765624
-0.0222 | -0.25117189 | 0.79570311
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
