Aldarme/PROJECT_CHAMP/Asservissement/courbe/testOscillo2/4v100hz.xlsx

x-axis | 1 | 2
second | Volt | Volt
-0.0488 | 1.143359 | 0.969531
-0.0487 | 1.215625 | 0.967578
-0.0486 | 1.278125 | 0.967578
-0.0485 | 1.338672 | 0.965625
-0.0484 | 1.389453 | 0.963672
-0.0483 | 1.430469 | 0.961719
-0.0482 | 1.467578 | 0.959766
-0.0481 | 1.496875 | 0.957812
-0.048 | 1.514453 | 0.953906
-0.0479 | 1.528125 | 0.951953
-0.0478 | 1.533984 | 0.948047
-0.0477 | 1.530078 | 0.944141
-0.0476 | 1.518359 | 0.942187
-0.0475 | 1.502734 | 0.936328
-0.0474 | 1.477344 | 0.932422
-0.0473 | 1.440234 | 0.926562
-0.0472 | 1.401172 | 0.922656
-0.0471 | 1.352344 | 0.916797
-0.047 | 1.295703 | 0.910937
-0.0469 | 1.233203 | 0.905078
-0.0468 | 1.162891 | 0.899219
-0.0467 | 1.090625 | 0.895312
-0.0466 | 1.010547 | 0.889453
-0.0465 | 0.922656 | 0.883594
-0.0464 | 0.828906 | 0.877734
-0.0463 | 0.73125 | 0.873828
-0.0462 | 0.629687 | 0.867969
-0.0461 | 0.520312 | 0.864062
-0.046 | 0.405078 | 0.860156
-0.0459 | 0.291797 | 0.854297
-0.0458 | 0.174609 | 0.850391
-0.0457 | 0.055469 | 0.846484
-0.0456 | -0.067578 | 0.840625
-0.0455 | -0.192578 | 0.836719
-0.0454 | -0.317578 | 0.830859
-0.0453 | -0.436719 | 0.825
-0.0452 | -0.555859 | 0.819141
-0.0451 | -0.684766 | 0.815234
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
