Aldarme/PROJECT_CHAMP/Asservissement/courbe/testOscillo2/4v20hz4.xlsx

x-axis | 1 | 2
second | Volt | Volt
-0.0488 | -1.175 | 0.787891
-0.0487 | -1.210156 | 0.758594
-0.0486 | -1.243359 | 0.737109
-0.0485 | -1.276563 | 0.73125
-0.0484 | -1.311719 | 0.741016
-0.0483 | -1.346875 | 0.750781
-0.0482 | -1.383984 | 0.752734
-0.0481 | -1.417188 | 0.760547
-0.048 | -1.450391 | 0.774219
-0.0479 | -1.483594 | 0.787891
-0.0478 | -1.516797 | 0.801562
-0.0477 | -1.548047 | 0.809375
-0.0476 | -1.58125 | 0.809375
-0.0475 | -1.6125 | 0.805469
-0.0474 | -1.639844 | 0.797656
-0.0473 | -1.671094 | 0.789844
-0.0472 | -1.700391 | 0.789844
-0.0471 | -1.729688 | 0.797656
-0.047 | -1.758984 | 0.809375
-0.0469 | -1.786328 | 0.825
-0.0468 | -1.815625 | 0.826953
-0.0467 | -1.841016 | 0.815234
-0.0466 | -1.868359 | 0.801562
-0.0465 | -1.89375 | 0.787891
-0.0464 | -1.917188 | 0.772266
-0.0463 | -1.944531 | 0.754687
-0.0462 | -1.967969 | 0.739062
-0.0461 | -1.991406 | 0.739062
-0.046 | -2.012891 | 0.760547
-0.0459 | -2.036328 | 0.789844
-0.0458 | -2.057813 | 0.819141
-0.0457 | -2.08125 | 0.842578
-0.0456 | -2.104688 | 0.864062
-0.0455 | -2.126172 | 0.881641
-0.0454 | -2.14375 | 0.885547
-0.0453 | -2.165234 | 0.877734
-0.0452 | -2.184766 | 0.862109
-0.0451 | -2.202344 | 0.844531
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
