Aldarme/PROJECT_CHAMP/Asservissement/courbe/testOscillo2/4v30hz5.xlsx

x-axis | 1 | 2
second | Volt | Volt
-0.0488 | 0.117969 | 1.030078
-0.0487 | 0.139453 | 1.028125
-0.0486 | 0.162891 | 1.022266
-0.0485 | 0.186328 | 1.018359
-0.0484 | 0.209766 | 1.0125
-0.0483 | 0.233203 | 1.008594
-0.0482 | 0.256641 | 1.004687
-0.0481 | 0.280078 | 1.000781
-0.048 | 0.303516 | 0.996875
-0.0479 | 0.326953 | 0.991016
-0.0478 | 0.350391 | 0.987109
-0.0477 | 0.373828 | 0.983203
-0.0476 | 0.395312 | 0.979297
-0.0475 | 0.416797 | 0.973437
-0.0474 | 0.440234 | 0.969531
-0.0473 | 0.463672 | 0.965625
-0.0472 | 0.487109 | 0.959766
-0.0471 | 0.510547 | 0.953906
-0.047 | 0.533984 | 0.95
-0.0469 | 0.555469 | 0.946094
-0.0468 | 0.575 | 0.940234
-0.0467 | 0.598437 | 0.936328
-0.0466 | 0.619922 | 0.930469
-0.0465 | 0.641406 | 0.924609
-0.0464 | 0.662891 | 0.920703
-0.0463 | 0.682422 | 0.914844
-0.0462 | 0.701953 | 0.908984
-0.0461 | 0.719531 | 0.905078
-0.046 | 0.742969 | 0.901172
-0.0459 | 0.764453 | 0.899219
-0.0458 | 0.782031 | 0.895312
-0.0457 | 0.801562 | 0.891406
-0.0456 | 0.821094 | 0.8875
-0.0455 | 0.838672 | 0.883594
-0.0454 | 0.85625 | 0.879687
-0.0453 | 0.875781 | 0.875781
-0.0452 | 0.895312 | 0.869922
-0.0451 | 0.914844 | 0.866016
-0.045 | 0.932422 | 0.860156
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
