Aldarme/PROJECT_CHAMP/Asservissement/courbe/testOscillo2/4v40hz3.xlsx

x-axis | 1 | 2
second | Volt | Volt
-0.0238 | 0.38749999 | 1.05742186
-0.02375 | 0.40898436 | 1.05742186
-0.0237 | 0.43242186 | 1.05546874
-0.02365 | 0.45585936 | 1.05351561
-0.0236 | 0.48124999 | 1.05156249
-0.02355 | 0.50273436 | 1.04960936
-0.0235 | 0.52617186 | 1.04765624
-0.02345 | 0.54765624 | 1.04570311
-0.0234 | 0.56914061 | 1.04374999
-0.02335 | 0.59062499 | 1.04374999
-0.0233 | 0.61406249 | 1.04179686
-0.02325 | 0.63554686 | 1.03984374
-0.0232 | 0.65507811 | 1.03984374
-0.02315 | 0.67656249 | 1.03789061
-0.0231 | 0.69609374 | 1.03789061
-0.02305 | 0.71367186 | 1.03789061
-0.023 | 0.73710936 | 1.03789061
-0.02295 | 0.75664061 | 1.03789061
-0.0229 | 0.77617186 | 1.03789061
-0.02285 | 0.79570311 | 1.03789061
-0.0228 | 0.81523436 | 1.03593749
-0.02275 | 0.83281249 | 1.03593749
-0.0227 | 0.85039061 | 1.03398436
-0.02265 | 0.86796874 | 1.03203124
-0.0226 | 0.88945311 | 1.03007811
-0.02255 | 0.90898436 | 1.02812499
-0.0225 | 0.92656249 | 1.02617186
-0.02245 | 0.94414061 | 1.02421874
-0.0224 | 0.96367186 | 1.02226561
-0.02235 | 0.97929686 | 1.02031249
-0.0223 | 0.99687499 | 1.01835936
-0.02225 | 1.01054686 | 1.01445311
-0.0222 | 1.03203124 | 1.01249999
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
