Aldarme/PROJECT_CHAMP/Asservissement/courbe/testOscillo2/4v50hz2.xlsx

x-axis | 1 | 2
second | Volt | Volt
-0.0238 | -2.19062501 | 0.96562499
-0.02375 | -2.17500001 | 0.96757811
-0.0237 | -2.15742189 | 0.96953124
-0.02365 | -2.13984376 | 0.96953124
-0.0236 | -2.12421876 | 0.97148436
-0.02355 | -2.10664064 | 0.97343749
-0.0235 | -2.08906251 | 0.97539061
-0.02345 | -2.06757814 | 0.97734374
-0.0234 | -2.05000001 | 0.97929686
-0.02335 | -2.03046876 | 0.98124999
-0.0233 | -2.01289064 | 0.98320311
-0.02325 | -1.99335939 | 0.98515624
-0.0232 | -1.97578126 | 0.98710936
-0.02315 | -1.95625001 | 0.98906249
-0.0231 | -1.93476564 | 0.99101561
-0.02305 | -1.91328126 | 0.99492186
-0.023 | -1.89375001 | 0.99687499
-0.02295 | -1.87226564 | 0.99882811
-0.0229 | -1.84882814 | 1.00273436
-0.02285 | -1.82734376 | 1.00468749
-0.0228 | -1.80585939 | 1.00664061
-0.02275 | -1.78046876 | 1.00859374
-0.0227 | -1.75703126 | 1.01054686
-0.02265 | -1.73359376 | 1.01249999
-0.0226 | -1.70820314 | 1.01249999
-0.02255 | -1.68476564 | 1.01445311
-0.0225 | -1.65937501 | 1.01640624
-0.02245 | -1.63398439 | 1.01835936
-0.0224 | -1.61054689 | 1.02031249
-0.02235 | -1.58515626 | 1.02226561
-0.0223 | -1.55781251 | 1.02421874
-0.02225 | -1.53046876 | 1.02617186
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
