Aldarme/PROJECT_CHAMP/Asservissement/courbe/testOscillo2/4v70hz1.xlsx

x-axis | 1 | 2
second | Volt | Volt
-0.0488 | -1.745313 | 0.778125
-0.0487 | -1.811719 | 0.782031
-0.0486 | -1.874219 | 0.783984
-0.0485 | -1.932813 | 0.787891
-0.0484 | -1.9875 | 0.789844
-0.0483 | -2.040234 | 0.791797
-0.0482 | -2.092969 | 0.789844
-0.0481 | -2.141797 | 0.789844
-0.048 | -2.186719 | 0.789844
-0.0479 | -2.227734 | 0.787891
-0.0478 | -2.266797 | 0.787891
-0.0477 | -2.301953 | 0.789844
-0.0476 | -2.333203 | 0.795703
-0.0475 | -2.354688 | 0.801562
-0.0474 | -2.382031 | 0.805469
-0.0473 | -2.401563 | 0.809375
-0.0472 | -2.417188 | 0.819141
-0.0471 | -2.428906 | 0.828906
-0.047 | -2.438672 | 0.836719
-0.0469 | -2.444531 | 0.840625
-0.0468 | -2.444531 | 0.846484
-0.0467 | -2.440625 | 0.850391
-0.0466 | -2.434766 | 0.85625
-0.0465 | -2.423047 | 0.858203
-0.0464 | -2.411328 | 0.862109
-0.0463 | -2.391797 | 0.866016
-0.0462 | -2.368359 | 0.873828
-0.0461 | -2.342969 | 0.879687
-0.046 | -2.317578 | 0.8875
-0.0459 | -2.284375 | 0.895312
-0.0458 | -2.249219 | 0.905078
-0.0457 | -2.20625 | 0.912891
-0.0456 | -2.165234 | 0.91875
-0.0455 | -2.118359 | 0.922656
-0.0454 | -2.065625 | 0.926562
-0.0453 | -2.012891 | 0.932422
-0.0452 | -1.960156 | 0.936328
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
