Aldarme/PROJECT_CHAMP/Asservissement/courbe/testOscillo2/5v100h.xlsx

x-axis | 1 | 2
second | Volt | Volt
-0.025 | -0.74140626 | 0.79570311
-0.02495 | -0.81757814 | 0.79374999
-0.0249 | -0.89375001 | 0.78984374
-0.02485 | -0.97187501 | 0.78789061
-0.0248 | -1.04804689 | 0.78593749
-0.02475 | -1.12226564 | 0.78203124
-0.0247 | -1.19843751 | 0.78007811
-0.02465 | -1.27070314 | 0.77812499
-0.0246 | -1.34687501 | 0.77617186
-0.02455 | -1.42304689 | 0.77421874
-0.0245 | -1.49726564 | 0.77226561
-0.02445 | -1.56757814 | 0.77031249
-0.0244 | -1.63789064 | 0.76835936
-0.02435 | -1.70625001 | 0.76835936
-0.0243 | -1.77265626 | 0.76640624
-0.02425 | -1.83906251 | 0.76640624
-0.0242 | -1.90156251 | 0.76445311
-0.02415 | -1.96406251 | 0.76445311
-0.0241 | -2.02265626 | 0.76445311
-0.02405 | -2.08320314 | 0.76249999
-0.024 | -2.14179689 | 0.76249999
-0.02395 | -2.20039064 | 0.76249999
-0.0239 | -2.25507814 | 0.76445311
-0.02385 | -2.30781251 | 0.76445311
-0.0238 | -2.35859376 | 0.76445311
-0.02375 | -2.40742189 | 0.76640624
-0.0237 | -2.45429689 | 0.76835936
-0.02365 | -2.50117189 | 0.76835936
-0.0236 | -2.54609376 | 0.77031249
-0.02355 | -2.59101564 | 0.77226561
-0.0235 | -2.63007814 | 0.77421874
-0.02345 | -2.66328126 | 0.77617186
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
