Aldarme/PROJECT_CHAMP/Asservissement/courbe/testOscillo2/5v20h5.xlsx

x-axis | 1 | 2
second | Volt | Volt
-0.0488 | 0.203906 | 1.133594
-0.0487 | 0.233203 | 1.127734
-0.0486 | 0.264453 | 1.121875
-0.0485 | 0.295703 | 1.117969
-0.0484 | 0.325 | 1.114062
-0.0483 | 0.354297 | 1.108203
-0.0482 | 0.383594 | 1.102344
-0.0481 | 0.412891 | 1.094531
-0.048 | 0.442187 | 1.086719
-0.0479 | 0.473437 | 1.076953
-0.0478 | 0.504687 | 1.067187
-0.0477 | 0.533984 | 1.057422
-0.0476 | 0.563281 | 1.049609
-0.0475 | 0.590625 | 1.04375
-0.0474 | 0.619922 | 1.037891
-0.0473 | 0.647266 | 1.032031
-0.0472 | 0.676562 | 1.028125
-0.0471 | 0.703906 | 1.024219
-0.047 | 0.73125 | 1.018359
-0.0469 | 0.760547 | 1.0125
-0.0468 | 0.785937 | 1.004687
-0.0467 | 0.813281 | 0.996875
-0.0466 | 0.836719 | 0.989062
-0.0465 | 0.864062 | 0.983203
-0.0464 | 0.891406 | 0.977344
-0.0463 | 0.91875 | 0.971484
-0.0462 | 0.946094 | 0.967578
-0.0461 | 0.971484 | 0.961719
-0.046 | 0.994922 | 0.955859
-0.0459 | 1.020312 | 0.948047
-0.0458 | 1.047656 | 0.940234
-0.0457 | 1.071094 | 0.932422
-0.0456 | 1.094531 | 0.926562
-0.0455 | 1.117969 | 0.91875
-0.0454 | 1.141406 | 0.912891
-0.0453 | 1.164844 | 0.905078
-0.0452 | 1.184375 | 0.897266
-0.0451 | 1.209766 | 0.891406
-0.045 | 1.233203 | 0.885547
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
