Aldarme/PROJECT_CHAMP/Asservissement/courbe/testOscillo2/5v40h3.xlsx

x-axis | 1 | 2
second | Volt | Volt
-0.025 | -0.17109376 | 1.14531249
-0.02495 | -0.13984376 | 1.14335936
-0.0249 | -0.10859376 | 1.14140624
-0.02485 | -0.07929689 | 1.13945311
-0.0248 | -0.04804689 | 1.13554686
-0.02475 | -0.01875001 | 1.13359374
-0.0247 | 0.01445311 | 1.12968749
-0.02465 | 0.04570311 | 1.12578124
-0.0246 | 0.07890624 | 1.12187499
-0.02455 | 0.10820311 | 1.11796874
-0.0245 | 0.13749999 | 1.11406249
-0.02445 | 0.16679686 | 1.10820311
-0.0244 | 0.19609374 | 1.10624999
-0.02435 | 0.22539061 | 1.10234374
-0.0243 | 0.25664061 | 1.10039061
-0.02425 | 0.28593749 | 1.09843749
-0.0242 | 0.31718749 | 1.09843749
-0.02415 | 0.34648436 | 1.09843749
-0.0241 | 0.37578124 | 1.09843749
-0.02405 | 0.40507811 | 1.10039061
-0.024 | 0.43437499 | 1.10234374
-0.02395 | 0.46367186 | 1.10429686
-0.0239 | 0.49687499 | 1.10624999
-0.02385 | 0.52617186 | 1.11015624
-0.0238 | 0.55546874 | 1.11210936
-0.02375 | 0.58281249 | 1.11406249
-0.0237 | 0.61210936 | 1.11406249
-0.02365 | 0.64140624 | 1.11210936
-0.0236 | 0.66874999 | 1.11015624
-0.02355 | 0.69609374 | 1.10624999
-0.0235 | 0.72343749 | 1.10234374
-0.02345 | 0.75273436 | 1.09843749
-0.0234 | 0.78007811 | 1.09453124
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
