Aldarme/PROJECT_CHAMP/Asservissement/courbe/testOscillo2/5v50h2.xlsx

x-axis | 1 | 2
second | Volt | Volt
-0.025 | -2.92890626 | 0.89921874
-0.02495 | -2.92304689 | 0.90312499
-0.0249 | -2.91914064 | 0.90703124
-0.02485 | -2.91328126 | 0.91093749
-0.0248 | -2.90937501 | 0.91484374
-0.02475 | -2.90156251 | 0.91874999
-0.0247 | -2.89375001 | 0.92265624
-0.02465 | -2.88593751 | 0.92656249
-0.0246 | -2.87617189 | 0.93046874
-0.02455 | -2.86835939 | 0.93242186
-0.0245 | -2.85664064 | 0.93632811
-0.02445 | -2.84296876 | 0.94023436
-0.0244 | -2.83125001 | 0.94218749
-0.02435 | -2.82343751 | 0.94609374
-0.0243 | -2.81367189 | 0.94804686
-0.02425 | -2.80000001 | 0.94999999
-0.0242 | -2.78632814 | 0.95195311
-0.02415 | -2.77265626 | 0.95390624
-0.0241 | -2.75507814 | 0.95781249
-0.02405 | -2.73750001 | 0.95976561
-0.024 | -2.72578126 | 0.96171874
-0.02395 | -2.70820314 | 0.96562499
-0.0239 | -2.69257814 | 0.96757811
-0.02385 | -2.67304689 | 0.96953124
-0.0238 | -2.65156251 | 0.97343749
-0.02375 | -2.63789064 | 0.97539061
-0.0237 | -2.62031251 | 0.97929686
-0.02365 | -2.60078126 | 0.98124999
-0.0236 | -2.57734376 | 0.98515624
-0.02355 | -2.55390626 | 0.98710936
-0.0235 | -2.53437501 | 0.99101561
-0.02345 | -2.51289064 | 0.99492186
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
