Aldarme/PROJECT_CHAMP/Asservissement/courbe/testOscillo2/5v70h1.xlsx

x-axis | 1 | 2
second | Volt | Volt
-0.025 | 2.01835936 | 0.92851561
-0.02495 | 2.01054686 | 0.92460936
-0.0249 | 2.00273436 | 0.92265624
-0.02485 | 1.99687499 | 0.92070311
-0.0248 | 1.98710936 | 0.91679686
-0.02475 | 1.97539061 | 0.91484374
-0.0247 | 1.96367186 | 0.91093749
-0.02465 | 1.94609374 | 0.90703124
-0.0246 | 1.92656249 | 0.90312499
-0.02455 | 1.91093749 | 0.89726561
-0.0245 | 1.89726561 | 0.89335936
-0.02445 | 1.87773436 | 0.88945311
-0.0244 | 1.86015624 | 0.88554686
-0.02435 | 1.83671874 | 0.88164061
-0.0243 | 1.81718749 | 0.87773436
-0.02425 | 1.79374999 | 0.87382811
-0.0242 | 1.77031249 | 0.86992186
-0.02415 | 1.73906249 | 0.86601561
-0.0241 | 1.71757811 | 0.86210936
-0.02405 | 1.68828124 | 0.85820311
-0.024 | 1.65703124 | 0.85624999
-0.02395 | 1.62968749 | 0.85234374
-0.0239 | 1.59843749 | 0.85039061
-0.02385 | 1.56328124 | 0.84843749
-0.0238 | 1.53203124 | 0.84843749
-0.02375 | 1.49882811 | 0.84453124
-0.0237 | 1.46367186 | 0.84257811
-0.02365 | 1.43046874 | 0.84062499
-0.0236 | 1.39335936 | 0.83671874
-0.02355 | 1.35624999 | 0.83281249
-0.0235 | 1.31914061 | 0.83085936
-0.02345 | 1.27812499 | 0.82695311
-0.0234 | 1.23906249 | 0.82304686
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
