Aldarme/PROJECT_CHAMP/Asservissement/courbe/testOscillo/Analyse.xlsx

Sheet: Paramètre
Anlg Ch | State | Units/Div | Position | Coupling | BW Limit | Invert
Ch1 | on | 500mv | -1.3 | Dc | off | off
Ch2 | on | 500mv | 1.5 | Dc | off | off
Anlg ch | Impedence | Probe
Ch1 | 50 ohm | 1,0 : 1
Ch2 | 1M ohm | 1,0 : 1
Trigger | Mode | Coupling | Holdoff
tv | auto | tv | 60ns
Trigger | Source | Polarity | Standard | Mode
tv | Ch1 | positive | NTSC | field
Time | Time ref | Main s/div | Delay
Normal | center | 100 ms | 0,0s
Acquisition | #avgs | Realtime | Vectors | Inf Persist
Averaging | 8 | off | on | off
Measure | Current | Mean | Min | Max | Std dev | Count
Freqency(1) | 10 hz |  |  |  |  | 0
PK-Pk(1) | 400mV |  |  |  |  | 0
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
