Aldarme/PROJECT_CHAMP/Asservissement/courbe/testOscillo/1v10hz4.csv

x-axis | 1 | 2
second | Volt | Volt
-1,000000E+00 | -455,719E-03 | +949,219E-03
-998,000E-03 | -446,930E-03 | +952,148E-03
-996,000E-03 | -436,188E-03 | +943,359E-03
-994,000E-03 | -426,422E-03 | +933,594E-03
-992,000E-03 | -416,656E-03 | +922,852E-03
-990,000E-03 | -404,938E-03 | +926,758E-03
-988,000E-03 | -394,195E-03 | +918,945E-03
-986,000E-03 | -384,430E-03 | +919,922E-03
-984,000E-03 | -374,664E-03 | +922,852E-03
-982,000E-03 | -364,898E-03 | +909,180E-03
-980,000E-03 | -355,133E-03 | +906,250E-03
-978,000E-03 | -347,320E-03 | +901,367E-03
-976,000E-03 | -339,508E-03 | +894,531E-03
-974,000E-03 | -332,672E-03 | +895,508E-03
-972,000E-03 | -327,789E-03 | +889,648E-03
-970,000E-03 | -323,883E-03 | +903,320E-03
-968,000E-03 | -320,953E-03 | +894,531E-03
-966,000E-03 | -319,000E-03 | +891,602E-03
-964,000E-03 | -319,000E-03 | +890,625E-03
-962,000E-03 | -320,953E-03 | +898,438E-03
-960,000E-03 | -323,883E-03 | +887,695E-03
-958,000E-03 | -327,789E-03 | +889,648E-03
-956,000E-03 | -332,672E-03 | +887,695E-03
-954,000E-03 | -338,531E-03 | +886,719E-03
-952,000E-03 | -345,367E-03 | +885,742E-03
-950,000E-03 | -353,180E-03 | +889,648E-03
-948,000E-03 | -361,969E-03 | +887,695E-03
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
