Aldarme/PROJECT_CHAMP/Asservissement/courbe/testOscillo/1v10hz5.csv

x-axis | 1 | 2
second | Volt | Volt
-500,000E-03 | -449,859E-03 | +944,336E-03
-499,000E-03 | -449,859E-03 | +949,219E-03
-498,000E-03 | -450,836E-03 | +947,266E-03
-497,000E-03 | -450,836E-03 | +945,313E-03
-496,000E-03 | -450,836E-03 | +936,523E-03
-495,000E-03 | -450,836E-03 | +931,641E-03
-494,000E-03 | -450,836E-03 | +939,453E-03
-493,000E-03 | -450,836E-03 | +949,219E-03
-492,000E-03 | -449,859E-03 | +945,313E-03
-491,000E-03 | -448,883E-03 | +958,008E-03
-490,000E-03 | -447,906E-03 | +955,078E-03
-489,000E-03 | -446,930E-03 | +955,078E-03
-488,000E-03 | -444,977E-03 | +960,938E-03
-487,000E-03 | -444,000E-03 | +943,359E-03
-486,000E-03 | -442,047E-03 | +947,266E-03
-485,000E-03 | -440,094E-03 | +950,195E-03
-484,000E-03 | -438,141E-03 | +922,852E-03
-483,000E-03 | -435,211E-03 | +939,453E-03
-482,000E-03 | -433,258E-03 | +942,383E-03
-481,000E-03 | -430,328E-03 | +934,570E-03
-480,000E-03 | -428,375E-03 | +939,453E-03
-479,000E-03 | -425,445E-03 | +940,430E-03
-478,000E-03 | -422,516E-03 | +925,781E-03
-477,000E-03 | -420,563E-03 | +922,852E-03
-476,000E-03 | -417,633E-03 | +926,758E-03
-475,000E-03 | -415,680E-03 | +915,039E-03
-474,000E-03 | -412,750E-03 | +903,320E-03
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
