Aldarme/PROJECT_CHAMP/Asservissement/courbe/testOscillo/1v10hz6.csv

x-axis | 1 | 2
second | Volt | Volt
-500.000E-03 | -273.102E-03 | +871.094E-03
-499.000E-03 | -282.867E-03 | +866.211E-03
-498.000E-03 | -292.633E-03 | +856.445E-03
-497.000E-03 | -303.375E-03 | +866.211E-03
-496.000E-03 | -314.117E-03 | +861.328E-03
-495.000E-03 | -325.836E-03 | +864.258E-03
-494.000E-03 | -337.555E-03 | +866.211E-03
-493.000E-03 | -350.250E-03 | +871.094E-03
-492.000E-03 | -361.969E-03 | +879.883E-03
-491.000E-03 | -374.664E-03 | +892.578E-03
-490.000E-03 | -387.359E-03 | +881.836E-03
-489.000E-03 | -400.055E-03 | +889.648E-03
-488.000E-03 | -412.750E-03 | +895.508E-03
-487.000E-03 | -425.445E-03 | +902.344E-03
-486.000E-03 | -437.164E-03 | +904.297E-03
-485.000E-03 | -448.883E-03 | +909.180E-03
-484.000E-03 | -460.602E-03 | +920.898E-03
-483.000E-03 | -473.297E-03 | +920.898E-03
-482.000E-03 | -485.016E-03 | +929.688E-03
-481.000E-03 | -495.758E-03 | +928.711E-03
-480.000E-03 | -506.500E-03 | +930.664E-03
-479.000E-03 | -517.242E-03 | +918.945E-03
-478.000E-03 | -527.008E-03 | +925.781E-03
-477.000E-03 | -536.773E-03 | +951.172E-03
-476.000E-03 | -546.539E-03 | +949.219E-03
-475.000E-03 | -555.328E-03 | +956.055E-03
-474.000E-03 | -564.117E-03 | +972.656E-03
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
