Aldarme/PROJECT_CHAMP/Asservissement/courbe/testOscillo/1v20hz3.csv

x-axis | 1 | 2
second | Volt | Volt
-500,000E-03 | -485,016E-03 | +941,406E-03
-499,000E-03 | -476,227E-03 | +941,406E-03
-498,000E-03 | -466,461E-03 | +939,453E-03
-497,000E-03 | -455,719E-03 | +937,500E-03
-496,000E-03 | -444,000E-03 | +932,617E-03
-495,000E-03 | -432,281E-03 | +926,758E-03
-494,000E-03 | -419,586E-03 | +928,711E-03
-493,000E-03 | -406,891E-03 | +925,781E-03
-492,000E-03 | -394,195E-03 | +923,828E-03
-491,000E-03 | -381,500E-03 | +925,781E-03
-490,000E-03 | -368,805E-03 | +925,781E-03
-489,000E-03 | -356,109E-03 | +927,734E-03
-488,000E-03 | -345,367E-03 | +928,711E-03
-487,000E-03 | -335,602E-03 | +926,758E-03
-486,000E-03 | -326,813E-03 | +923,828E-03
-485,000E-03 | -319,000E-03 | +921,875E-03
-484,000E-03 | -313,141E-03 | +920,898E-03
-483,000E-03 | -308,258E-03 | +917,969E-03
-482,000E-03 | -304,352E-03 | +915,039E-03
-481,000E-03 | -303,375E-03 | +916,016E-03
-480,000E-03 | -302,398E-03 | +910,156E-03
-479,000E-03 | -304,352E-03 | +905,273E-03
-478,000E-03 | -307,281E-03 | +901,367E-03
-477,000E-03 | -311,188E-03 | +906,250E-03
-476,000E-03 | -317,047E-03 | +905,273E-03
-475,000E-03 | -324,859E-03 | +902,344E-03
-474,000E-03 | -333,648E-03 | +903,320E-03
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
