Aldarme/PROJECT_CHAMP/Asservissement/courbe/testOscillo/1v30hz.csv

x-axis | 1 | 2
second | Volt | Volt
-500,000E-03 | -506,500E-03 | +924,805E-03
-499,000E-03 | -513,336E-03 | +925,781E-03
-498,000E-03 | -515,289E-03 | +923,828E-03
-497,000E-03 | -513,336E-03 | +931,641E-03
-496,000E-03 | -508,453E-03 | +931,641E-03
-495,000E-03 | -499,664E-03 | +926,758E-03
-494,000E-03 | -487,945E-03 | +928,711E-03
-493,000E-03 | -474,273E-03 | +931,641E-03
-492,000E-03 | -457,672E-03 | +934,570E-03
-491,000E-03 | -438,141E-03 | +938,477E-03
-490,000E-03 | -417,633E-03 | +929,688E-03
-489,000E-03 | -397,125E-03 | +935,547E-03
-488,000E-03 | -376,617E-03 | +930,664E-03
-487,000E-03 | -357,086E-03 | +925,781E-03
-486,000E-03 | -339,508E-03 | +933,594E-03
-485,000E-03 | -324,859E-03 | +926,758E-03
-484,000E-03 | -314,117E-03 | +923,828E-03
-483,000E-03 | -304,352E-03 | +920,898E-03
-482,000E-03 | -299,469E-03 | +921,875E-03
-481,000E-03 | -296,539E-03 | +921,875E-03
-480,000E-03 | -298,492E-03 | +916,992E-03
-479,000E-03 | -306,305E-03 | +913,086E-03
-478,000E-03 | -316,070E-03 | +902,344E-03
-477,000E-03 | -329,742E-03 | +900,391E-03
-476,000E-03 | -345,367E-03 | +897,461E-03
-475,000E-03 | -362,945E-03 | +892,578E-03
-474,000E-03 | -383,453E-03 | +888,672E-03
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
