Aldarme/PROJECT_CHAMP/Asservissement/courbe/testOscillo/1v40hz2.csv

x-axis | 1 | 2
second | Volt | Volt
-500,000E-03 | -574,859E-03 | +965,820E-03
-499,000E-03 | -461,578E-03 | +964,844E-03
-498,000E-03 | -343,414E-03 | +961,914E-03
-497,000E-03 | -229,156E-03 | +953,125E-03
-496,000E-03 | -125,641E-03 | +944,336E-03
-495,000E-03 | -41,656E-03 | +939,453E-03
-494,000E-03 | +19,867E-03 | +926,758E-03
-493,000E-03 | +56,000E-03 | +916,016E-03
-492,000E-03 | +62,836E-03 | +901,367E-03
-491,000E-03 | +40,375E-03 | +894,531E-03
-490,000E-03 | -11,383E-03 | +882,813E-03
-489,000E-03 | -86,578E-03 | +875,977E-03
-488,000E-03 | -181,305E-03 | +873,047E-03
-487,000E-03 | -290,680E-03 | +874,023E-03
-486,000E-03 | -407,867E-03 | +876,953E-03
-485,000E-03 | -525,055E-03 | +884,766E-03
-484,000E-03 | -634,430E-03 | +891,602E-03
-483,000E-03 | -729,156E-03 | +899,414E-03
-482,000E-03 | -803,375E-03 | +911,133E-03
-481,000E-03 | -853,180E-03 | +921,875E-03
-480,000E-03 | -875,641E-03 | +930,664E-03
-479,000E-03 | -866,852E-03 | +944,336E-03
-478,000E-03 | -829,742E-03 | +951,172E-03
-477,000E-03 | -765,289E-03 | +958,984E-03
-476,000E-03 | -679,352E-03 | +965,820E-03
-475,000E-03 | -574,859E-03 | +966,797E-03
-474,000E-03 | -461,578E-03 | +960,938E-03
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
