Aldarme/PROJECT_CHAMP/ST50_Docs/rapport/PLAN_CABLAGE_BOTTOM_ELEMENTS_MEZZA.pdf

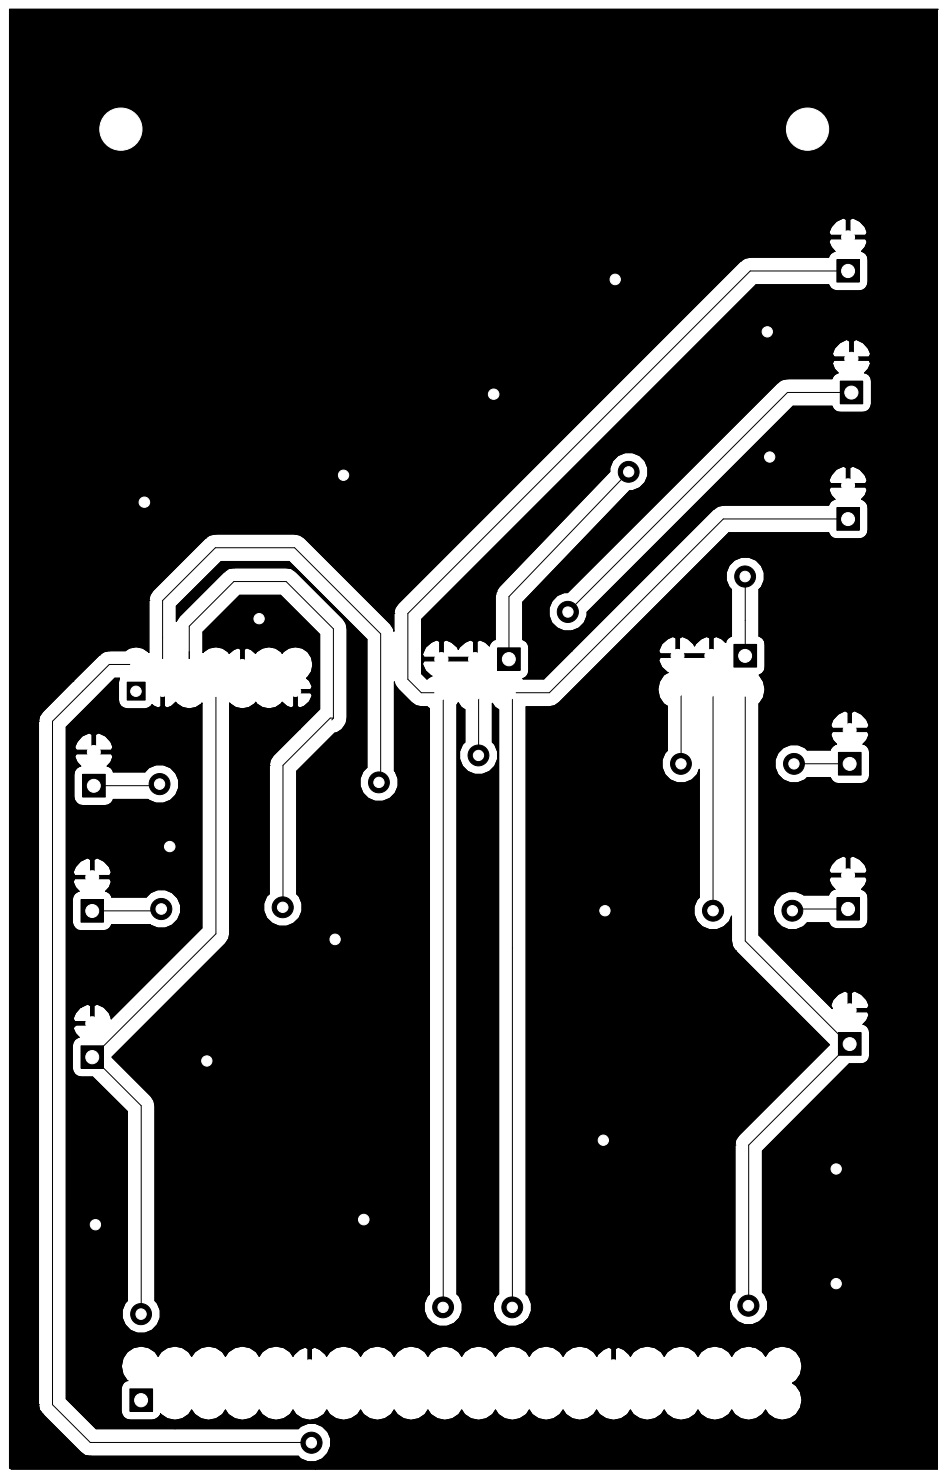
[picture p215: page 1]
