Aldarme/PROJECT_CHAMP/ST50_Docs/rapport/PLAN_CABLAGE_TOP_ELEMENTS_MEZZA.pdf

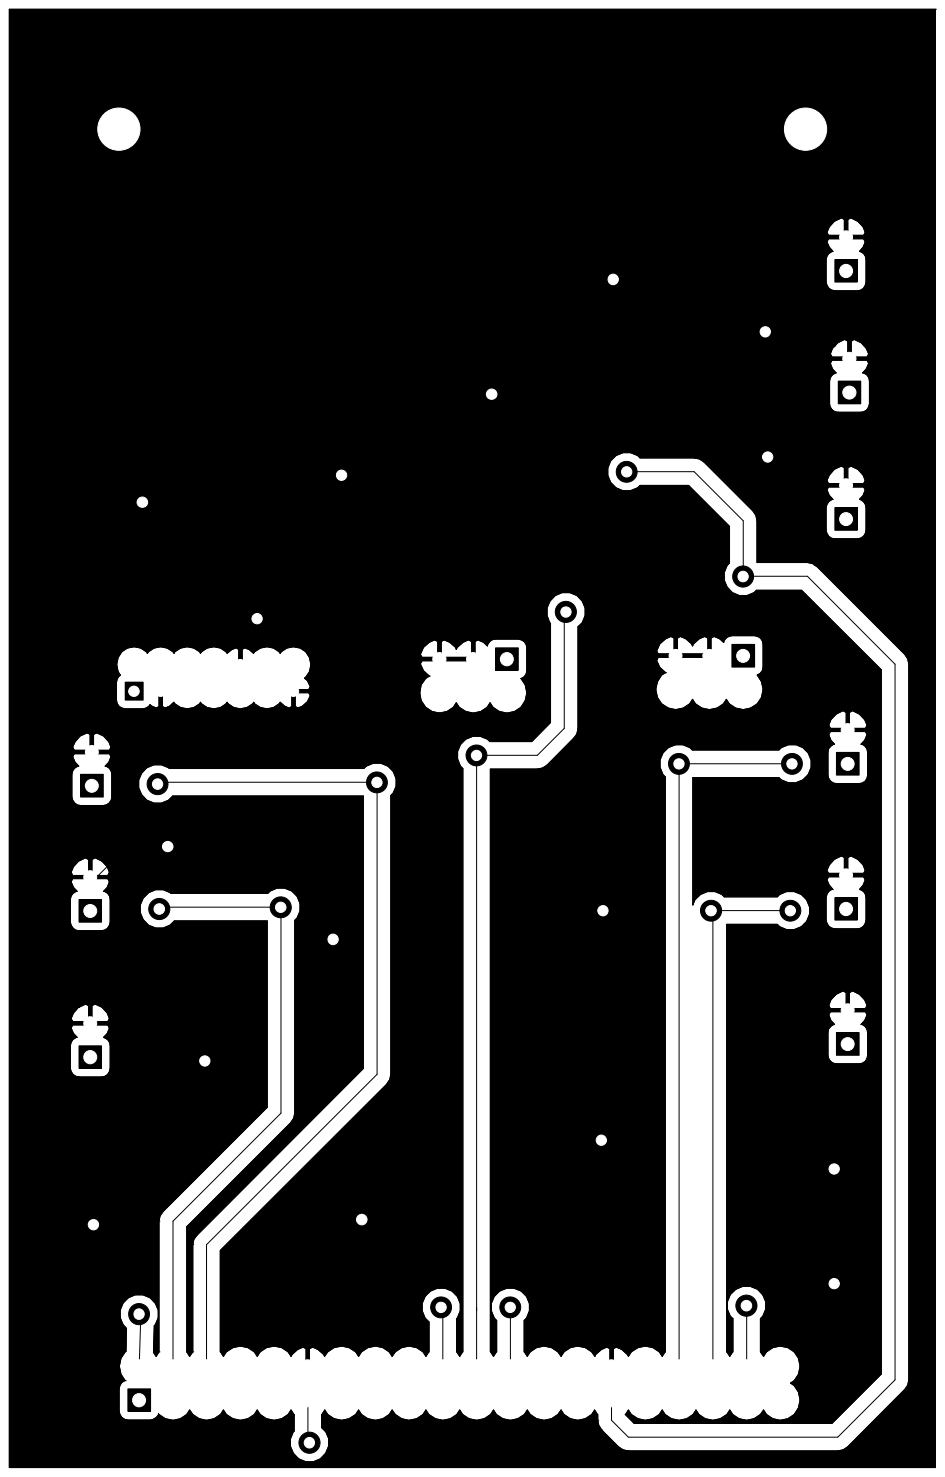
[picture p216: page 1]
