Aldarme/PROJECT_CHAMP/ST50_Docs/rapport/FICHIER_DIMENSION_MEZZA.pdf

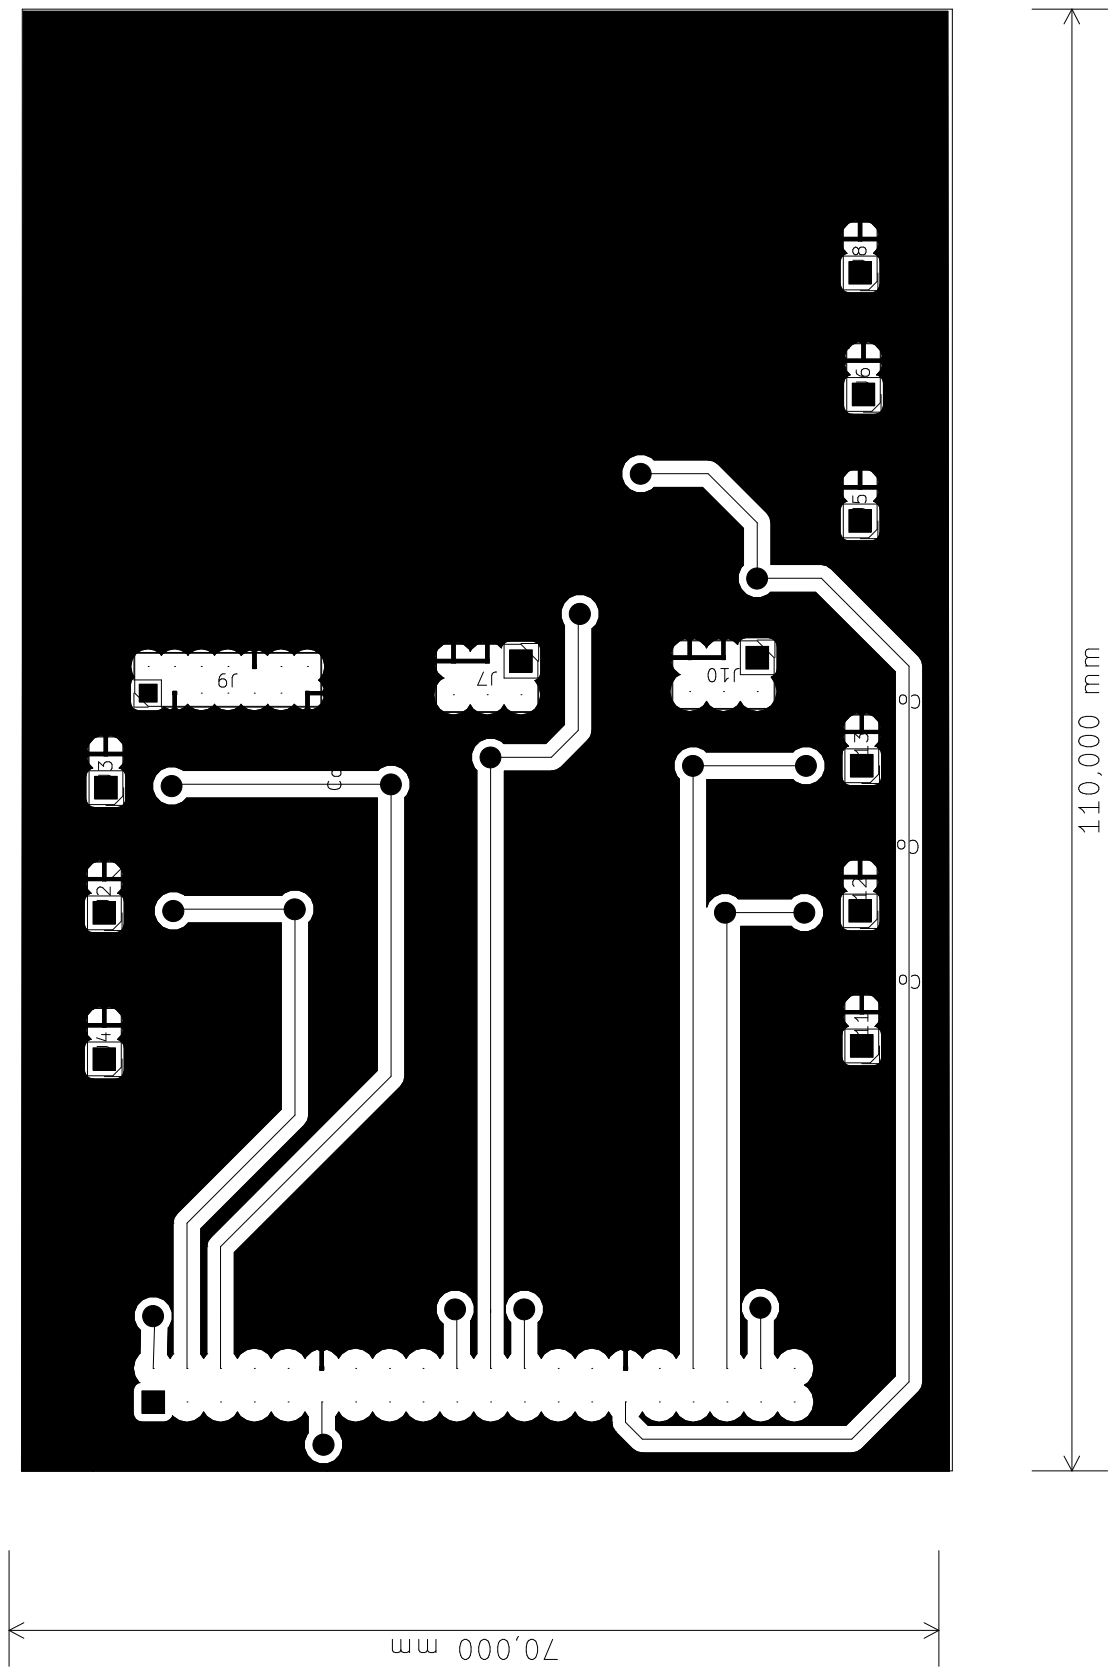
[picture p217: page 1]
