Aldarme/PROJECT_CHAMP/ST50_Docs/rapport/M_PRINTING_IMPRESS_SCHEMATIC.pdf

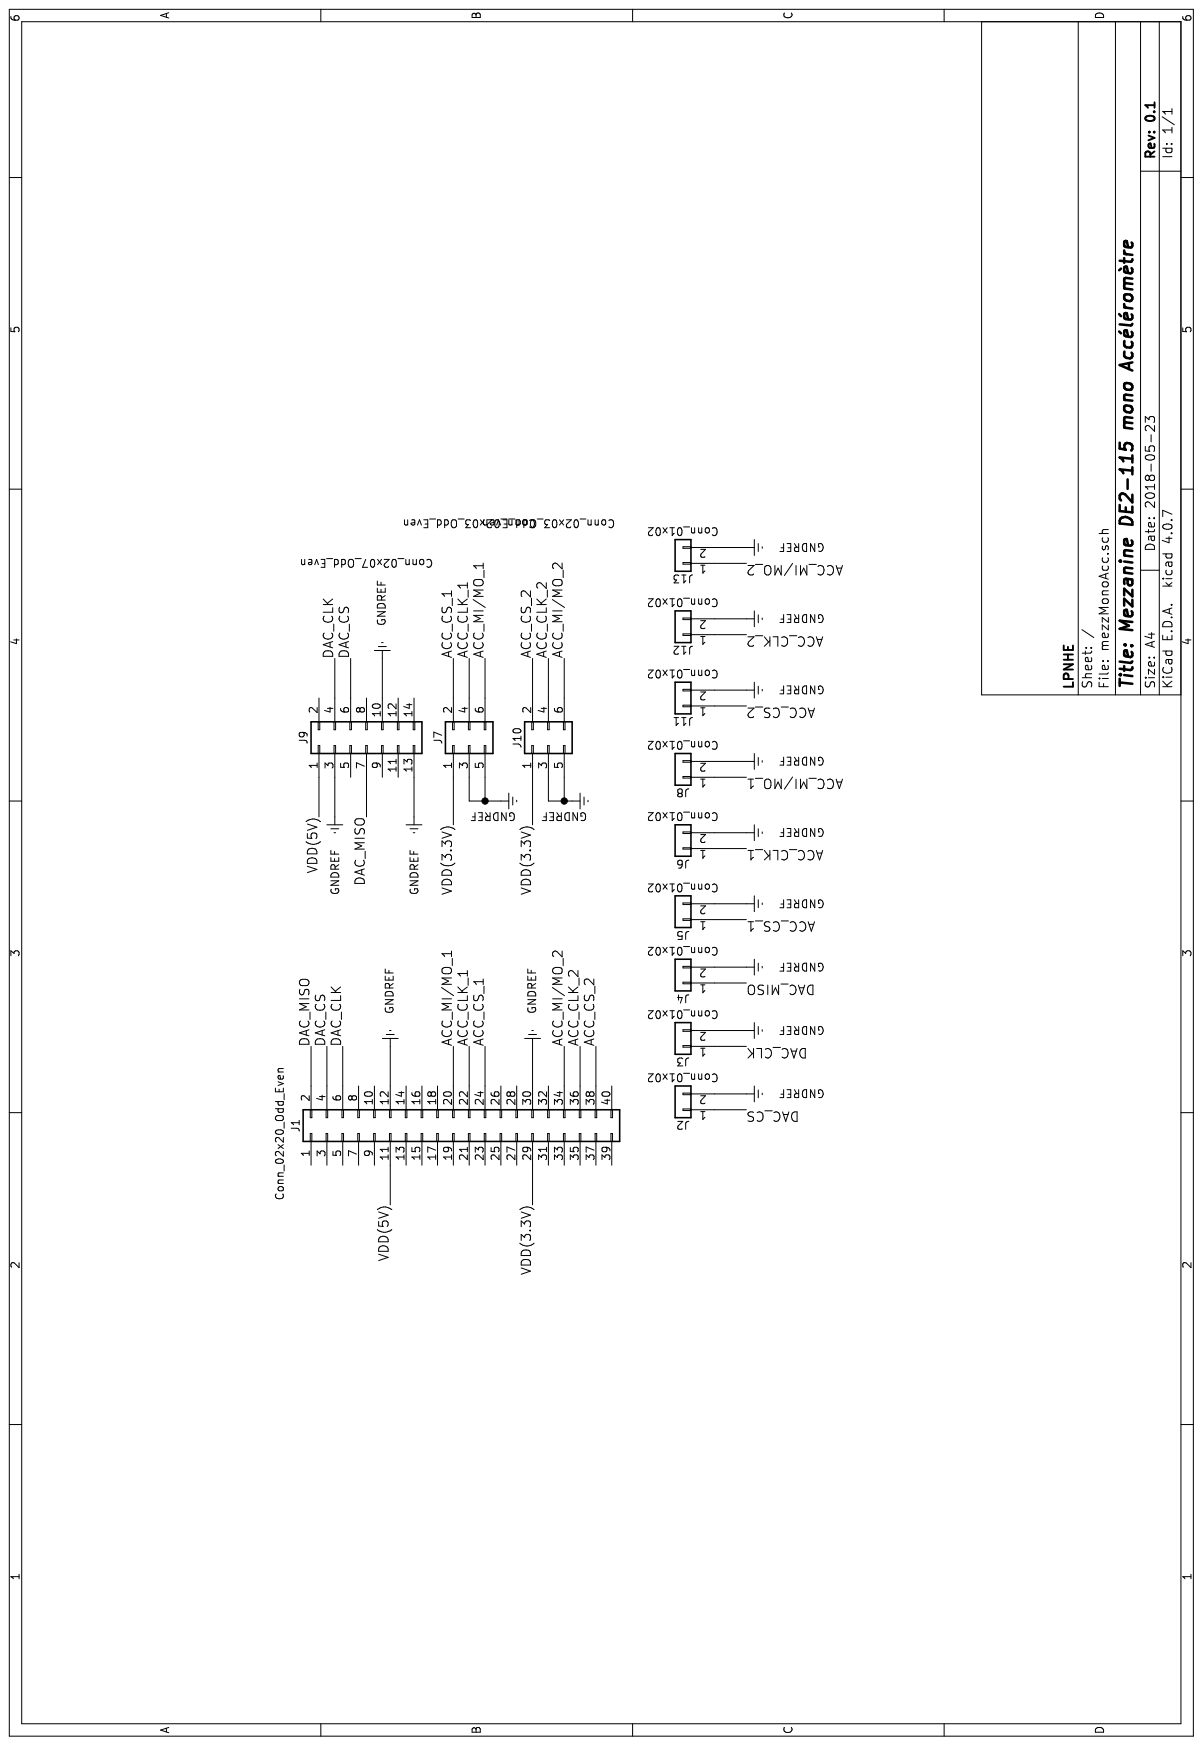
[picture p218: page 1]
