Aldarme/PROJECT_CHAMP/ST50_Docs/rapport/AOP_PLAN_CABLAGE_BOTTOM_ELEMENTS_OPBANDAOP.pdf

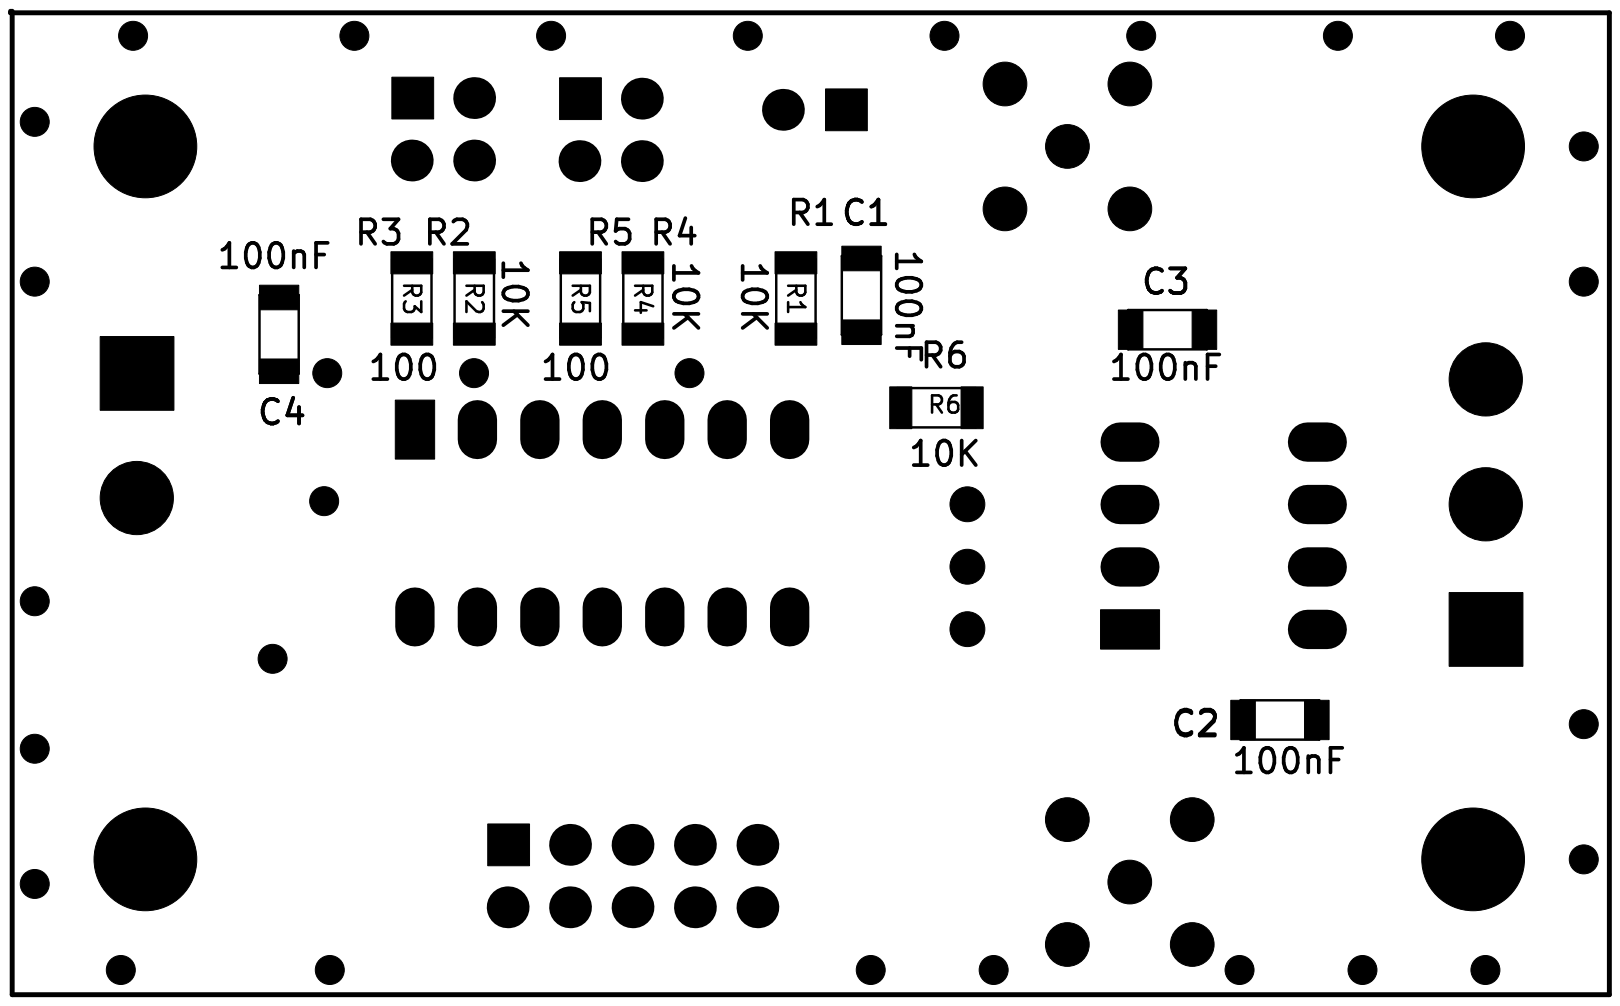
[picture p219: page 1]
