Aldarme/PROJECT_CHAMP/ST50_Docs/rapport/AOP_PLAN_CABLAGE_TOP_ELEMENTS_OPBANDAOP.pdf

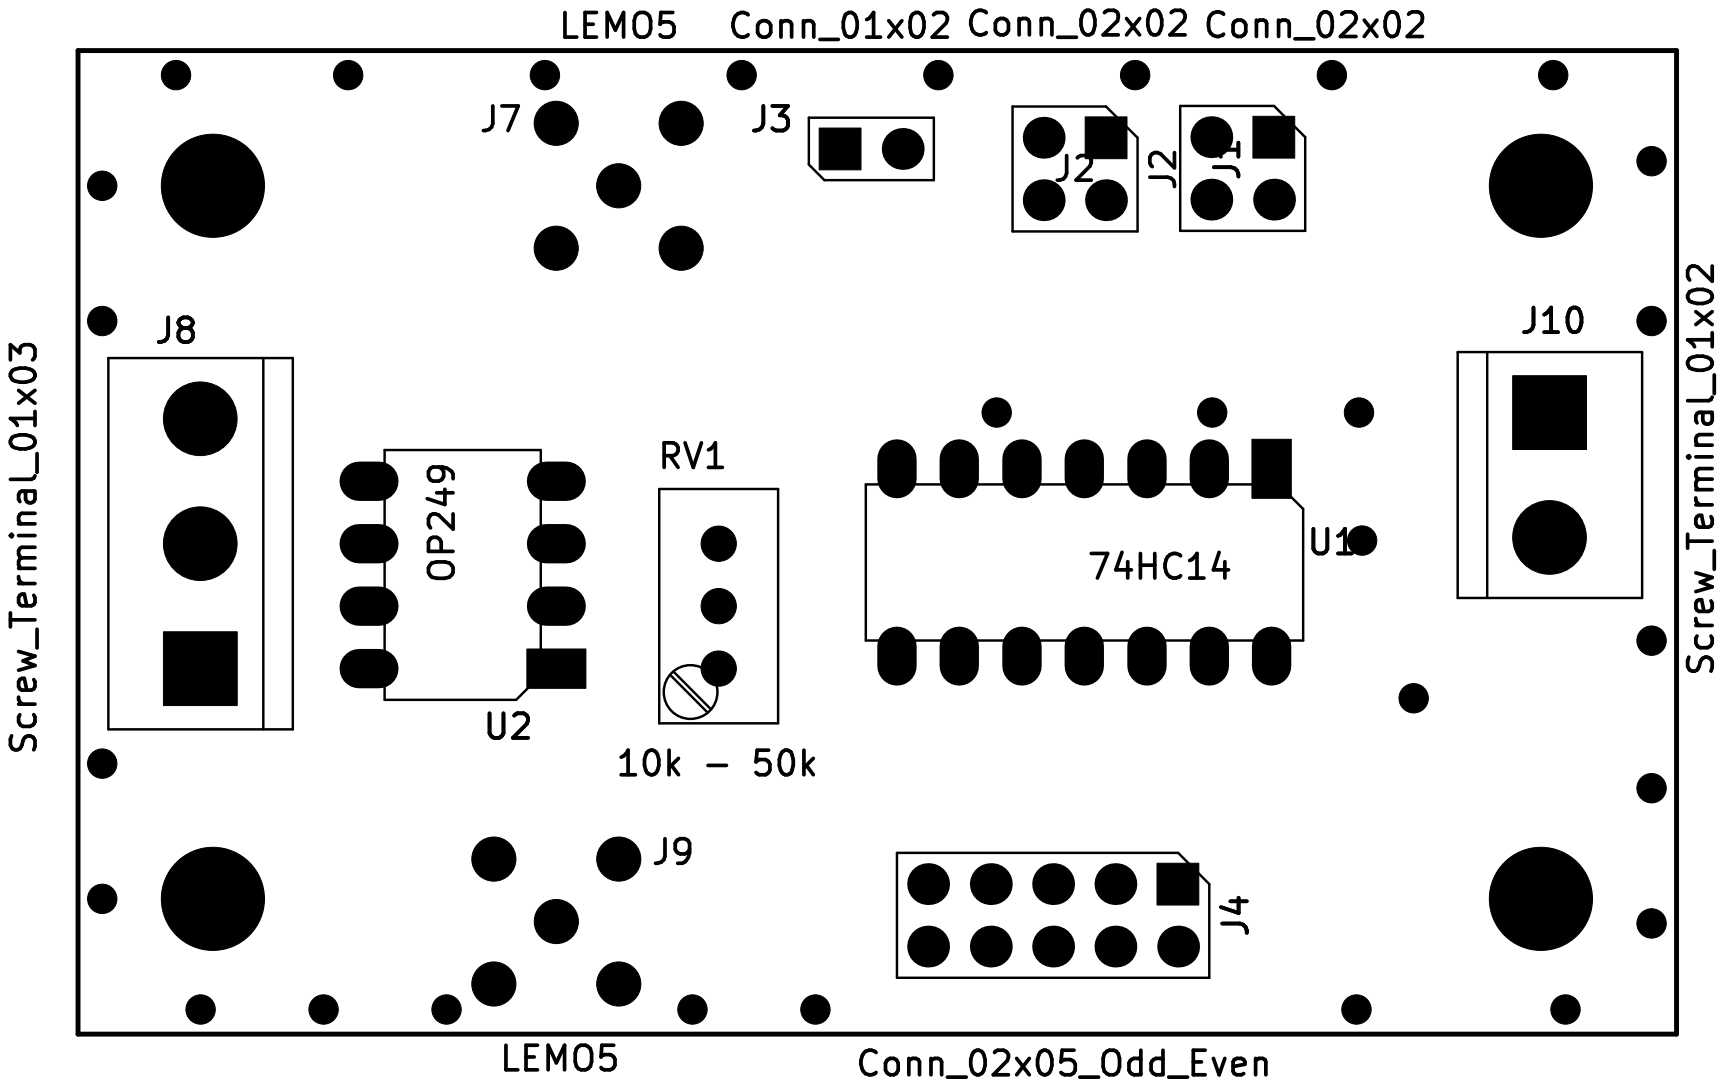
[picture p220: page 1]
