Aldarme/PROJECT_CHAMP/ST50_Docs/rapport/AOP_PRINTING_IMPRESS_SCHEMATIC.pdf

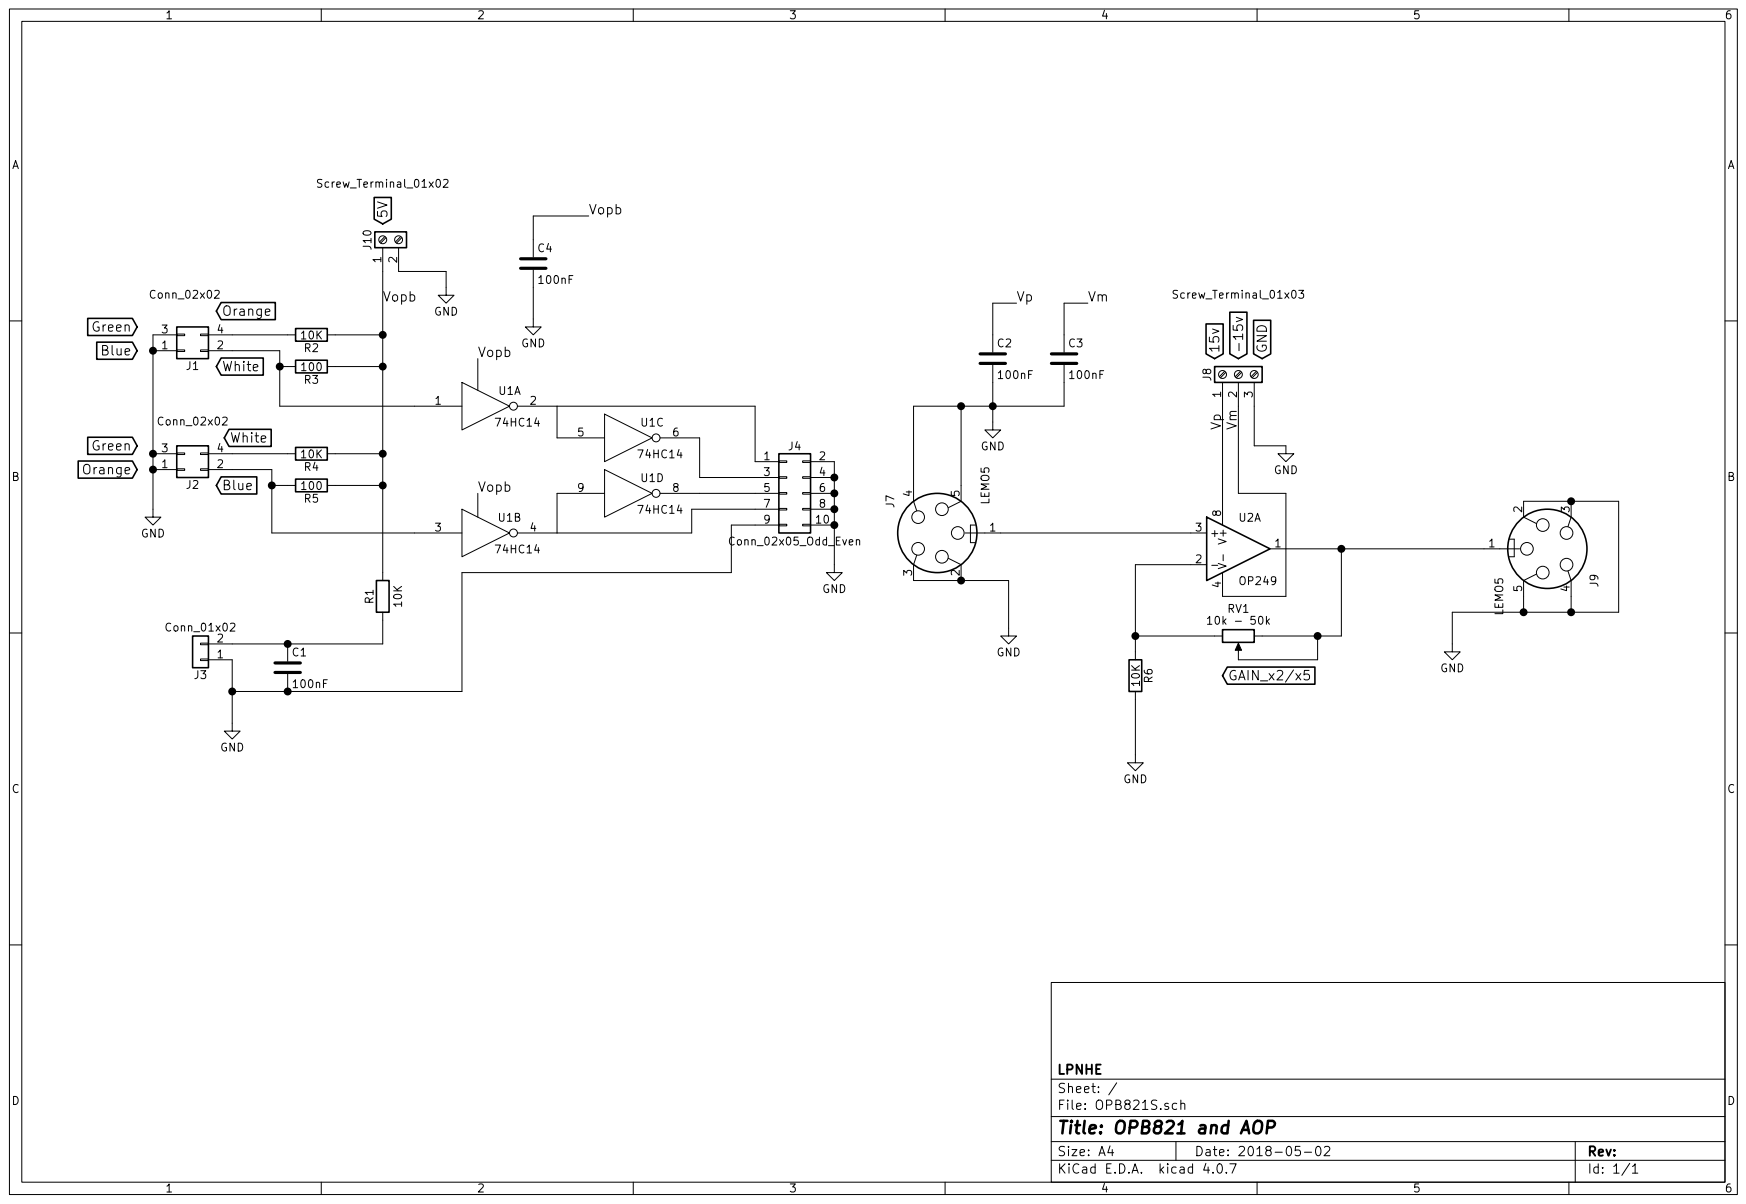
[picture p221: page 1]
