Aldarme/PROJECT_CHAMP/ST50_Docs/rapport/PLAN_CABLAGE_TOP_ELEMENTS_EVALBOARD.pdf

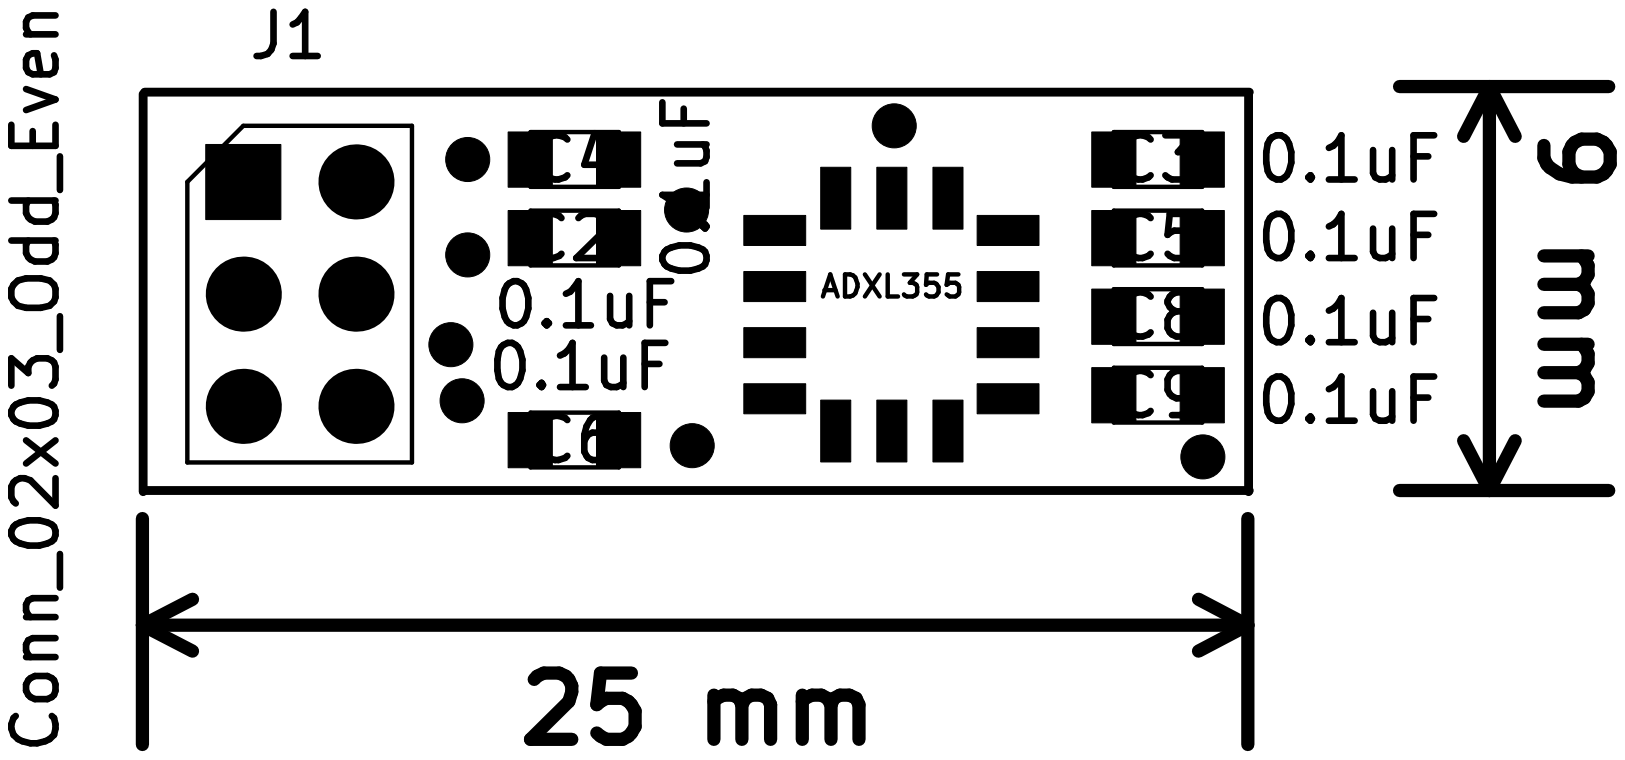
[picture p222: page 1]
