Aldarme/PROJECT_CHAMP/ST50_Docs/rapport/PLAN_PERCAGE_EVALBOARD.pdf

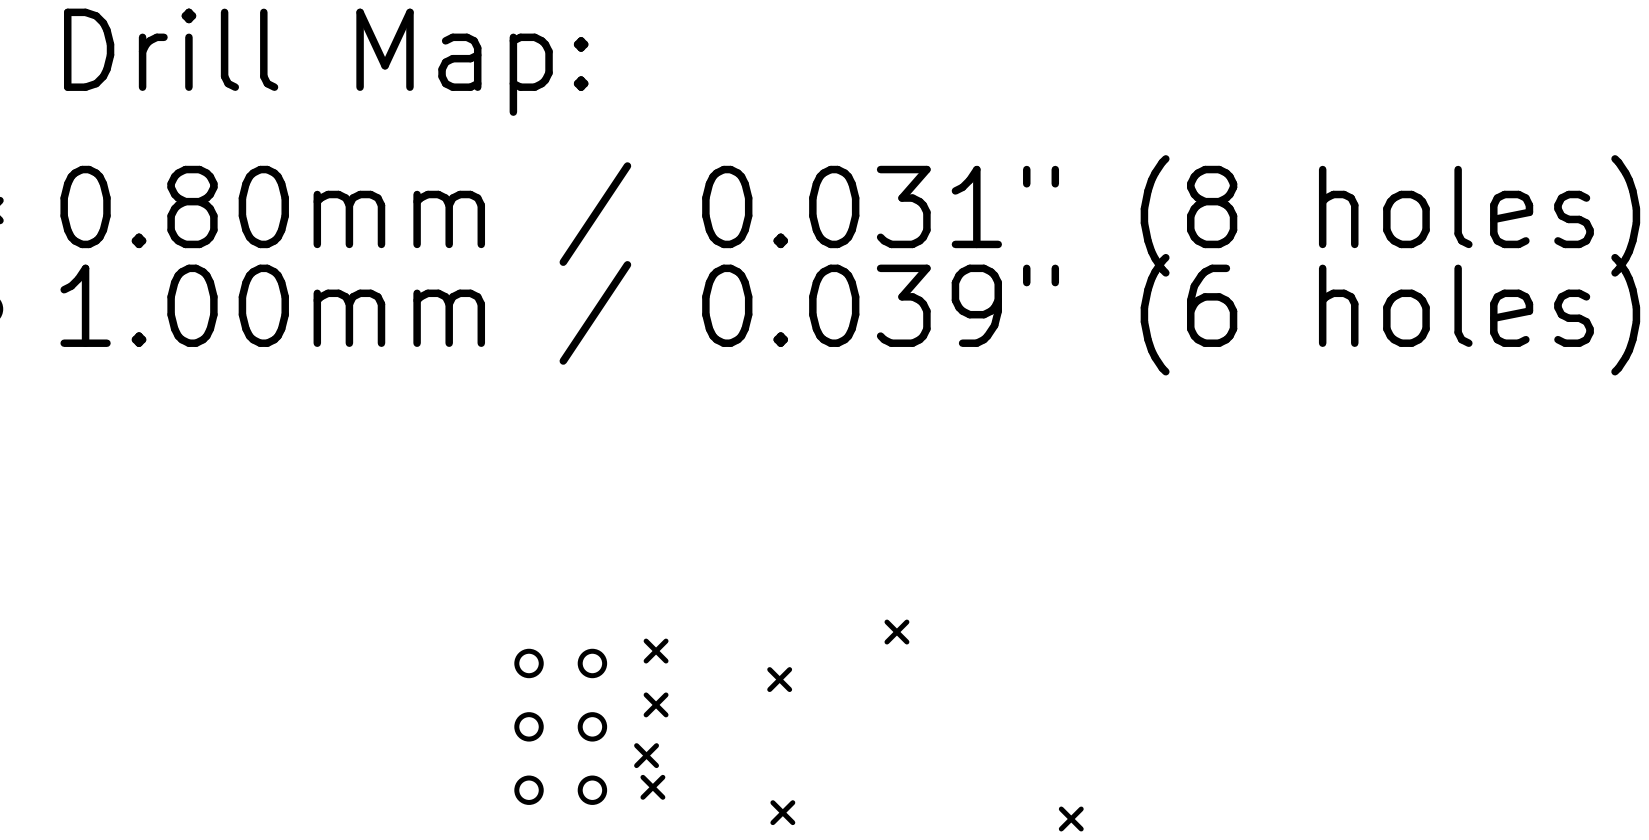
[picture p223: page 1]
