Aldarme/PROJECT_CHAMP/ST50_Docs/rapport/AOP_FICHIER_DIMENSION_OPBANDAOP.pdf

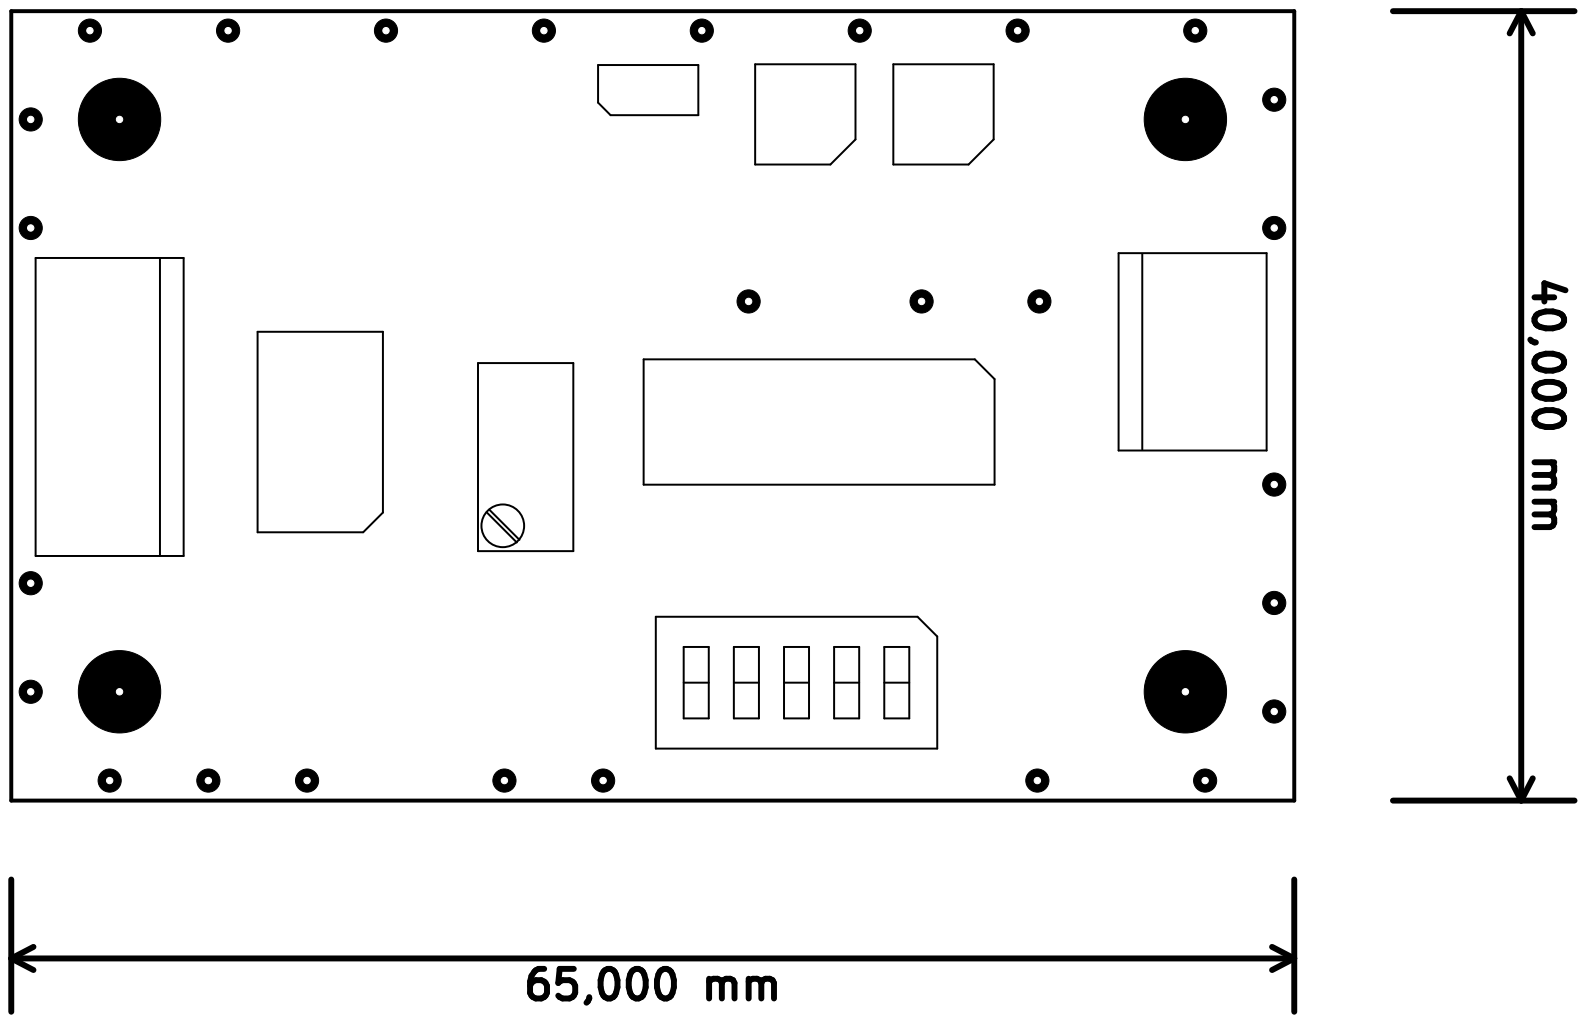
[picture p224: page 1]
