Aldarme/PROJECT_CHAMP/ST50_Docs/rapport/EVAL_Printing_Impression_Schematique.pdf

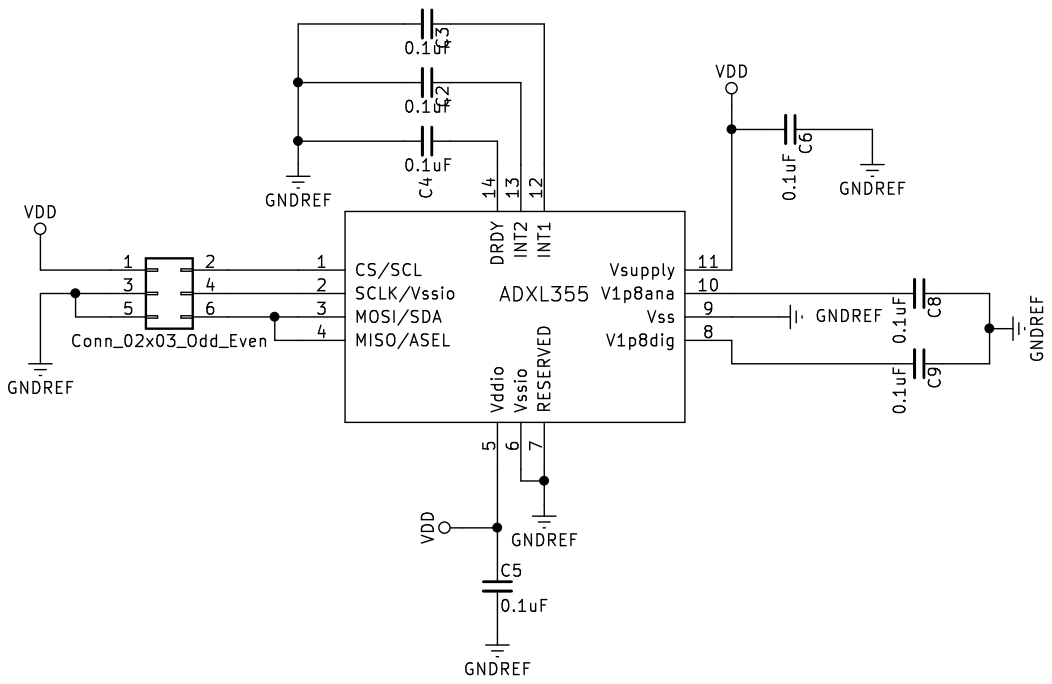
[picture p225: page 1]
