Aldarme/PROJECT_CHAMP/PCB/KIONIX-KX224/Serigraphie.pdf

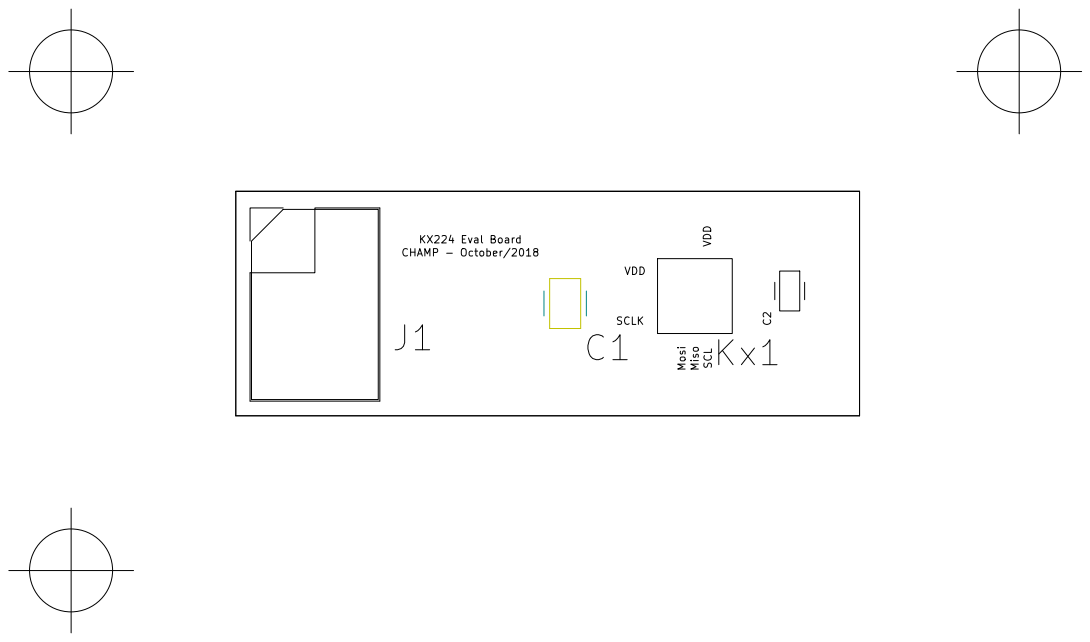
[picture p226: page 1]
