Aldarme/PROJECT_CHAMP/PCB/ST-AIS3624/Serigraphie.pdf

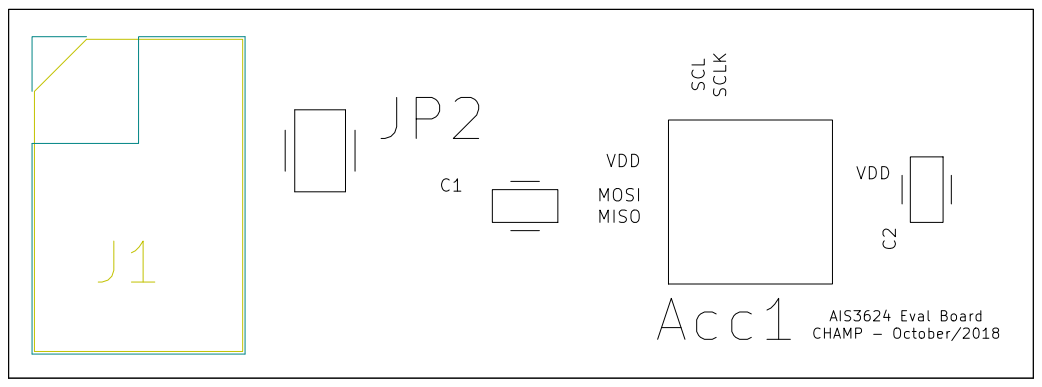
[picture p227: page 1]
