Aldarme/PROJECT_CHAMP/PCB/KIONIX-KX224/KIONIX-KX224.kicad_pcb

## KiCad design PCB/KIONIX-KX224/KIONIX-KX224.kicad_pcb (2018-11-27)

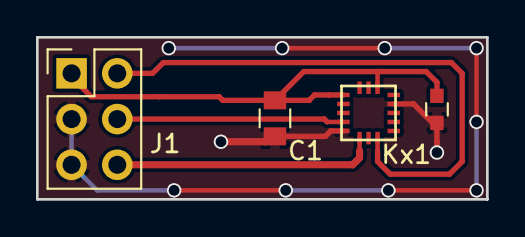
[picture p228: board KIONIX-KX224.kicad_pcb from above]

Board: 2 copper layers, 25.0 x 9.0 mm, 4 parts (0 on the bottom side), 5 nets.

Parts:
C1: 100nF; C_0805
C2: 100nF; C_0603
J1: Conn_02x03_Odd_Even; Pin_Header_Straight_2x03_Pitch2.54mm
Kx1: KX224

Connections:
/CS/SCL: J1.2, Kx1.8
/Miso/Mosi: J1.6, Kx1.6
/SCLK: J1.4, Kx1.4
/VDD: C1.1, C2.1, J1.1, Kx1.1, Kx1.14
GNDREF: C1.2, C2.2, J1.3, J1.5, Kx1.5, Kx1.12
