Aldarme/PROJECT_CHAMP/PCB/ST-AIS3624/ST-AIS3624.kicad_pcb

## KiCad design PCB/ST-AIS3624/ST-AIS3624.kicad_pcb (2018-11-16)

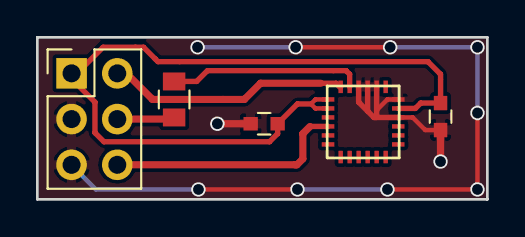
[picture p229: board ST-AIS3624.kicad_pcb from above]

Board: 2 copper layers, 25.0 x 9.0 mm, 5 parts (0 on the bottom side), 6 nets.

Parts:
AIS36241: AIS3624DQTR; ADIS3624DQ
C1: 100nF; C_0603
C2: 10uF; C_0603
J1: Conn_02x03_Odd_Even; Pin_Header_Straight_2x03_Pitch2.54mm
JP2: Jumper; C_0805

Connections:
/CS/SCL: AIS36241.12, J1.2
/Miso/Mosi: AIS36241.16, J1.6
/SCLK: AIS36241.11, JP2.2
/VDD: AIS36241.5, AIS36241.13, AIS36241.14, C1.1, C2.1, J1.1
GNDREF: AIS36241.4, AIS36241.6, AIS36241.8, AIS36241.9, AIS36241.10, C1.2, C2.2, J1.3, J1.5
unnamed: J1.4, JP2.1
