Aldarme/PROJECT_CHAMP/PCB/accel_evalBoard/accel_evalBoard.kicad_pcb

## KiCad design PCB/accel_evalBoard/accel_evalBoard.kicad_pcb (2018-10-29)

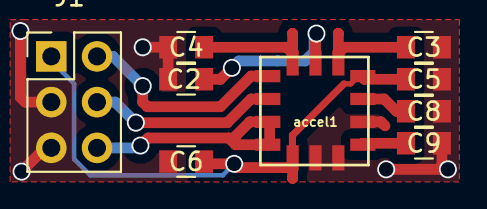
[picture p230: board accel_evalBoard.kicad_pcb from above]

Board: 2 copper layers, 9 parts (0 on the bottom side), 10 nets.

Parts:
C2, C3, C4, C5, C6, C8, C9: 0.1uF; C_0805
J1: Conn_02x03_Odd_Even; Pin_Header_Straight_2x03_Pitch2.54mm
accel1: ADXL355

Connections:
GNDREF: C2.2, C3.2, C4.2, C5.2, C6.1, C8.1, C9.1, J1.3, J1.5, accel1.6, accel1.7, accel1.9
unnamed: C2.1, accel1.13
unnamed: C3.1, accel1.12
unnamed: C4.1, accel1.14
unnamed: C8.2, accel1.10
unnamed: C9.2, accel1.8
unnamed: J1.2, accel1.1
unnamed: J1.4, accel1.2
unnamed: J1.6, accel1.3, accel1.4
VDD: C5.1, C6.2, J1.1, accel1.5, accel1.11
