Aldarme/PROJECT_CHAMP/PCB/mezzanine_monoAcc/mezzMonoAcc.kicad_pcb

## KiCad design PCB/mezzanine_monoAcc/mezzMonoAcc.kicad_pcb (2018-05-25)

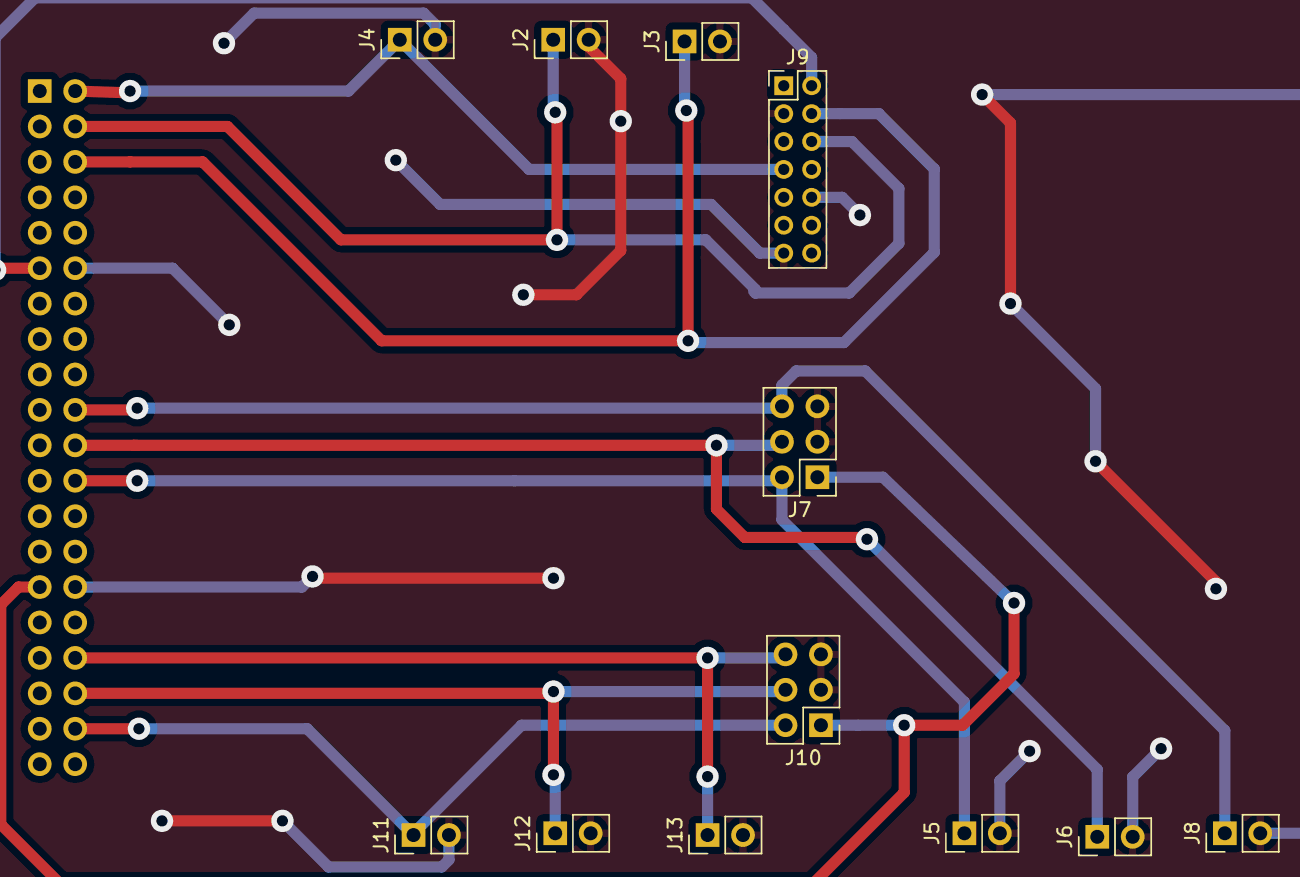
[picture p231: board mezzMonoAcc.kicad_pcb from above]

Board: 2 copper layers, 13 parts (1 on the bottom side), 12 nets.

Parts:
J1: Conn_02x20_Odd_Even; Socket_Strip_Straight_2x20_Pitch2.54mm
J2, J3, J4, J5, J6, J8, J11, J12, J13: Conn_01x02; Pin_Header_Straight_1x02_Pitch2.54mm
J7, J10: Conn_02x03_Odd_Even; Pin_Header_Straight_2x03_Pitch2.54mm
J9: Conn_02x07_Odd_Even; Pin_Header_Straight_2x07_Pitch2.00mm

Connections:
/ACC_CLK_1: J1.22, J6.1, J7.4
/ACC_CLK_2: J1.36, J10.4, J12.1
/ACC_CS_1: J1.24, J5.1, J7.2
/ACC_CS_2: J1.38, J10.2, J11.1
/ACC_MI/MO_1: J1.20, J7.6, J8.1
/ACC_MI/MO_2: J1.34, J10.6, J13.1
/DAC_CLK: J1.6, J3.1, J9.4
/DAC_CS: J1.4, J2.1, J9.6
/DAC_MISO: J1.2, J4.1, J9.7
/VDD(3.3V): J1.29, J7.1, J10.1
/VDD(5V): J1.11, J9.2
GNDREF: J1.12, J1.30, J2.2, J3.2, J4.2, J5.2, J6.2, J7.3, J7.5, J8.2, J9.3, J9.10, J9.13, J10.3, J10.5, J11.2, J12.2, J13.2
