Aldarme/PROJECT_CHAMP/(commit log)

2018-02-21 Debug SPI MASTER when SS = 1 -> SCLOCK = 0
2018-02-27 Hack 4 wire SPI into a 3 wire SPI
2018-02-27 FIX BUG - SPI 3 wires register configuration
    [spi_master.vhd]
2018-03-02 Create top entity to control ACCEL & FILTER & DAC
2018-03-02 create Filter entity
2018-03-05 Compile module, composed of : SPI_ACCEL & Filter & SPI_dac
2018-03-07 PCB for accel evalBoard
    [accel_evalBoard.kicad_pcb, accel_evalBoard.sch]
2018-03-07 PCB png for report
2018-03-09 Add PCB 2.3
    [accel_evalBoard.kicad_pcb, accel_evalBoard.sch, evalBoard_1.0.kicad_pcb, evalboard_2.0.kicad_pcb]
2018-03-09 AOP for generator signal
    [AOP_evalBoard.kicad_pcb, AOP_evalBoard.sch]
2018-03-27 EvalBoard for test with OPB821S & OP
    [OPB821S.kicad_pcb, OPB821S.sch]
2018-03-27 VHDL - ADD FILFO for SPI DAC
2018-03-28 elements deleted
    [AOP_evalBoard.kicad_pcb, AOP_evalBoard.sch]
2018-03-28 evalBoard ended - docs produce for report
    [accel_evalBoard-B.Cu.gbr, accel_evalBoard-F.Cu.gbr, accel_evalBoard-F.Fab.gbr]
2018-03-28 OPB board ended - docs produce for report
    [OPB821S.kicad_pcb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]
2018-03-29 add last document & convert line in class 4
    [OPB821S.kicad_pcb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]
2018-03-29 add last doc & convert line in class 4
    [FAB_OPBANDAOP.xls, FICHE_LIAISON_SCHEMA_PCB_NEWS.xls, accel_evalBoard.kicad_pcb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]
2018-04-06 add filter file to adapte to generate
2018-04-24 fix error for photoContactor connexion
    [OPB821S.kicad_pcb, OPB821S.sch]
2018-04-25 Update ground plan & connexion to accel
    [accel_evalBoard.kicad_pcb]
2018-04-27 fix bug on FIFO
    [GenEntity.vhd, GenEntity_tb.vhd, Gen_spi_DAC.vhd, Gen_spi_accel.vhd]
2018-05-02 Update - prototype tested and fonctional
    [OPB821S.kicad_pcb, OPB821S.sch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]
2018-05-02 integrate guard ring into the ground plane
    [OPB821S.kicad_pcb]
2018-05-02 rescale data to have 8g -> 10v, 1g -> 1.25v
2018-05-04 update PCB eval board
2018-05-11 uart Tx and Rx finished
2018-05-14 update evalBoard_2.3 docs
    [accel_evalBoard.kicad_pcb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]
2018-05-18 add accélération representation data
    [g.xlsx]
2018-05-22 filter-implement multiArch for test bench
2018-05-24 New PCB - Mezza mono Acc
    [mezzMonoAcc.kicad_pcb, mezzMonoAcc.sch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]
2018-05-24 minor update for PCB
    [FAB_OPBANDAOP.xls, FICHE_FABRICATION_.xls, FICHE_LIAISON_SCHEMA_PCB_NEWS.xls]
2018-05-25 fix error pin assignment - 5v DAC pin2
    [mezzMonoAcc.kicad_pcb, mezzMonoAcc.sch]
2018-05-25 docs pcb mezza - wiring map with drilling hole
2018-05-25 filter - add DAC "gain" control by switch
2018-05-28 filter - add 7segmt to display signal's divisor
2018-05-29 filter - search to have pos & neg value
2018-05-29 any update
    [g.xlsx]
2018-05-31 filter - filter_mapBit allow to have signal from -8g to +8g
2018-06-01 filter - update bitMap function with signal division (arti gain for ADC)
2018-06-05 spi_dac - used new IP_FIFO to avoid metastability
    [TopEntity.vhd, spiDac_tb.vhd, spi_DAC.vhd]
2018-06-21 graph pour établissement de la function de transfère
    [Analyse.xlsx, AnalyseFTP.xlsx]
2018-06-22 add info parametrage oscillo
    [Analyse.xlsx]
2018-06-22 Asservissement - Analysis & data
    [1v10hz4.csv, 1v10hz5.csv, 1v10hz6.csv, 1v20hz3.csv, 1v30hz.csv, 1v40hz2.csv, 1v50hz1.csv, 2v100hz3.csv]
2018-06-22 Filter - add integration signal to obtain speed and position from signal
2018-07-05 3D_print accelerometer support for piano.
    This support is a first proto, used for technical tests. a new one will be prepare in case of trubble with gaming experience.
2018-07-05 Asservissement - doc to establish transfert function
    [3v100hz.csv, 3v100hz.xlsx, 3v20hz.xlsx, 3v20hz5.csv, 3v30hz4.csv, 3v30hz4.xlsx, 3v40hz3.csv, 3v40hz3.xlsx]
2018-07-09 ST50 - fiche de suivis de dernière semaine
2018-07-11 report - refonte de la présentation des expérience mené par le labos
2018-07-12 Document de prise en main de l'arbo du projet
2018-07-12 Détail avant fin stage
    [Analyse.xlsx, AnalyseAnIn.xlsx]
2018-07-23 report - TODO "hack" SPI bus
    [2018 07 P Romet EVALUATION STAGIAIRE - STUDENT ASSESSMENT ver fev 2018.xlsx]
2018-08-09 report - update "Hack protocol SPI" with good practice for manip
2018-09-10 documentation - new accelerometers
2018-09-12 filter - new algo for sldding avrg && new state mach for integ acc&speed
2018-09-17 filter-define a dedicate acceleration-average process
2018-10-02 ASP-fix bug - structural bug with multiple access to a structure
    [ASP_spi_DAC.vhd]
2018-10-02 ST-create projet for AIS3624 new pcb
    [ST-AIS3624.kicad_pcb, ST-AIS3624.sch]
2018-10-09 PCB-add layout & pcb for AIS3624
    [ST-AIS3624.sch]
2018-10-09 PCB - accel_evalboard delete internal librarie
2018-10-09 PCB - OPB delete internal librarie
    [OPB821S.kicad_pcb]
2018-10-09 PCB - create a mutialized librairie for components & footprint
2018-10-10 PCB - stag new accelerometer KIONIX KX224
    [KIONIX-KX224.kicad_pcb, KIONIX-KX224.sch]
2018-10-10 PCB - update KX224
    [KIONIX-KX224.kicad_pcb, KIONIX-KX224.sch]
2018-10-22 PCB - Kionix v 1.5, ready to print
    [KIONIX-KX224.kicad_pcb, KIONIX-KX224.sch]
2018-10-22 PCB - ST-AIS v 1.5, ready to print
    [ST-AIS3624.kicad_pcb, ST-AIS3624.sch]
2018-10-23 docs - configuration file for accelerometer registers
    [Configuration_Registres_Accelerometres_&_SPI_trames.txt]
2018-10-23 docs - switch "ETAT de l'art" file to uncrypted file
2018-10-23 docs - configuration file, fix mistake
    [Configuration_Registres_Accelerometres_&_SPI_trames.txt]
2018-10-24 PCB - AIS3624 update after review with meca staff
    [ST-AIS3624.kicad_pcb, ST-AIS3624.sch]
2018-10-24 PCB - KX224 update after review with meca staff
    [KIONIX-KX224.kicad_pcb, KIONIX-KX224.sch]
2018-10-24 PCB - KX224 fix via wiring mistake
    [KIONIX-KX224.kicad_pcb]
2018-10-24 PCB - KX224 update & manufacturing files
    [KIONIX-KX224-B.Cu_BOTTOM.gbr, KIONIX-KX224-B.Mask_VERNIS_BOTTOM.gbr, KIONIX-KX224-B.Paste_POCHOIR_BOTTOM.gbr, KIONIX-KX224-F.Cu_TOP.gbr, KIONIX-KX224-F.Mask_VERNIS_EPARGNE_TOP.gbr]
2018-10-24 PCB - Update of the library of components
2018-10-24 PCB - KX224 little modif
    [KIONIX-KX224.kicad_pcb]
2018-10-25 PCB - KX224 update to have file conform to manufacturate PCB
    [KIONIX-KX224.kicad_pcb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]
2018-10-29 Docs - Kx224 add archive controle pcb
    [KIONIX-KX224.drl]
2018-10-29 Docs - AIS3624 add archive controle pcb & minor update
    [ST-AIS3624.kicad_pcb]
2018-10-29 Docs - ADXL355 add archive controle pcb & minor update
    [accel_evalBoard.kicad_pcb]
2018-10-29 Docs - add globale archive controle PCB file
2018-10-30 Docs - administrative doc to command PCBs
    [COMMANDE__EVALBOARD&POCHOIR_ACC_KX224.xlsx]
2018-10-31 ASP - write KX224 behavior to test his SPI protocole
2018-11-05 ASP - KX beh fix little bugs
    [ASP_KX224_beh.vhd]
2018-11-05 ASP - fix fatal error in nbr of write bit into "transmit to slave"
    [ASP_spi_master_Rw_adaptative_wordLenght.vhd]
2018-11-05 Docs - fix mistake into hex value to set ODR at 1600Hz
    [Configuration_Registres_Accelerometres_&_SPI_trames.txt]
2018-11-06 PCB - KX224 add missing "drill files"
    [KIONIX-KX224-drl_map.gbr, KIONIX-KX224.drl]
2018-11-12 PCB-AIS3624 v2.0 verified
    [ST-AIS3624.kicad_pcb, ST-AIS3624.sch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]
2018-11-12 Docs - docs for AIS3624 v2.0 update
    [liste_composants_AIS3624.xlsx]
2018-11-12 Docs - AIS3624 update liste composant
    [ST-AIS3624.kicad_pcb]
2018-11-12 PCB - KX224 V2.0 verified
    [KIONIX-KX224-B.Cu_BOTTOM.gbr, KIONIX-KX224-B.Mask_BOTTOM_VERNIS_EPARGNE.gbr, KIONIX-KX224-B.Paste_POCHOIR.gbr, KIONIX-KX224-F.Cu_TOP.gbr, KIONIX-KX224-F.Mask_TOP_VERNIS_EPARGNE.gbr, KIONIX-KX224-drl_map.plan_Percage.gbr, KIONIX-KX224.drl, KIONIX-KX224.fichier_Percage.drl]
2018-11-12 Docs - docs for KX224 v2.0 Update
    [liste_composants_AIS3624.xlsx, liste_composants_KX224.xlsx]
2018-11-16 Docs - update register configuration for accelerometers
    [Configuration_Registres_Accelerometres_&_SPI_trames.txt]
2018-11-16 Docs - update AIS3624 F.CU to fiw bad wiring
2018-11-16 PCB - AIS3624 fix bad wiring for SPI interface 3-wire
    [ST-AIS3624.kicad_pcb, ST-AIS3624.sch]
2018-11-16 ASP - SPI-DAC fix unstable parameter
    [ASP_spi_DAC.vhd]
2018-11-16 ASP - Filter Speed & position zero at rest -OK need to dev a fctio adder
2018-11-21 ASP - spi master comment modif
2018-11-21 ASP - DAC major maj - optimize resynchro register, R/W fifo, SPI Read
2018-11-23 docs - add new data into acceleration info
    [Classeur1.xlsx]
2018-11-26 Docs - excel accel file
    [Classeur1.xlsx]
2018-11-26 ASP - filter integrate speed & pos - still cnt bug to fix
    [ASP_filter.vhd]
2018-11-27 PCB - kionix, fix pin wiring mistake
    [KIONIX-KX224.kicad_pcb, KIONIX-KX224.sch]
2018-11-27 ASP - filter - Functional
2018-11-28 Docs - add paper docs & latest development
    [Classeur1.xlsx]
2018-11-28 ASP - filter spd&pos integrator simu:OK; in real: diverge
2018-11-28 Docs - Range G - signed - unsigned
    [Classeur1.xlsx, g.xlsx, range_G_Signed_Unsigned.xlsx]
2018-11-29 ASP - Calibration en vitesse & position validé avec antoine
