Aldarme/PROJECT_CHAMP/(notices)

Notices in the files:
ST50_Docs/BHLS-CNRS-UPMC-LPNHE-IRCAM.pdf:
] Le rapport de la masse de la corde à la masse du marteau se révèle ici le facteur déterminant.” par René Caussé dans Résonance nº 5, septembre 1993 Copyright © IRCAM [6]
[7] Le poids au toucher de la mécanique du piano à queue, © 2006 Bill Spurlock, www.spurlocktools.com, © juin 2013 Montpellier traduction de Marc Valdeyron
